shihkefa/esp32c3-card-dealer/README.md

# ESP32-C3 撲克牌發牌機

以 ESP32-C3 SuperMini、28BYJ-48 步進馬達、直流馬達及 3D 列印零件製作的充電式旋轉發牌機。目前版本為 **V1.0.0**。

本頁下載與線上手冊跟隨 `main` 分支的最新修正；`V1.0.0` 標籤保留初次上傳快照。

## 下載與組裝

- **[線上 3D 組裝說明書](https://shihkefa.github.io/esp32c3-card-dealer/)**：直接用電腦或手機開啟，可旋轉、縮放及分解模型，不必先下載。
- [完整專案 ZIP](發牌機_完整專案_V1.0.0.zip)：包含模型、BOM、接線圖、韌體及離線組裝手冊。
- [版本說明與使用入口](V1.0.0/README_先讀這個.txt)
- [Excel BOM](V1.0.0/發牌機_BOM_V1.0.0.xlsx)
- [40 種獨立列印零件](V1.0.0/3d/STL/)
- [整機組裝 STL](V1.0.0/發牌機_整機組裝_V1.0.0.stl)：供檢視組裝位置，請使用獨立零件列印。
- [可修改的 CAD 來源](V1.0.0/3d/source/)
- [韌體來源與燒錄說明](V1.0.0/firmware/)
- [完整接線圖與板型參考](V1.0.0/wiring/)

線上版與離線版使用同一份完整手冊，含 22 個步驟、可旋轉及縮放的 3D 模型、零件與螺絲選取，以及互動接線圖。需要離線使用時，下載並解壓 ZIP，再用瀏覽器開啟 `V1.0.0/manual/發牌機_組裝說明書_V1.0.0.html`。

## 目前設計

- 每局將出牌口朝向第一位玩家；三人逐張轉 120°，四人逐張轉 90°。
- 設定每人張數、玩家人數及餘牌張數；餘牌發往第一、第二位玩家中間。
- 牌倉內寬 61 mm、前後開放，底板與兩側擋板連續封實，底牌取牌輪由預留開口露出；牌路向出牌口下傾 6°，靠重力落牌。參考牌型為 57×87 mm 與 60×96 mm。
- OLED 與四個按鍵位於上殼頂部；韌體預設關閉 Wi-Fi 與 BLE。
- 使用單顆 18650、Type-C 充電；依本版接線說明關機充電。
- 列印件以拓竹 A1 mini 的尺寸範圍設計；螺絲採 M3×8 與 M3×25 內六角沉頭兩種規格。

## 最新機構修訂

P08 改為 **2.4 mm 連續底板與實心兩側擋板**，保留原本約 **23 × 12 mm** 的取牌輪開口及固定孔。兩側頂緣在 6° 傾斜組裝後保持水平，與上殼屋頂外表面切齊；牌倉前後仍然開放，內寬仍為 **61 mm**。底板背面的馬達避空為盲凹槽，不貫穿牌面。

這次重印 **P08**；使用 57 mm 窄牌時，另重印兩片配套掛架版 **P12**。P12 導牌本體仍落在牌倉底面，中央掛架適配高側板，左右使用同一個 STL。除了 P08 與選配 P12，其他 **38 種 STL**、安裝位置及五金用量均沿用。

先前 P04B 齒圈被承載盤／馬達固定孔誤切的缺口已修復，**60 齒、全齒寬 7.5 mm** 的連續齒形保留。

P04A 與 P02A 頂圈的 **2 mm** 名義間隙、上半部抬高 **1.5 mm**、原軸承與滑環高度及所有五金位置均維持。如果尚未更新到先前的 2 mm 間隙設計，仍需搭配薄片向下延長 1.5 mm 的 P26。

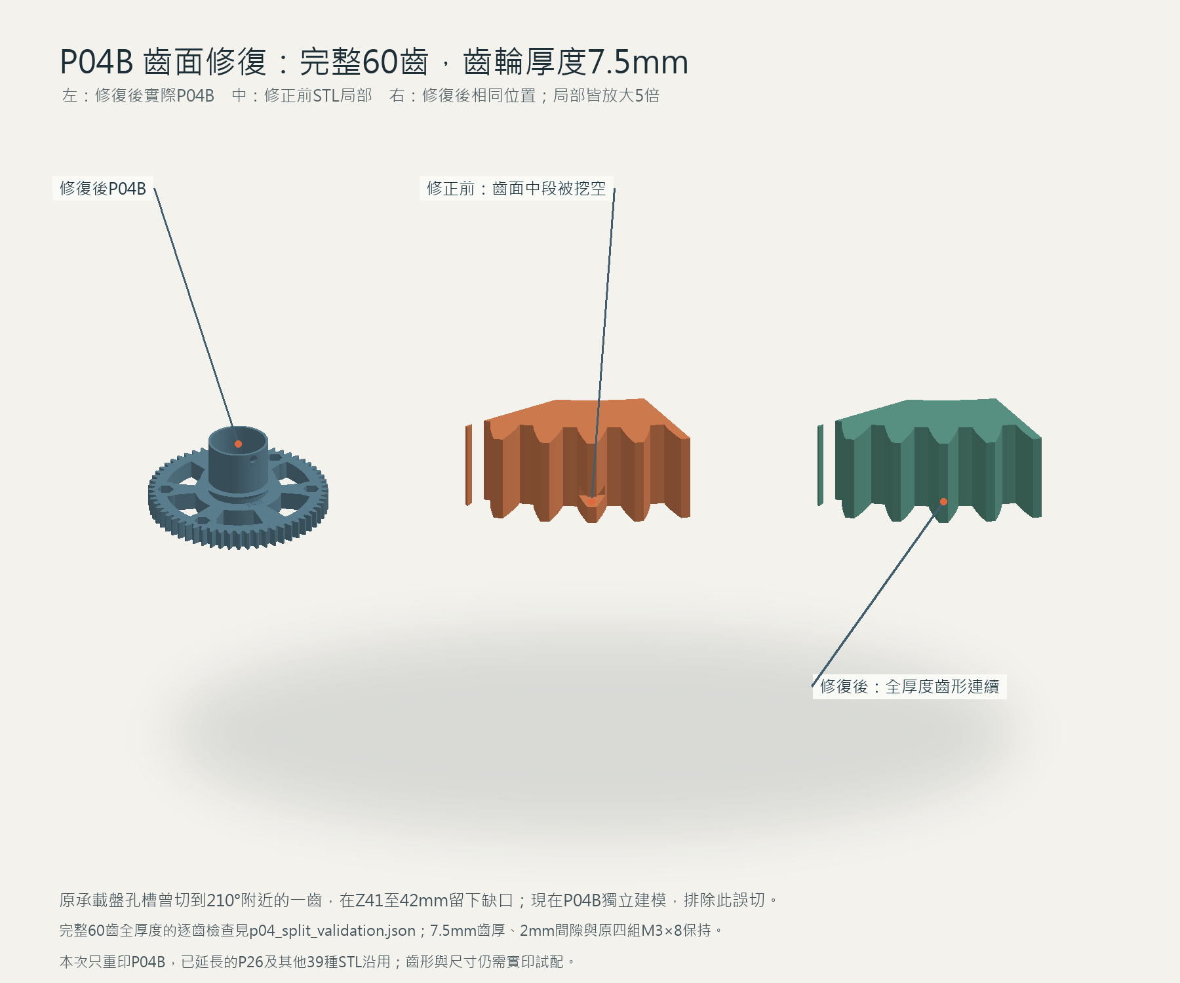
[picture p1: V1.0.0/3d/P04B_完整60齒檢查.png]
P04B 完整 60 齒檢查


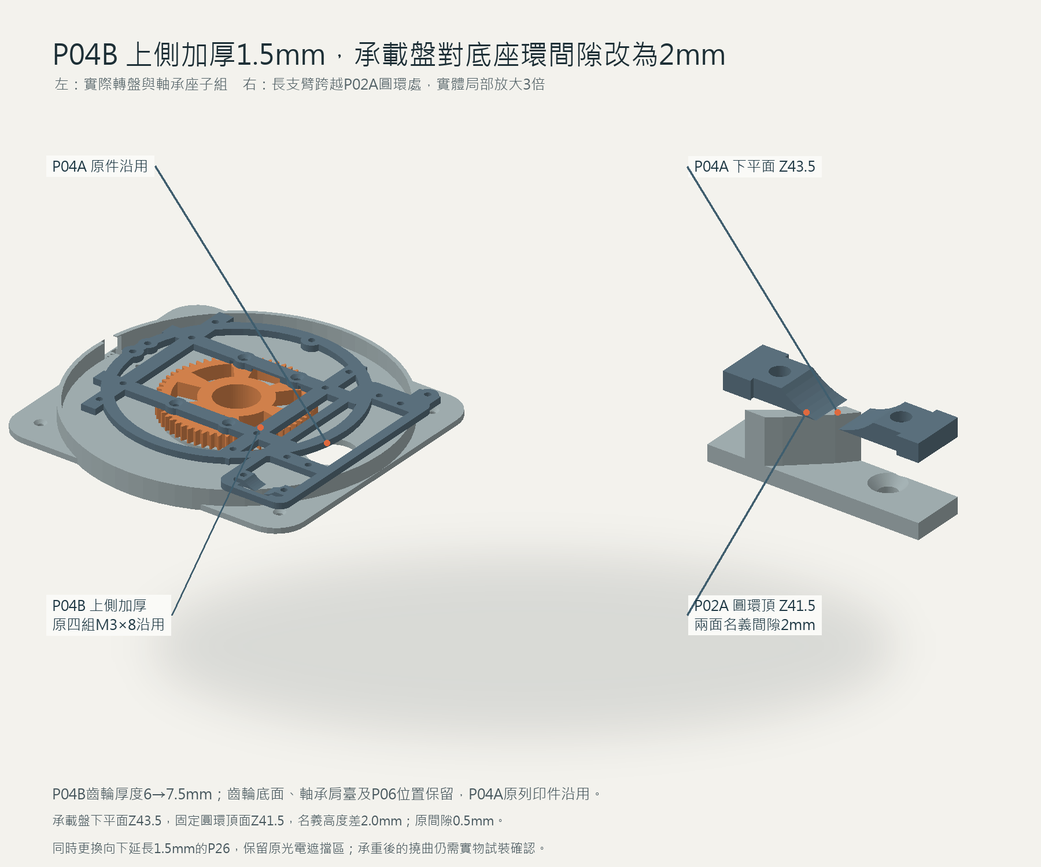
[picture p2: V1.0.0/3d/P04B_抬高與2mm間隙.png]
P04B 加厚與 2 mm 間隙


版本維持 V1.0.0。`main` 與線上手冊提供目前修正內容；Git 標籤 `V1.0.0` 保留首次上傳的快照。

## 驗證與限制

本版已完成模型干涉、離散旋轉及裝入路徑、螺絲螺母配合、STL 完整性和離線手冊的檢查，紀錄位於 [verification](V1.0.0/verification/) 及 [3d](V1.0.0/3d/)。這些是名義模型驗證；載重撓曲、實印公差、實際模組尺寸、耗電及發牌速度仍需試裝與實測。現有 28BYJ-48 與外部 2:1 減速配置不能保證逐張轉向時每秒 2～4 張。

[SHA-256 檔案校驗表](V1.0.0/SHA256SUMS.txt) 對應版本資料夾內的交付檔；本儲存庫保留原始位元組，避免換行轉換影響校驗。

第三方元件、文件與程式庫保留其原有來源及授權說明。

## 更新線上手冊

重新建立版本資料夾中的手冊後，執行 `python scripts/update_pages.py --version V1.0.0`，再將更新後的 `docs/` 提交並推送到 `main`。GitHub Pages 從 `main` 的 `/docs` 發布，入口為 `docs/index.html`；`.nojekyll` 保留原始 HTML，Three.js 授權另置於同目錄。
