shihkefa/esp32c3-card-dealer/V1.0.0/3d/P02B_螺母槽近照.png

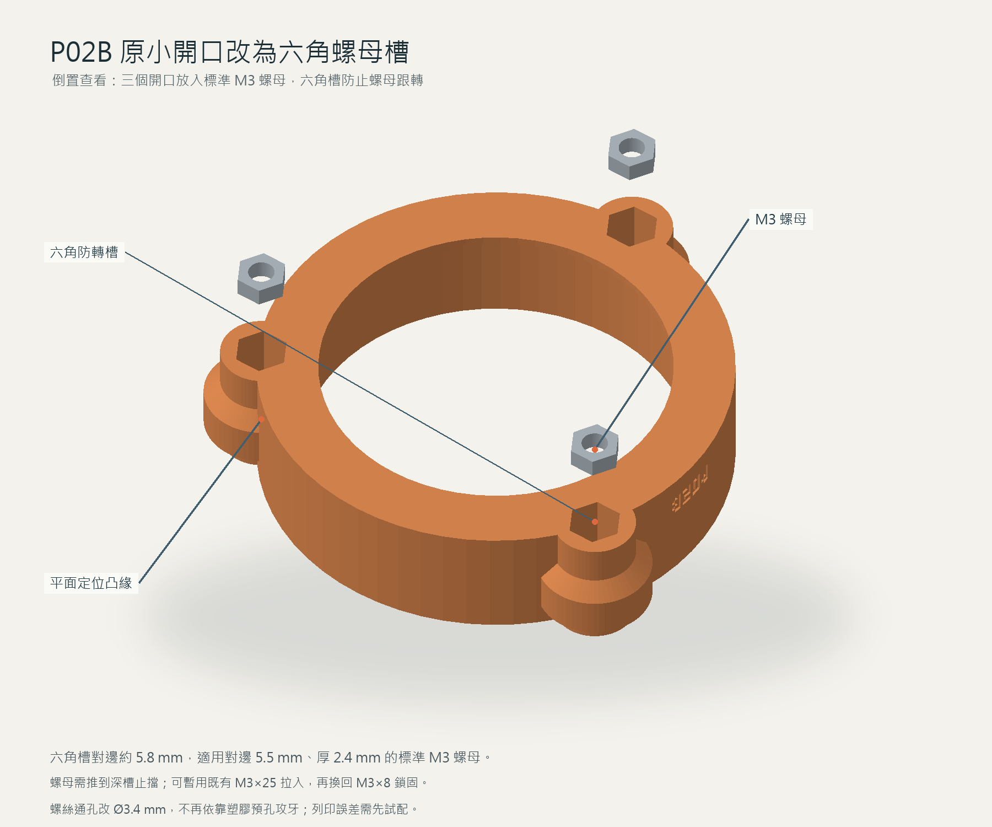
V1.0.0/3d/P02B_螺母槽近照.png
