shihkefa/esp32c3-card-dealer/V1.0.0/3d/P04_分件組裝說明.png

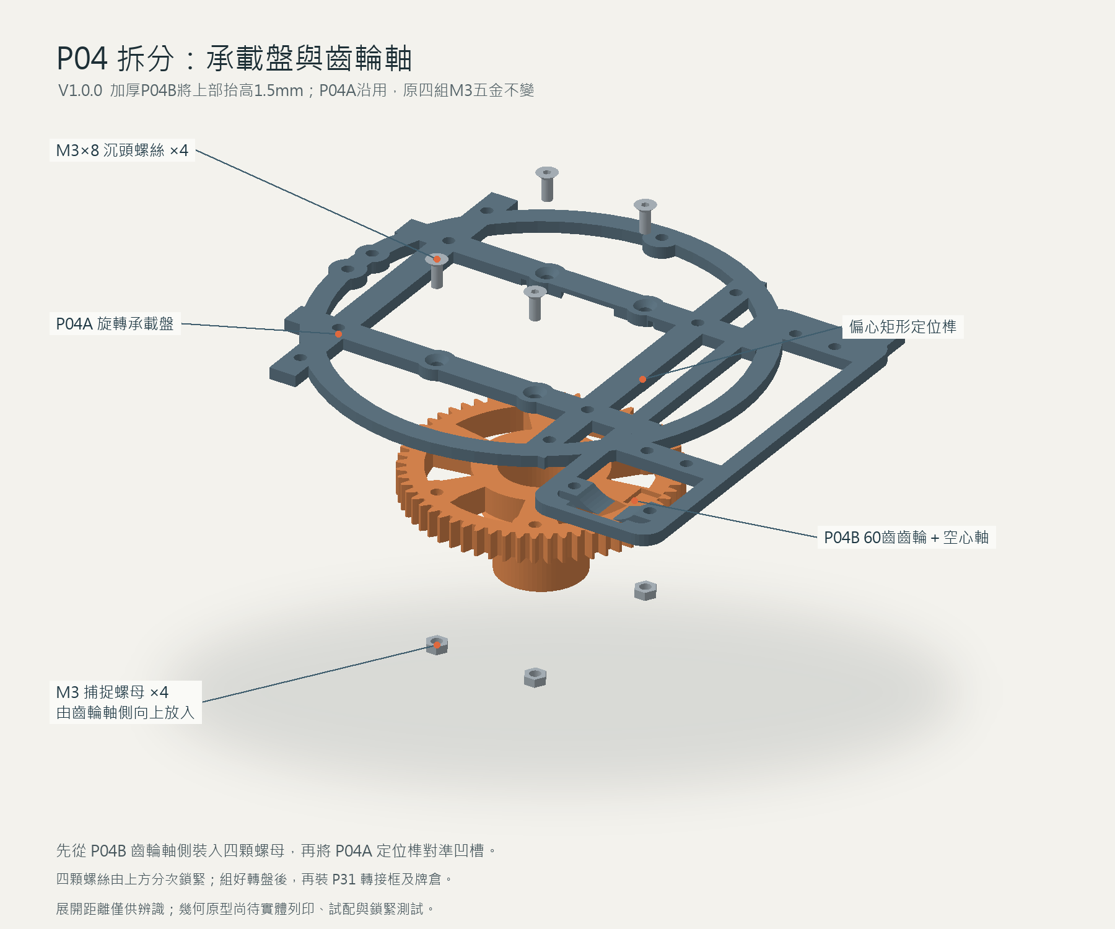
V1.0.0/3d/P04_分件組裝說明.png
