shihkefa/esp32c3-card-dealer/V1.0.0/3d/P05_L工具鎖付順序.png

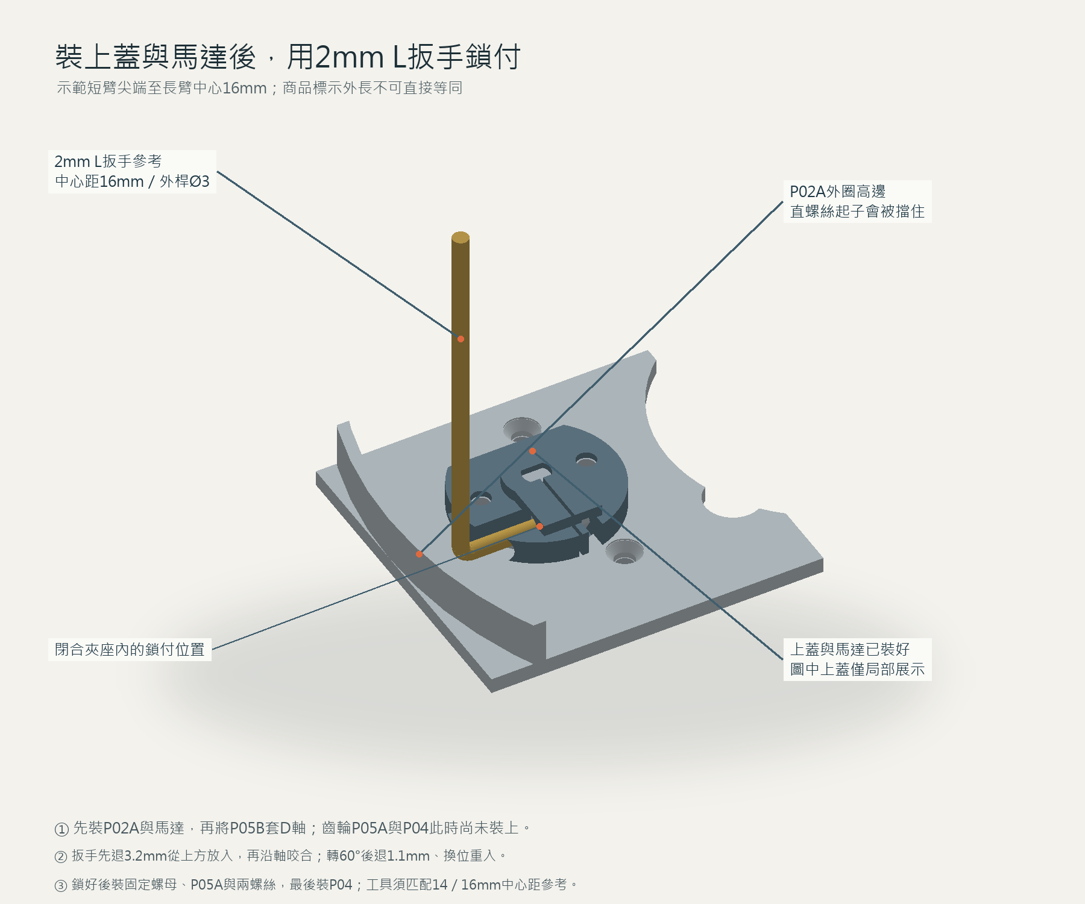
V1.0.0/3d/P05_L工具鎖付順序.png
