shihkefa/esp32c3-card-dealer/V1.0.0/3d/P05_分件組裝與閉合夾座.png

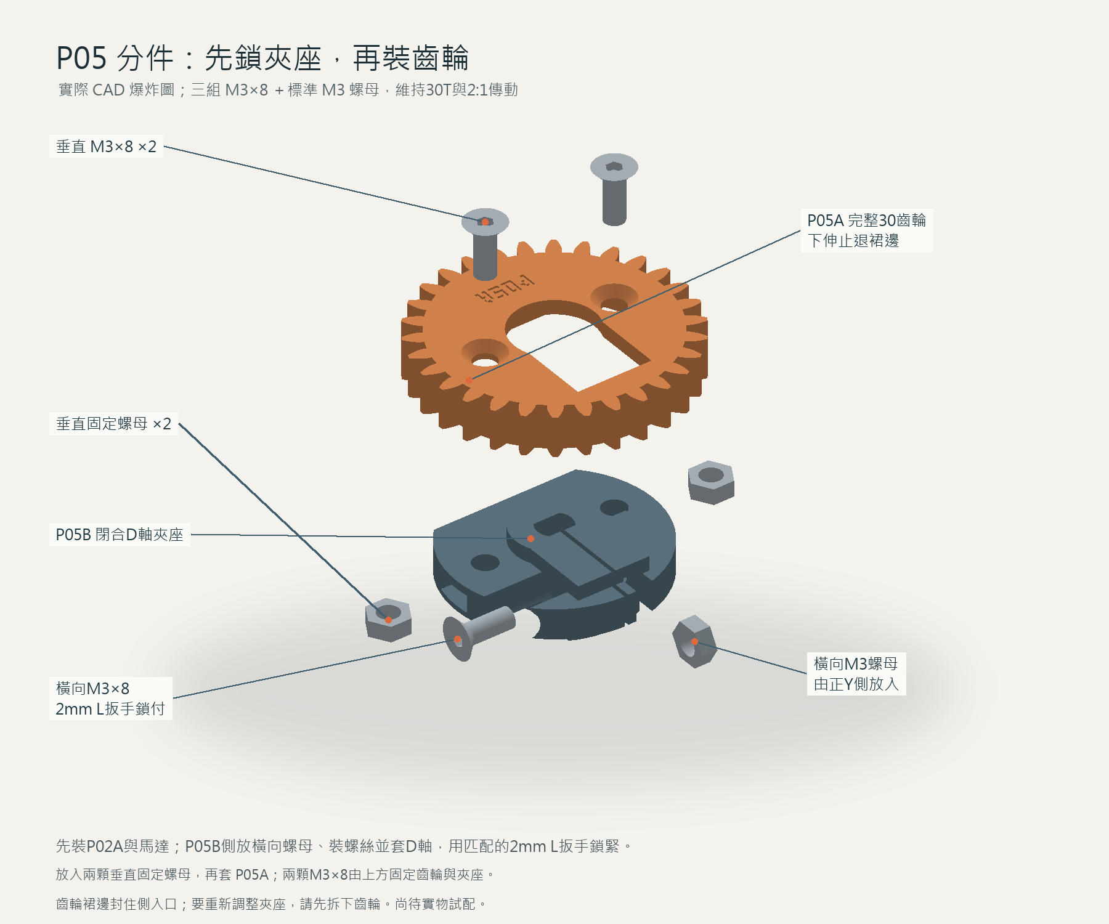
V1.0.0/3d/P05_分件組裝與閉合夾座.png
