shihkefa/esp32c3-card-dealer/V1.0.0/3d/P05_列印方向.png

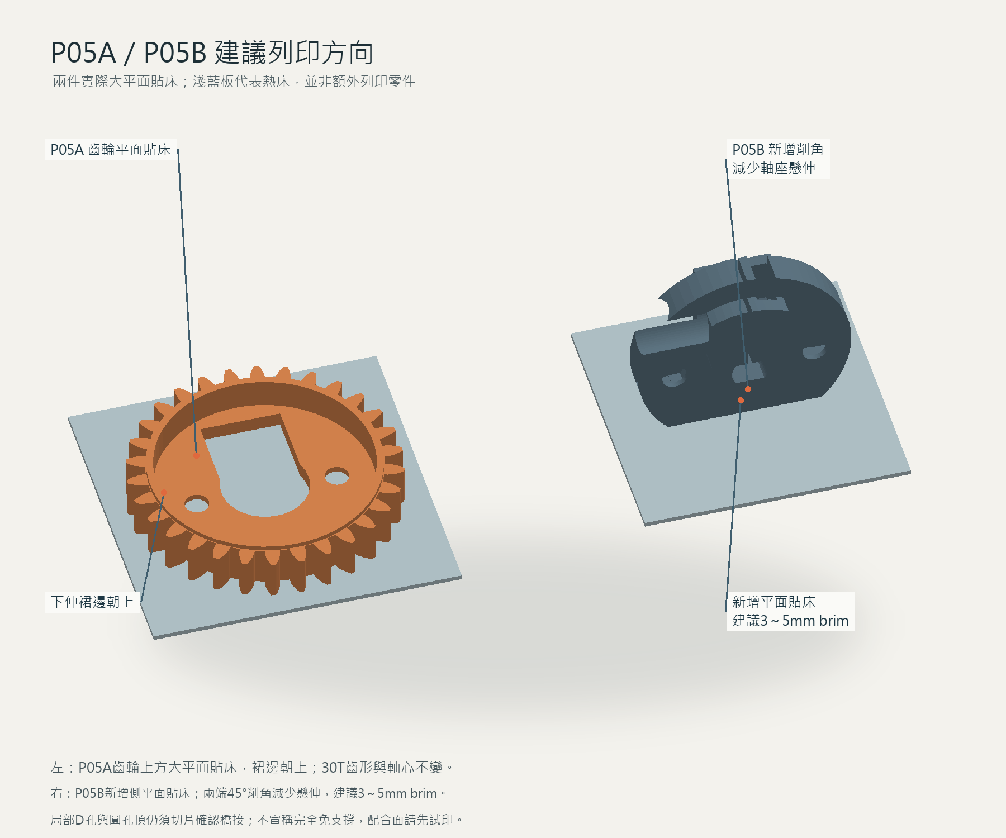
V1.0.0/3d/P05_列印方向.png
