shihkefa/esp32c3-card-dealer/V1.0.0/3d/P05_完整承壓與防脫剖示.png

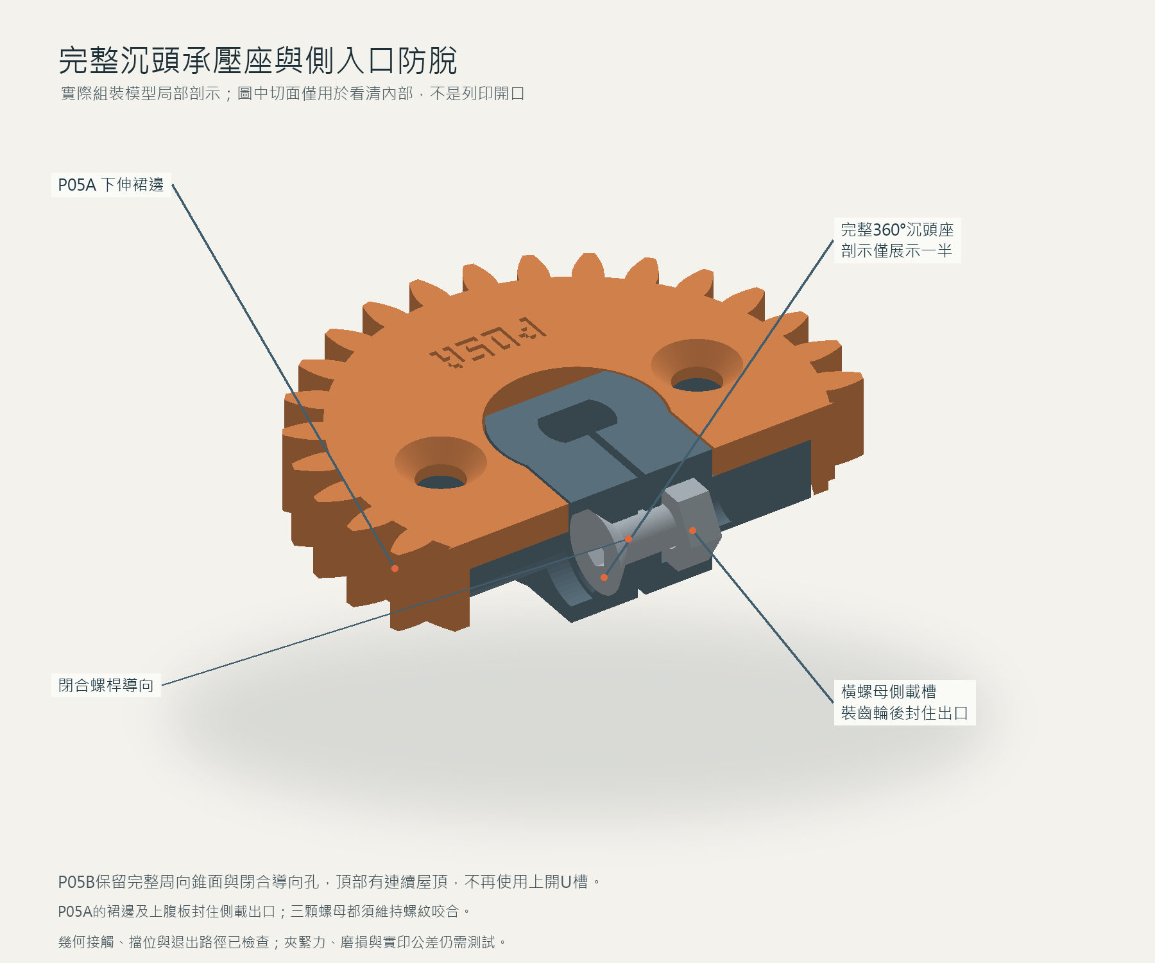
V1.0.0/3d/P05_完整承壓與防脫剖示.png
