shihkefa/esp32c3-card-dealer/V1.0.0/3d/P05A_P05B_平口配合.png

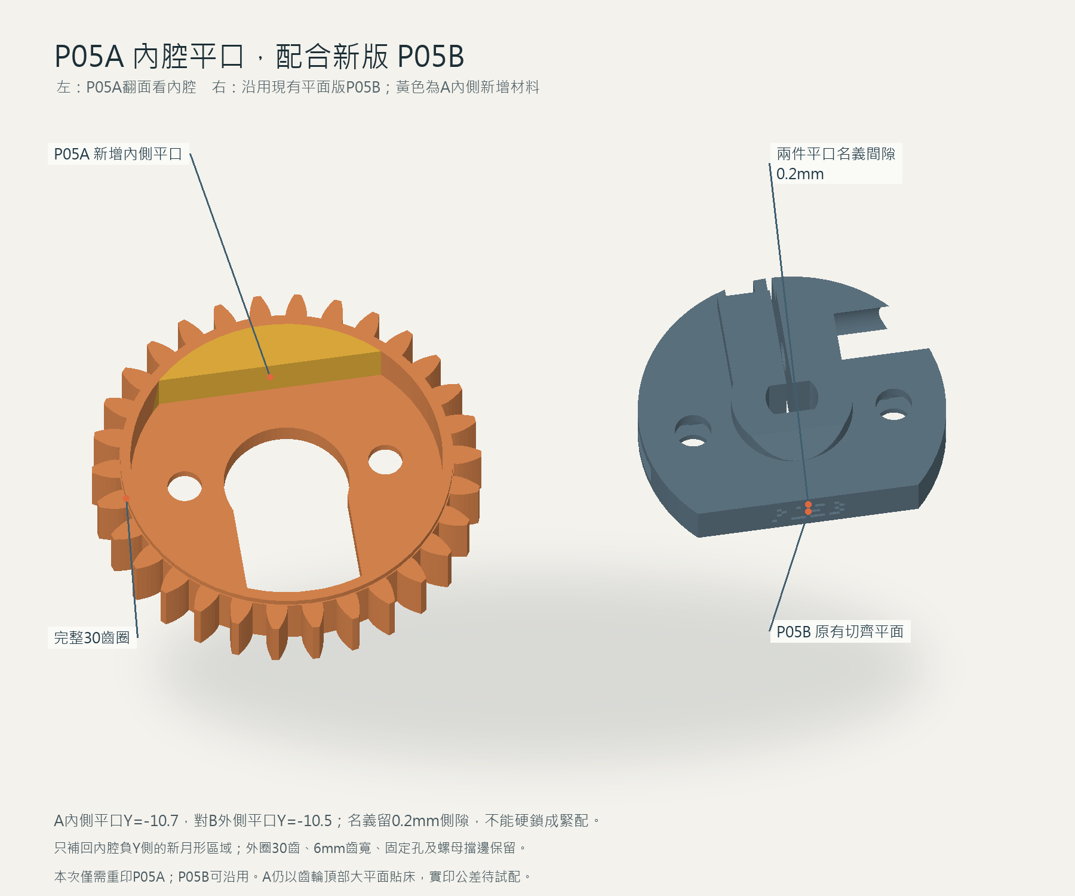
V1.0.0/3d/P05A_P05B_平口配合.png
