shihkefa/esp32c3-card-dealer/V1.0.0/3d/P05B_平面貼床與削角.png

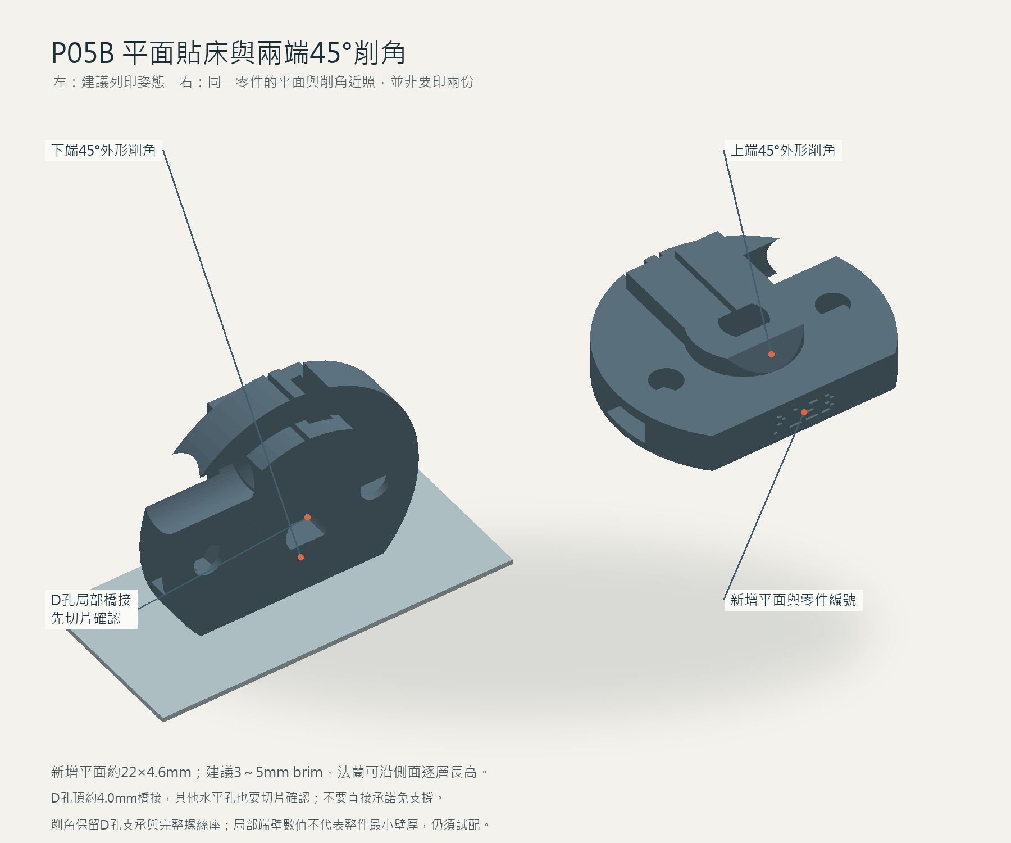
V1.0.0/3d/P05B_平面貼床與削角.png
