shihkefa/esp32c3-card-dealer/V1.0.0/3d/P06_捕捉螺母與調整螺絲.png

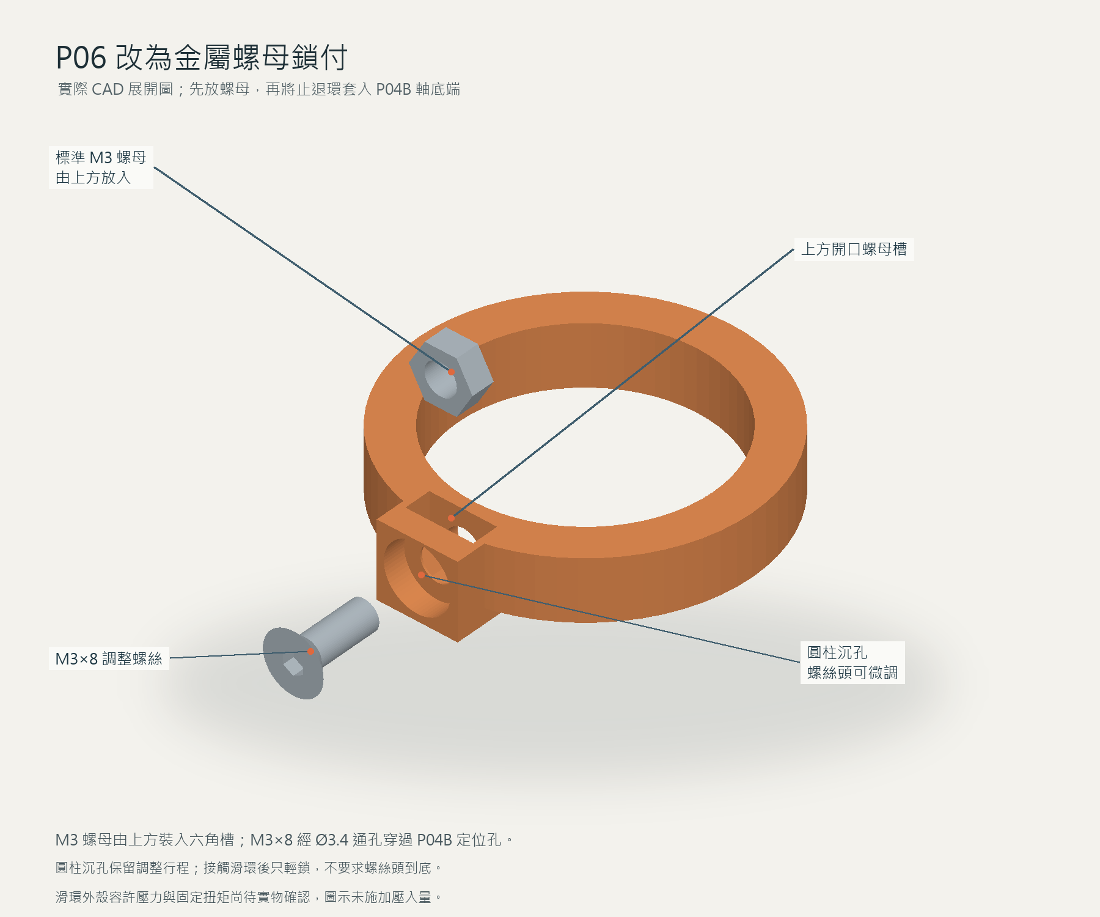
V1.0.0/3d/P06_捕捉螺母與調整螺絲.png
