shihkefa/esp32c3-card-dealer/V1.0.0/3d/P08_P12中央掛架配合.png

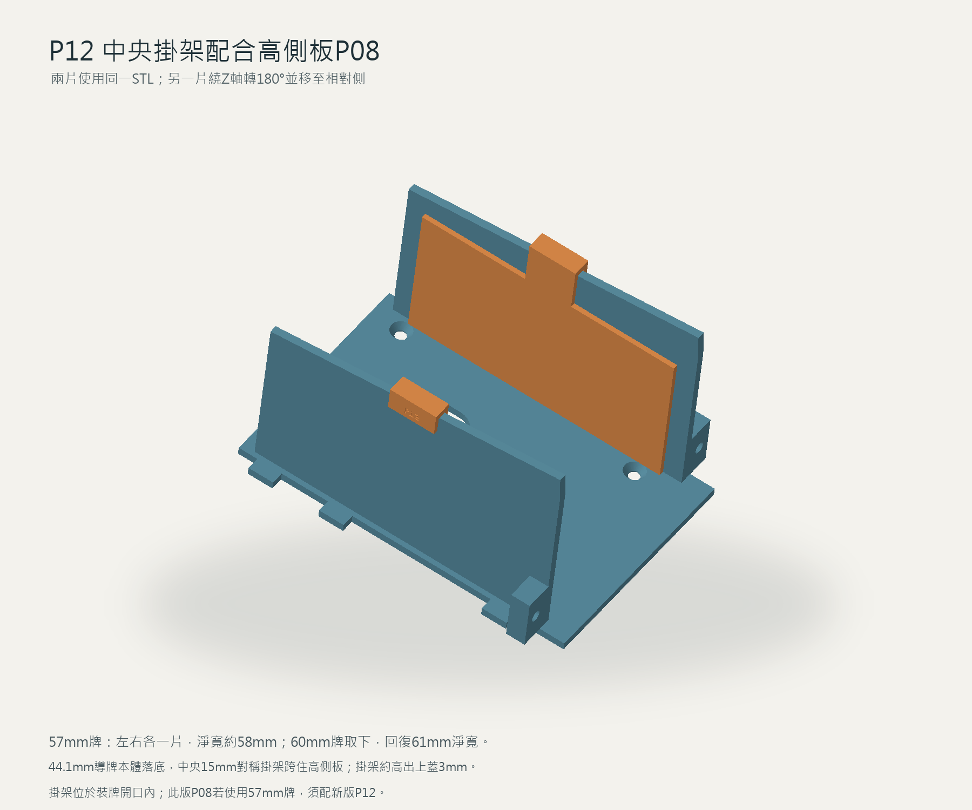
V1.0.0/3d/P08_P12中央掛架配合.png
