shihkefa/esp32c3-card-dealer/V1.0.0/3d/P08_封底高側板與上蓋齊平.png

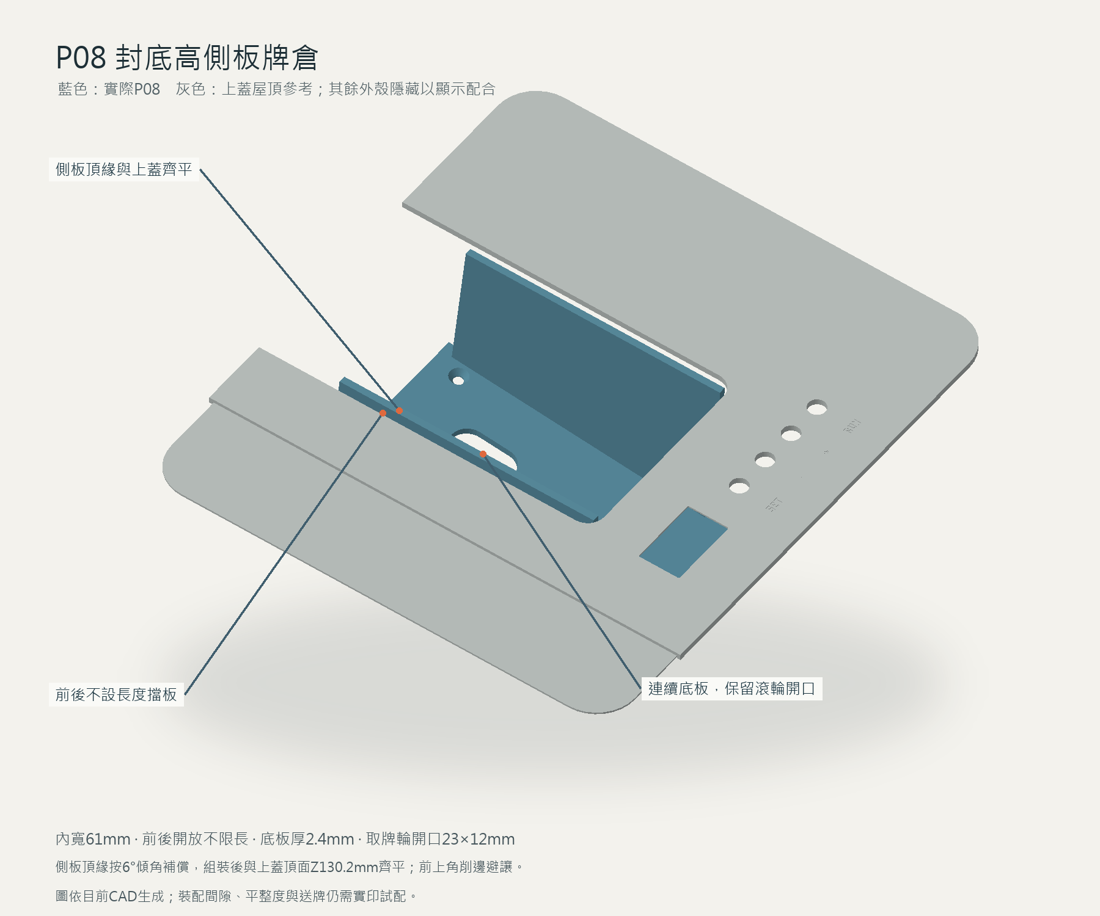
V1.0.0/3d/P08_封底高側板與上蓋齊平.png
