shihkefa/esp32c3-card-dealer/V1.0.0/3d/P08_底面盲槽與滾輪開口.png

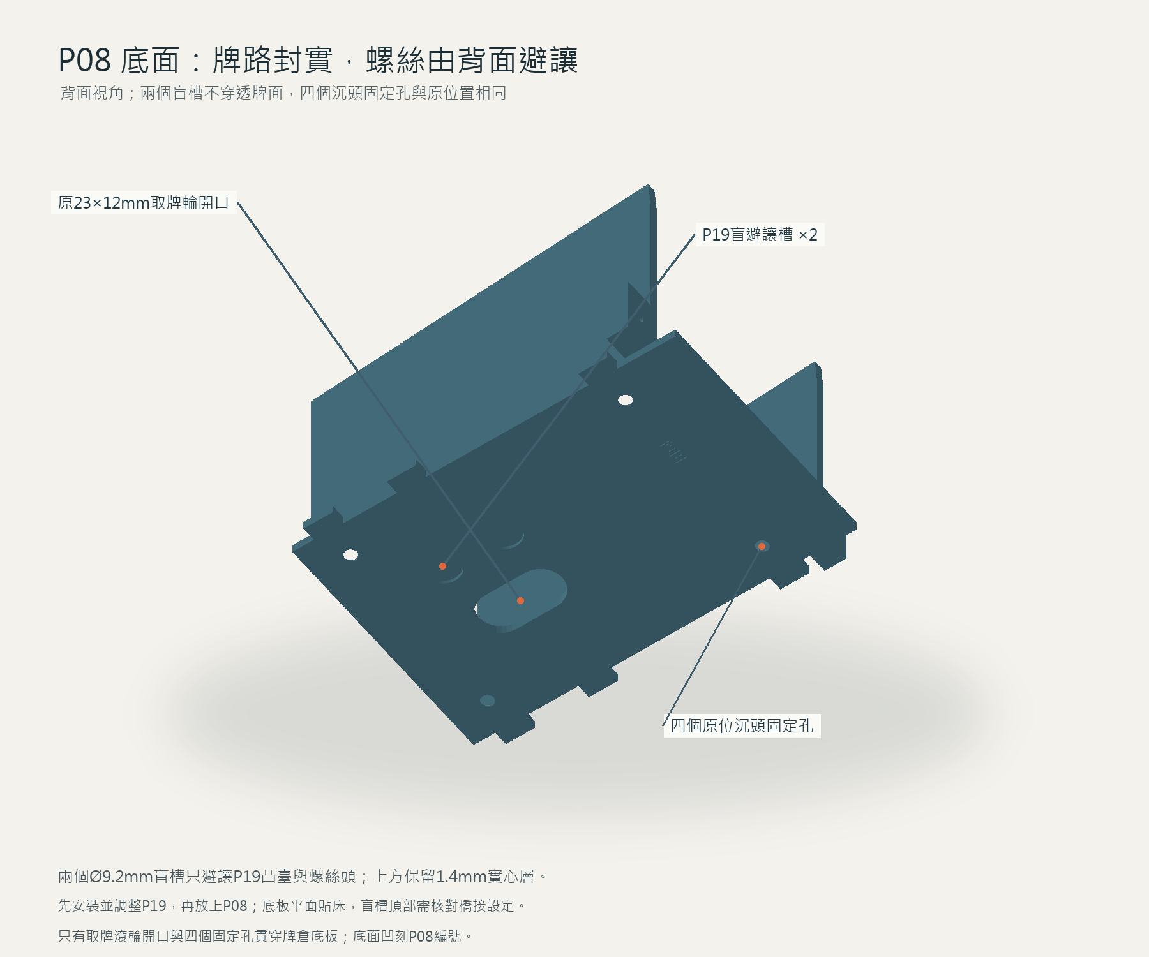
V1.0.0/3d/P08_底面盲槽與滾輪開口.png
