shihkefa/esp32c3-card-dealer/V1.0.0/3d/P32_台階包覆與接縫.png

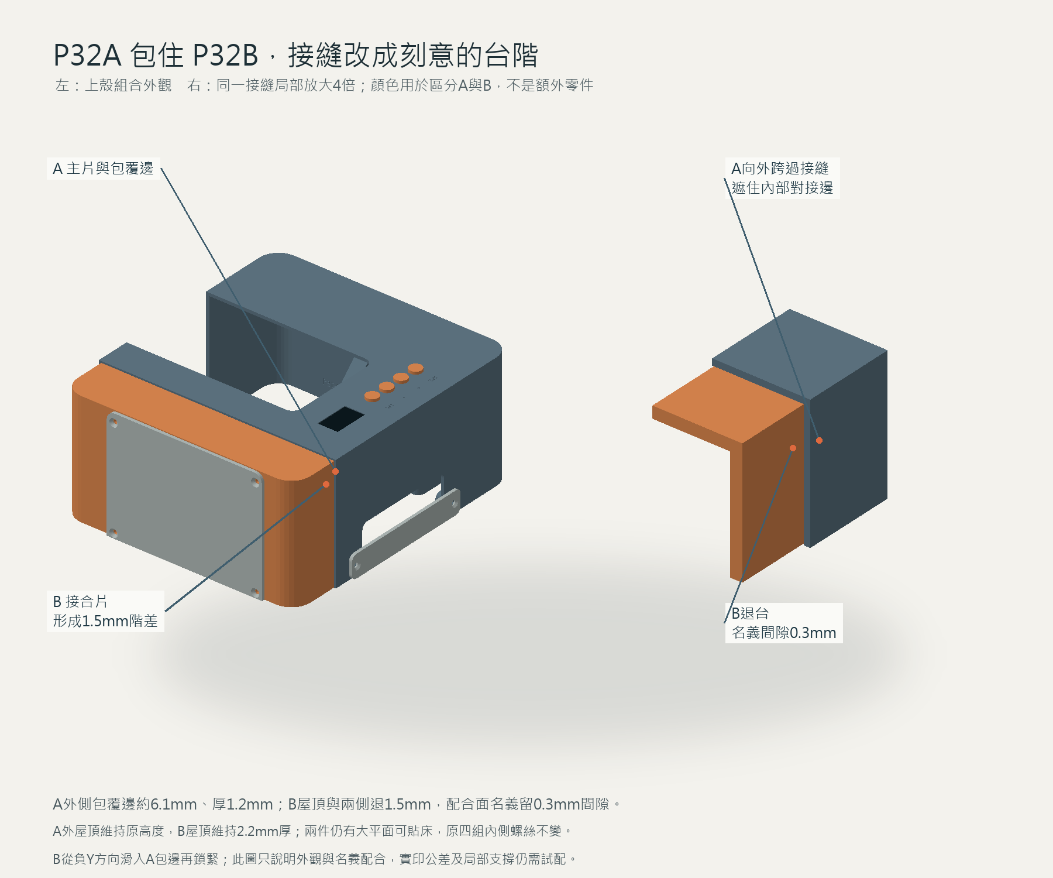
V1.0.0/3d/P32_台階包覆與接縫.png
