shihkefa/esp32c3-card-dealer/V1.0.0/3d/P32_居中與分件組裝.png

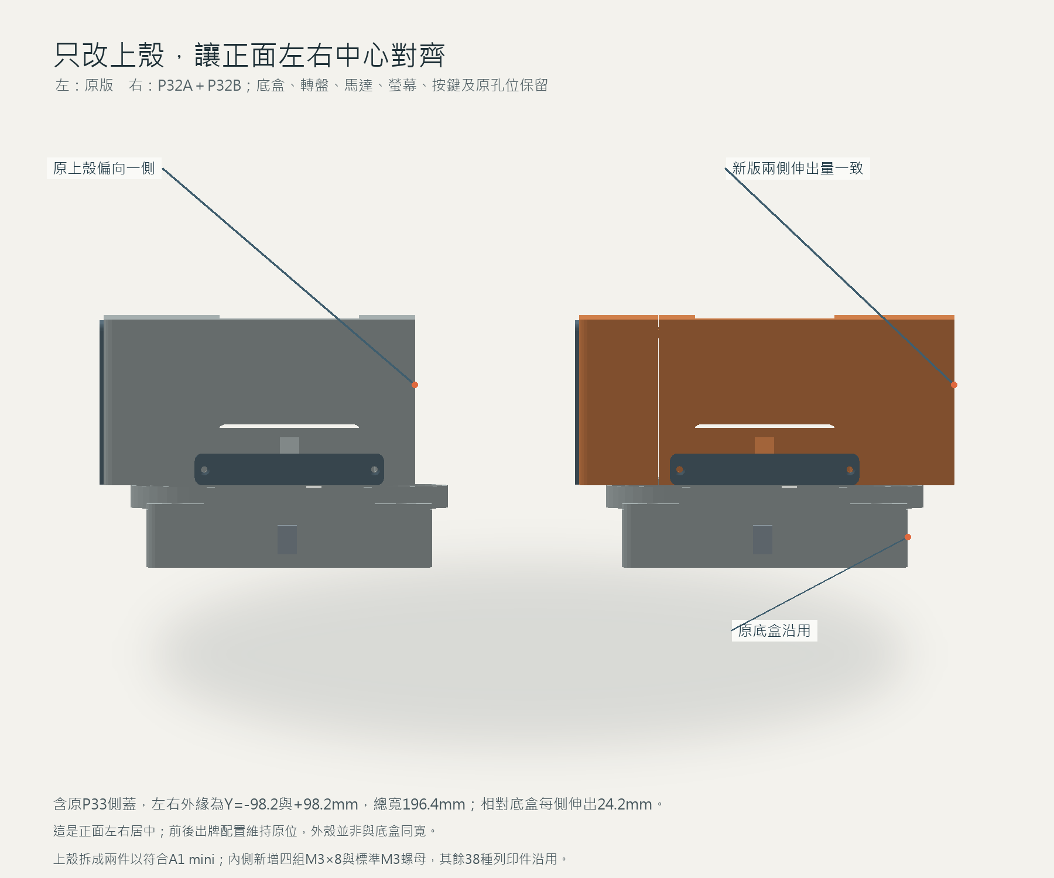
V1.0.0/3d/P32_居中與分件組裝.png
