shihkefa/esp32c3-card-dealer/V1.0.0/3d/part_numbering_check.png

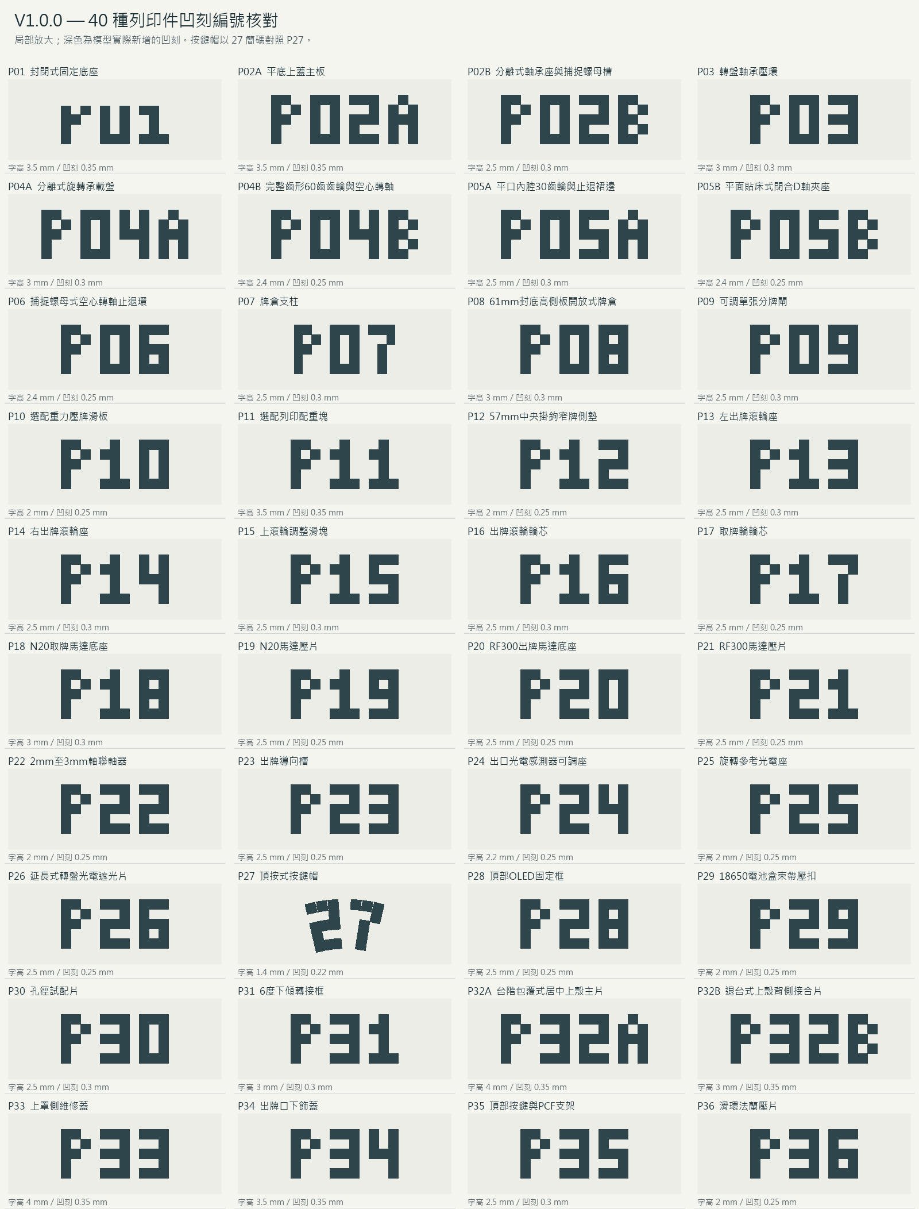
V1.0.0/3d/part_numbering_check.png
