shihkefa/esp32c3-card-dealer/V1.0.0/3d/top_controls_view.png

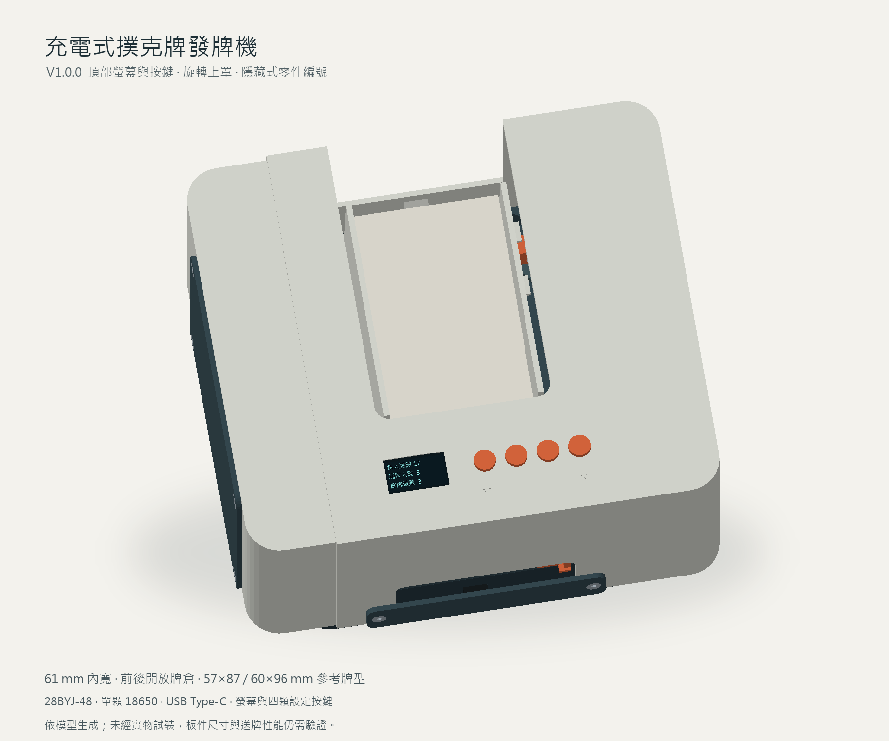
V1.0.0/3d/top_controls_view.png
