shihkefa/esp32c3-card-dealer/V1.0.0/firmware/docs/OLED操作預覽.png

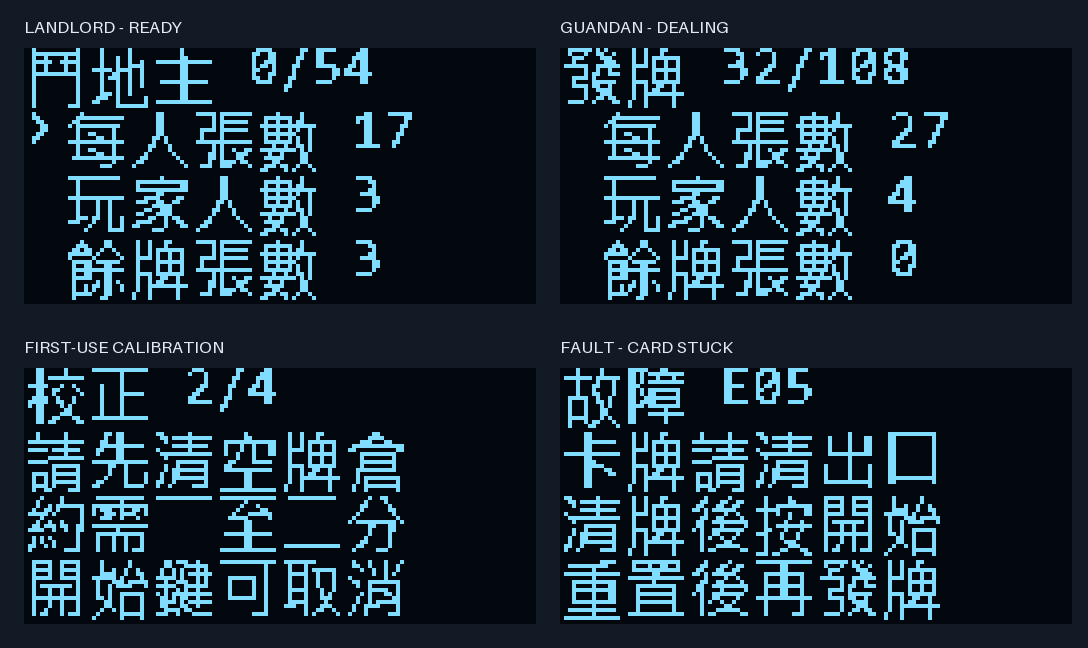
V1.0.0/firmware/docs/OLED操作預覽.png
