shihkefa/esp32c3-card-dealer/V1.0.0/manual/assets/overview.jpg

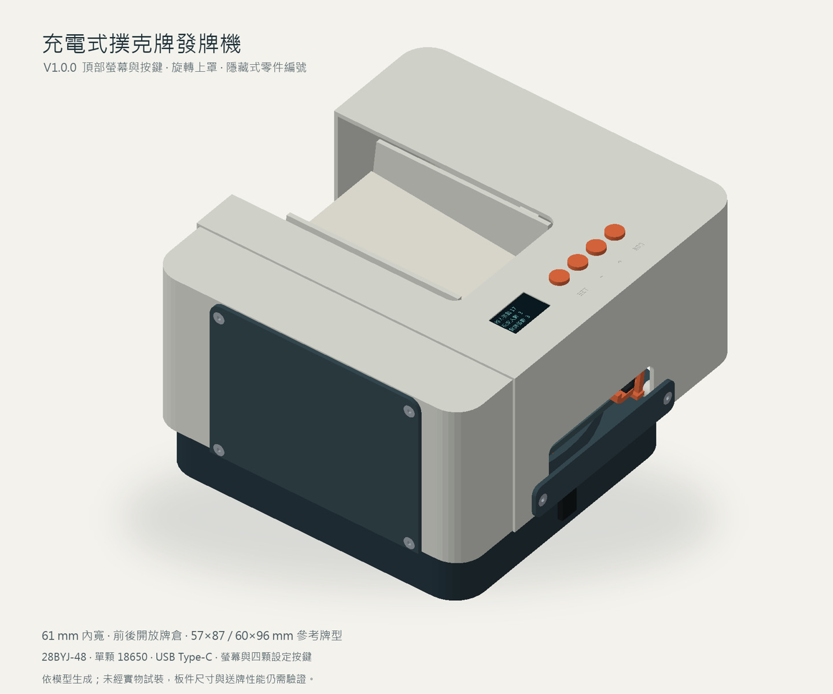
V1.0.0/manual/assets/overview.jpg
