shihkefa/esp32c3-card-dealer/V1.0.0/source/references/pictorial/charge.png

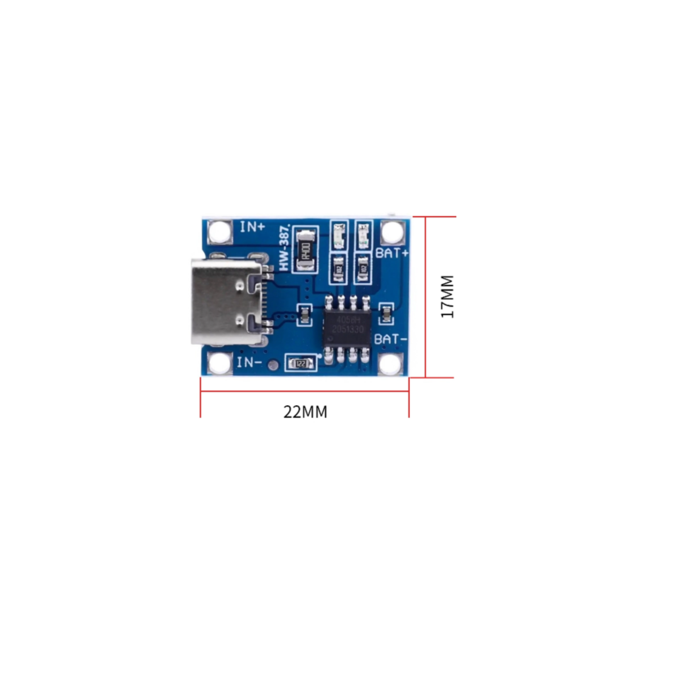
V1.0.0/source/references/pictorial/charge.png
