shihkefa/esp32c3-card-dealer/V1.0.0/source/references/pictorial/pcf1.jpg

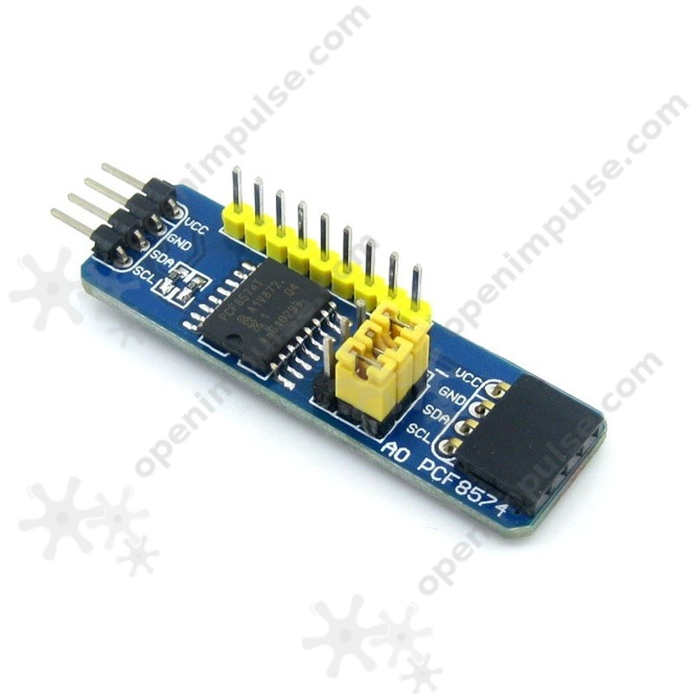
V1.0.0/source/references/pictorial/pcf1.jpg
