shihkefa/esp32c3-card-dealer/V1.0.0/source/references/pictorial/pcf4.jpg

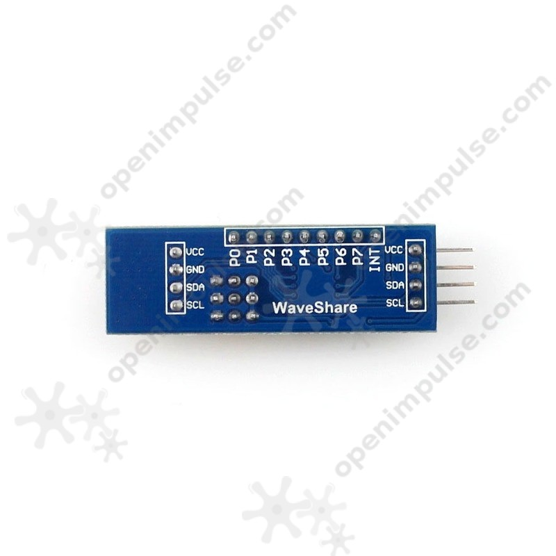
V1.0.0/source/references/pictorial/pcf4.jpg
