shihkefa/esp32c3-card-dealer/V1.0.0/source/references/pictorial/protect6.jpg

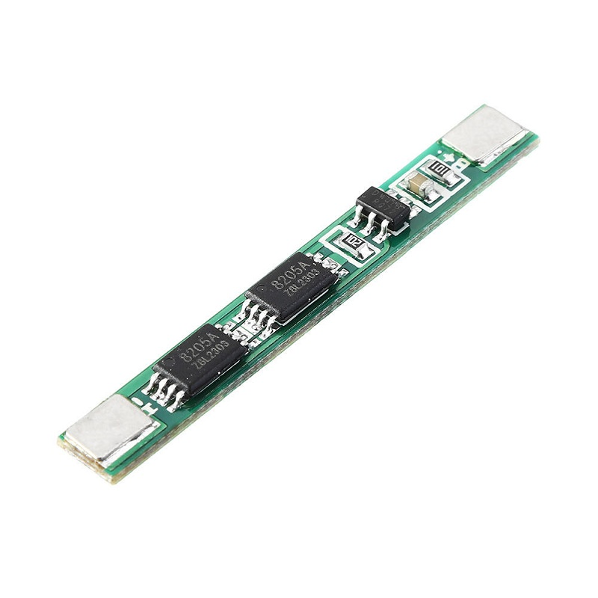
V1.0.0/source/references/pictorial/protect6.jpg
