shihkefa/esp32c3-card-dealer/V1.0.0/發牌機_BOM_V1.0.0.xlsx

Sheet: BOM
撲克牌發牌機 BOM
V1.0.0 封底加高牌倉 P32台階上殼 兩規格螺絲 Type-C
2026-11-11更新。P08底板與側板封實，側板上緣與上蓋齊平；P12配合新高度。其他38種STL及五金數量沿用。
預算上限 | ¥80.00 |  | 外購材料 | ¥80.50 |  | 耗材 | ¥34.00 |  | 運費預留 | ¥9.50 |  | 超出預算
總計 | ¥124.00 |  | 預算餘額 | -¥44.00 |  | 外購含運 | ¥90.00 |  | 實價合計 | 未填實價 |  | 人民幣 CNY
淡黃色欄可編輯。已有量按初始庫存填入；實價空白表示尚未報價，並非零元。
含耗材總額超出80元時顯示紅色；外購加運費與含耗材總額分別列示。
編號 | 材料／零件 | 指定規格 | 需用量 | 已有量 | 待備量 | 單位 | 目標單價 | 目標金額 | 實際單價 | 實價金額 | 取得方式 | 採購狀態 | 淘寶搜尋詞 | 用途與待確認事項 | 商品參考 | 規格來源 | 選定商品連結（可填）
A01 | ESP32-C3 開發板 | ESP32-C3 SuperMini，原生USB，4MB Flash。 | 1 | 1 | 0 | 片 |  | ¥0.00 |  | ¥0.00 | 採購 | 已有 |  | 使用者確認已有此板型；USB接電腦前拔除JP-ESP5V，GND共地。Wi-Fi與BLE保持關閉。 |  | 規格資料 (https://documentation.espressif.com/esp32-c3_datasheet_en.html)
A02 | 18650 鋰離子電池 | 2900mAh。設計前提：單節 3.6/3.7V，充滿 4.2V。 | 1 | 1 | 0 | 顆 |  | ¥0.00 |  | ¥0.00 | 採購 | 已有 |  | 使用者確認已有；型號、保護情況及允許充放電電流待核對。
A03 | USB 充電器 | 5V / 2A，沿用已有充電器。 | 1 | 1 | 0 | 個 |  | ¥0.00 |  | ¥0.00 | 採購 | 已有 |  | 只作充電輸入，充電電流由充電板設定。
A04 | 拓竹 A1 mini 3D 印表機 | 列印空間 180 × 180 × 180mm。 | 1 | 1 | 0 | 台 |  | ¥0.00 |  | ¥0.00 | 既有設備 | 已有 |  | 製作設備，非裝入發牌機的零件。 |  | 規格資料 (https://bambulab.cn/zh-cn/a1-mini/tech-specs)
B01 | 旋轉馬達與驅動板 | 28BYJ-48 5V + ULN2003 X113647/ZC-A0591。 | 1 | 0 | 1 | 組 | ¥6.00 | ¥6.00 |  |  | 採購 | 待購 | 28BYJ-48 5V ULN2003 套装 | 選含馬達與七輸入驅動板的整組；42×30mm板與固定座須試配。外加60:30齒輪，2:1減速。 | 商品線索（待核價） (https://tao.hooos.com/goods_pW3w974Uxt6Zk53qJkseeaTptm-Gn755MIjNKqprqHo.html) | 規格資料 (https://www.electrokit.com/upload/product/41014/41014801/28byj48-5v.pdf)
B02 | 取牌減速馬達 | N20含金屬減速箱，5V約500rpm；可選6V/500rpm款以5V供電。 | 1 | 0 | 1 | 顆 | ¥5.00 | ¥5.00 |  |  | 採購 | 待購 | N20 6V 500转 3mm D轴 金属减速箱 低功率 | 3mm D軸、出軸約10mm、無編碼器，本體含減速箱按12×10×26mm。6V/500rpm款在5V全速空載粗估420rpm，非實測；負載及PWM會更低。核對尺寸及堵轉電流，選低功率型；升壓仍設5V。
B03 | 出牌直流馬達 | RF-300FA-12350，約24.4mm外徑，約18mm長軸。 | 1 | 0 | 1 | 顆 | ¥2.00 | ¥2.00 |  |  | 採購 | 待購 | RF-300FA-12350 5.9V 长轴18mm | 使用5V；模型馬達夾座與聯軸器按長軸版規劃，採購前核對軸長。 | 商品線索（待核價） (https://tao.hooos.com/goods_NxoJyO0F5tzwBn3fxZGhRtB-RWRNNzu2zdvGaYwi6.html) | 規格資料 (https://product.mabuchi-motor.co.jp/detail.html?id=74)
B04 | 雙路直流馬達驅動板 | DRV8833 HW-627十二腳黑板，5V供電、3.3V控制。 | 1 | 0 | 1 | 片 | ¥3.00 | ¥3.00 |  |  | 採購 | 待購 | DRV8833 双路 直流电机 驱动模块 | 依指定板型焊接面腳序接線；EEP接本板VCC 5V，IN4接GND。持續電流須配合馬達及散熱。 | 商品線索（待核價） (https://tao.k7dj.com/goods-9zNMqODRIBtODY84Pg6h22GsQt6-qKZqqrSnnmd8yywuo.html) | 規格資料 (https://www.ti.com/product/DRV8833)
B05 | OLED 螢幕 | 0.96吋、128×64、SSD1306、4針 IIC。 | 1 | 0 | 1 | 片 | ¥7.00 | ¥7.00 |  |  | 採購 | 待購 | 0.96 OLED 12864 SSD1306 4针 IIC | 上罩水平固定。參考PCB27.3×27.8、玻璃19.3×26.7，背面元件與接腳須量測；顯示每人張數/玩家/餘牌。 | 商品線索（待核價） (https://item.taobao.com/item.htm?id=40809409804) | 規格資料 (https://wiki.lckfb.com/zh-hans/coloreasyduino/module/screen/0-96-iic-single-screen.html)
B06 | 按鍵 IO 擴展板 | PCF8574T長條9孔IO板，3.3V，I2C地址0x20。 | 1 | 0 | 1 | 片 | ¥2.00 | ¥2.00 |  |  | 採購 | 待購 | PCF8574T 8路 IO扩展模块 I2C | 指定Waveshare式長條板；P0–P3四按鍵、P4旋轉參考，A0–A2接GND。P35固定座需按實物重新試配。 |  | 規格資料 (https://www.ti.com/product/PCF8574)
B07 | 輕觸按鍵 | 6×6mm，高度9.5mm，兩腳／四腳常開型。 | 4 | 0 | 4 | 顆 | ¥0.25 | ¥1.00 |  |  | 採購 | 待購 | 轻触开关 6x6x9.5 | 設定、減、加、開始/暫停各一顆；按鍵帽與板位置可微調。
B08 | 導電滑環 | 12路，每路至少2A，外徑≤22mm；參考總長26.5mm。 | 1 | 0 | 1 | 個 | ¥20.00 | ¥20.00 |  |  | 採購 | 待購 | 12路 2A 帽式 导电滑环 22mm | 頂部UI使6路不足。使用5V/GND/3.3V/SDA/SCL/取牌2路/出牌1路/出口計數/旋轉參考共10路，餘2路。法蘭參考Ø44.5、孔圓Ø38，實物需核對；20元為配置目標，非12路SKU報價。 | 商品線索（待核價） (https://tao.k7dj.com/goods-D08verAhDt5Xge3OB2sQQYsjtn-QAnppRSjj98rz9SK4.html) | 規格資料 (https://www.panlinkslipring.com/sale-40975477-compact-customized-capsule-slip-rings-for-robotics-mechanical.html)
B09 | 槽型光電感測器 | ITR9608-F 裸件，13×6.8×6mm、槽寬5mm。 | 2 | 0 | 2 | 顆 | ¥1.00 | ¥2.00 |  |  | 採購 | 待購 | ITR9608-F 槽型 光电开关 | 出口計數及旋轉參考。57mm牌時P24與出口感測器向內移1.5mm；本版已建接腳包絡。 |  | 規格資料 (https://media.digikey.com/pdf/data%20sheets/everlight%20pdfs/itr9608-f.pdf)
C01 | 轉盤軸承 | 6005ZZ，25×47×12mm。 | 1 | 0 | 1 | 個 | ¥2.00 | ¥2.00 |  |  | 採購 | 待購 | 6005ZZ 25 47 12 轴承 | 承載轉盤。模型軸承座47.3mm、空心轉軸24.8mm，先試配。 |  | 規格資料 (https://www.skf.com/group/products/rolling-bearings/ball-bearings/deep-groove-ball-bearings/productid-6005-2Z)
C02 | 出牌滾輪軸承 | 623ZZ，3×10×4mm。 | 4 | 0 | 4 | 個 | ¥0.50 | ¥2.00 |  |  | 採購 | 待購 | 623ZZ 3 10 4 微型轴承 | 上、下滾輪各兩顆。模型軸承孔10.3mm。
C03 | 滾輪鋼軸 | 直徑3mm，上軸82mm、下軸92mm，各一支。 | 2 | 0 | 2 | 支 | ¥1.00 | ¥2.00 |  |  | 採購 | 待購 | 3mm 光轴 100mm | 可買100mm各裁至82/92mm；下軸較長以連接外側聯軸器。依實購軸及馬達長度核對。
C04 | 矽膠 O型圈 | 內徑16mm、線徑2mm。 | 6 | 0 | 6 | 個 | ¥0.25 | ¥1.50 |  |  | 採購 | 待購 | 硅胶 O型圈 16x2 | 取牌輪2個，上、下出牌輪各2個；輪槽底徑16.8mm，拉伸後接觸外徑估約20.7mm，依實物調夾持量。
C05 | 橡膠分牌墊 | 裁約55×4×1mm，嵌入P09前面凹袋。 | 1 | 0 | 1 | 片 | ¥0.50 | ¥0.50 |  |  | 採購 | 待購 | 橡胶片 1mm 分页 摩擦垫 | 工作面與閘面對齊，底緣間隙起始0.45mm；固定後依實際牌厚調整。
C07 | 兩規格螺絲及M3螺母 | M3×8內六角沉頭×61、M3×25×10；M3螺母×52。 | 1 | 0 | 1 | 組 | ¥6.00 | ¥6.00 |  |  | 採購 | 待購 | DIN7991 M3x8 M3x25 沉头 内六角 全牙 M3螺母 | 整機只有兩種螺絲；同用2mm內六角。頭徑≤6、頭高≤1.7，長度含頭。取消M2、止付與盤頭。詳見螺絲規格頁及五金數量表。6元為配置目標，包裝最低購量與備品另核。 |  | 規格資料 (https://www.aanddfasteners.co.uk/uploads/media/gbMcC5-media-Din7991Socketcountersunkspecification.pdf)
D01 | Type-C 充電板 | TP4056 HW-387 Type-C無保護版，單節4.2V。 | 1 | 0 | 1 | 片 | ¥1.20 | ¥1.20 |  |  | 採購 | 待購 | TP4056 Type-C 充电板 无保护 C to C | 與獨立保護板搭配。先設0.5A；確認電芯型號後再考慮1A。選支援C-to-C充電的板款。 | 商品線索（待核價） (https://item.taobao.com/item.htm?id=624056967771) | 規格資料 (https://www.toppwr.com/eproduct/view.php?id=478)
D02 | 單節鋰電池保護板 | 1S 5A長條35×7.4mm，DW01及三顆8205A。 | 1 | 0 | 1 | 片 | ¥1.30 | ¥1.30 |  |  | 採購 | 待購 | 1S 3.7V 5A 锂电池 保护板 | 充電板與升壓板都接保護板P端，不旁路保護。額定電流及截止電壓待確認。
D03 | 5V 升壓模組 | TPS61088型，設定輸出5V，常開，目標持續2A。 | 1 | 0 | 1 | 片 | ¥7.50 | ¥7.50 |  |  | 採購 | 待購 | TPS61088 3.7V 转5V 升压模块 | 選完整模組。確認低電池電壓及馬達啟動下仍能供電；初次上電先量輸出5V。 | 商品線索（待核價） (https://tao.hooos.com/goods_WZ042NGCot25YXXngGHaa6SQta-oMZ778FAdjp9wK4T4.html) | 規格資料 (https://www.ti.com/lit/ds/symlink/tps61088.pdf)
D04 | 18650 電池盒 | 單節帶線，約78×22×20mm，接點足夠供應馬達。 | 1 | 0 | 1 | 個 | ¥1.50 | ¥1.50 |  |  | 採購 | 待購 | 18650 单节 带线 电池盒 | 電池盒長度與保護電芯相容性待量測；模型固定扣間距可調。 | 商品線索（待核價） (https://tao.hvcis.com/goods-nzX7QomCMt3YQeVxyVhkkzs0tP-YA3ppxSdQMg6J36IB.html)
D05 | 總電源開關 | 小船型開關，直流額定至少5A。 | 1 | 0 | 1 | 個 | ¥1.00 | ¥1.00 |  |  | 採購 | 待購 | 小船型 电源开关 DC 5A | 放在保護板至升壓板的供電路徑。第一版關機充電。
D06 | USB Type-C 充電線 | 設備端Type-C，依現有充電器選另一端。 | 1 | 0 | 1 | 條 | ¥2.00 | ¥2.00 |  |  | 採購 | 待確認 | USB Type-C 充电线 2A | 充電器已有；線材是否已有未確認。先列入採購，若已有可填已有量1。
E01 | 洞洞板 | 裁成約14×51mm，四按鍵中心距13mm。 | 1 | 0 | 1 | 片 | ¥0.80 | ¥0.80 |  |  | 採購 | 待購 | 洞洞板 2.54mm 小块 | 固定於上罩P35支架；腳距依實物調整，PCF板及螢幕採低矮焊線，未包容高直立杜邦接頭。
E02 | 連接導線 | 訊號線與較粗的馬達／電池供電線。 | 1 | 0 | 1 | 組 | ¥0.80 | ¥0.80 |  |  | 採購 | 待購 | 硅胶线 22AWG 28AWG | 電池及馬達主電源不用細訊號線代替。線長待實際組裝裁切。
E03 | 排針／杜邦接頭 | 2.54mm，足夠連接控制器、螢幕及驅動板。 | 1 | 0 | 1 | 組 | ¥0.50 | ¥0.50 |  |  | 採購 | 待購 | 2.54 排针 杜邦 接头 | 若模組已焊排針，可降低此項新增用量。
E04 | 電阻組 | 150Ω/¼W×2、10kΩ×4、47kΩ×1；充電設定另核。 | 1 | 0 | 1 | 組 | ¥0.30 | ¥0.30 |  |  | 採購 | 待購 | 电阻 10K 150R 220R 2.4K 5.1K | PCF板已有I2C上拉，不另重複加裝。TP4056先設0.5A；PROG與Type-C CC電阻依實板核對。
E05 | 去耦／濾波電容 | 100nF陶瓷×2、470–1000µF/10V電解約2顆。 | 1 | 0 | 1 | 組 | ¥0.60 | ¥0.60 |  |  | 採購 | 待購 | 100nF 104 1000uF 10V 电容 | 馬達端去耦及5V電源緩衝，與PCB內建電容配合。
E06 | 可拆電源接頭 | JST-XH等兩芯接頭，約2組。 | 1 | 0 | 1 | 組 | ¥0.50 | ¥0.50 |  |  | 採購 | 待購 | XH2.54 2P 公母 接线 | 確認極性，方便拆裝電池與旋轉頭。
E07 | 熱縮管／小束帶 | 絕緣與線材固定。 | 1 | 0 | 1 | 組 | ¥0.50 | ¥0.50 |  |  | 採購 | 待購 | 热缩管 小扎带 | 包括光電座及板件的束帶固定。
P01 | 封閉式固定底座 | 164 × 148 × 29.9 mm；PLA / PETG | 1 | 0 | 1 | 件 |  | ¥0.00 |  | ¥0.00 | 自行列印 | 待列印 |  | 底板封閉；後側三條18×1.6mm通風縫。內部橋座穿束帶；接口依實物核對。 編號P01：盒內底板空白區，凹刻0.35mm。 列印方向已放入STL；成本併入耗材。
P02A | 平底上蓋主板 | 164 × 164 × 11.5 mm；PLA / PETG | 1 | 0 | 1 | 件 |  | ¥0.00 |  | ¥0.00 | 自行列印 | 待列印 |  | 大平面朝下列印，軸承座改由底面裝入。中央58.4孔及三個10.4定位孔與P02B配合，名義單邊0.2間隙。共用三顆M3×8及P02B螺母，外圈和底盒孔位保留。 編號P02A：上蓋內面；避開軸承座與定位孔，凹刻0.35mm。 列印方向已放入STL；成本併入耗材。
P02B | 分離式軸承座與捕捉螺母槽 | 63.36 × 64.5 × 14.8 mm；PLA / PETG | 1 | 0 | 1 | 件 |  | ¥0.00 |  | ¥0.00 | 自行列印 | 待列印 |  | 底部環形平面朝下。三處原小孔改5.8對邊六角深槽，先放M3螺母並推至上止擋；螺絲孔3.4。可暫用既有M3×25拉入螺母，再換M3×8。三個下凸緣夾在P02A底面；不在轉軸或軸承工作面刻號。 編號P02B：軸承座外側空白弧面；避開軸承孔與螺母槽，凹刻0.3mm。 列印方向已放入STL；成本併入耗材。
P03 | 轉盤軸承壓環 | 69 × 70 × 4 mm；PLA / PETG | 1 | 0 | 1 | 件 |  | ¥0.00 |  | ¥0.00 | 自行列印 | 待列印 |  | 配合P02A/P02B，最大外徑70，馬達側削平避讓；內孔與三孔位置不變，大平面朝下列印。三顆M3×8同時固定壓環、主板與軸承座，分次均勻鎖緊。 編號P03：壓環上方空白環帶；避開孔與軸承接觸面，凹刻0.3mm。 列印方向已放入STL；成本併入耗材。
P04A | 分離式旋轉承載盤 | 144 × 134 × 4.6 mm；PLA / PETG | 1 | 0 | 1 | 件 |  | ¥0.00 |  | ¥0.00 | 自行列印 | 待列印 |  | 與P04B配套。上方大平面貼床，底面偏心矩形榫定位防轉；四顆M3×8從上方鎖入P04B捕捉螺母。先組成轉盤，再裝P31與牌倉。 編號P04A：轉盤背面支臂；避開定位榫與固定孔，凹刻0.3mm。 列印方向已放入STL；成本併入耗材。
P04B | 完整齒形60齒齒輪與空心轉軸 | 74.4 × 74.4 × 30.5 mm；PLA / PETG；PLA實心換算約24.5g | 1 | 0 | 1 | 件 |  | ¥0.00 |  | ¥0.00 | 自行列印 | 待列印 |  | 修復承載盤螺母槽誤切齒面，B獨立建模，完整60齒貫穿7.5mm厚度。接合面Z43.5、對P02A名義間隙2mm及原M3×8沿用。本次只需重印P04B，P04A、已延長P26及其他零件沿用。齒輪大平面朝下、空心軸朝上。 成本併入耗材。
P05A | 平口內腔30齒輪與止退裙邊 | 38.26 × 38.4 × 6.7 mm；PLA / PETG | 1 | 0 | 1 | 件 |  | ¥0.00 |  | ¥0.00 | 自行列印 | 待列印 |  | 內腔平口Y−10.7配P05B平口Y−10.5，名義側隙0.2mm。保留完整30齒、6mm齒寬與防脫裙邊。先鎖B再裝A，以兩組M3×8與M3螺母固定。既有平面版B可沿用，配合公差待試印。 頂部大平面貼床；成本併入耗材。
P05B | 平面貼床式閉合D軸夾座 | 30.4 × 9.5 × 25.69 mm；PLA / PETG | 1 | 0 | 1 | 件 |  | ¥0.00 |  | ¥0.00 | 自行列印 | 待列印 |  | 背側削成約22×4.6mm平面，配兩處45度外形削角，依STL側放列印，減少法蘭懸空；仍須檢查孔頂橋接。先從正Y側放橫向M3螺母，再沿X側裝M3×8；保留完整360度沉頭座、閉合3.4mm導向孔與D軸配合面。馬達與P02A先就位，再套D軸，用符合工具圖尺寸的2mm L型扳手鎖緊，最後裝P05A。兩顆垂直固定螺母從左右側裝入，由齒輪裙邊封住入口；螺絲與螺母仍需保持咬合，夾持力與實印公差待試配。 編號P05B：背側新增貼床平面；避開D軸孔、側載槽與承壓面，凹刻0.25mm。 列印方向已放入STL；成本併入耗材。
P06 | 捕捉螺母式空心轉軸止退環 | 36 × 33 × 7.5 mm；PLA / PETG | 1 | 0 | 1 | 件 |  | ¥0.00 |  | ¥0.00 | 自行列印 | 待列印 |  | 先由上方裝M3螺母，再從軸底端套入P04B並對齊徑向孔。M3×8穿通孔後僅輕壓滑環轉子；圓柱沉孔留微調行程，不要求螺絲頭到底。實物滑環殼體可承受壓力與抗轉能力待試裝。 編號P06：止退環隱藏小平臺；避開徑向固定孔及軸承接觸面，凹刻0.25mm。 列印方向已放入STL；成本併入耗材。
P07 | 牌倉支柱 | 9 × 9 × 16.2 mm；PLA / PETG | 4 | 0 | 4 | 件 |  | ¥0.00 |  | ¥0.00 | 自行列印 | 待列印 |  | 四支位於(-45/31, ±26)，使用M3沉頭長螺絲。 編號P07：支柱外側中央；避開端面與螺絲孔，凹刻0.3mm。 列印方向已放入STL；成本併入耗材。
P08 | 61mm封底高側板開放式牌倉 | 106 × 83 × 61.85 mm；PLA / PETG；PLA實心換算約53.5g | 1 | 0 | 1 | 件 |  | ¥0.00 |  | ¥0.00 | 自行列印 | 待列印 |  | 2.4mm連續底板，兩側板加高至上蓋齊平。內寬61mm、前後開放。保留23×12mm滾輪孔及固定孔；底面盲槽避讓P19。57mm牌配新版P12。 成本併入耗材。
P09 | 可調單張分牌閘 | 14 × 85 × 7.5 mm；PLA / PETG | 1 | 0 | 1 | 件 |  | ¥0.00 |  | ¥0.00 | 自行列印 | 待列印 |  | 起始間隙0.45mm；以實際牌厚調整。下緣貼小片橡膠分牌墊。 編號P09：分牌閘固定耳外側；不接觸牌面，凹刻0.3mm。 列印方向已放入STL；成本併入耗材。
P10 | 選配重力壓牌滑板 | 51 × 55 × 3 mm；PLA / PETG | 1 | 0 | 1 | 件 |  | ¥0.00 |  | ¥0.00 | 自行列印 | 待列印 |  | 選配；直接放在牌疊上，自由下落。底面磨平，35.5×39.5mm淺槽供P11定位。無導桿、無彈簧。 編號P10：壓牌滑板後側薄邊；避開牌面與配重槽，凹刻0.25mm。 列印方向已放入STL；成本併入耗材。
P11 | 選配列印配重塊 | 35 × 39 × 20 mm；PLA / PETG | 1 | 0 | 1 | 件 |  | ¥0.00 |  | ¥0.00 | 自行列印 | 待列印 |  | 選配；壓力不足才放在P10上。可改列印高度或填充率調重量；100%實心約33g。需實秤。 編號P11：配重塊底面中央隱藏區，凹刻0.35mm。 列印方向已放入STL；成本併入耗材。
P12 | 57mm中央掛鉤窄牌側墊 | 82 × 57.67 × 5.9 mm；PLA / PETG；PLA實心換算約7.4g | 2 | 0 | 2 | 件 |  | ¥0.00 |  | ¥0.00 | 自行列印 | 待列印 |  | 配新版高側板P08，57mm牌左右各一片、內寬約58mm；60mm牌取下。底邊坐底板，中央掛鉤約高出上蓋3mm。另一片轉180°後X移-8mm。 成本併入耗材。
P13 | 左出牌滾輪座 | 25 × 12 × 41.6 mm；PLA / PETG | 1 | 0 | 1 | 件 |  | ¥0.00 |  | ¥0.00 | 自行列印 | 待列印 |  | 編號P13：滾輪座後側實心區；避開軸承孔和導槽，凹刻0.3mm。 列印方向已放入STL；成本併入耗材。
P14 | 右出牌滾輪座 | 25 × 12 × 41.6 mm；PLA / PETG | 1 | 0 | 1 | 件 |  | ¥0.00 |  | ¥0.00 | 自行列印 | 待列印 |  | 編號P14：滾輪座後側實心區；避開軸承孔和導槽，凹刻0.3mm。 列印方向已放入STL；成本併入耗材。
P15 | 上滾輪調整滑塊 | 13.3 × 12 × 6.5 mm；PLA / PETG | 2 | 0 | 2 | 件 |  | ¥0.00 |  | ¥0.00 | 自行列印 | 待列印 |  | 左右對稱裝入導槽，以頂部M3螺絲調整夾持間隙。 編號P15：滑塊背面；避開軸孔、軸承座和上方調整接觸點，凹刻0.3mm。 列印方向已放入STL；成本併入耗材。
P16 | 出牌滾輪輪芯 | 18.99 × 19 × 54 mm；PLA / PETG | 2 | 0 | 2 | 件 |  | ¥0.00 |  | ¥0.00 | 自行列印 | 待列印 |  | 兩件相同；開縫輪轂用M3×8沉頭及M3螺母夾緊，取消止付。硬輪轂外徑19mm，O圈維持原規格。 編號P16：輪芯端面空白區；避開輪槽、軸孔及摩擦圓周，凹刻0.3mm。 列印方向已放入STL；成本併入耗材。
P17 | 取牌輪輪芯 | 18.99 × 19 × 10 mm；PLA / PETG | 1 | 0 | 1 | 件 |  | ¥0.00 |  | ¥0.00 | 自行列印 | 待列印 |  | N20的3mm D軸；M3×8沉頭＋M3螺母夾緊，O型圈×2，取消止付。 編號P17：取牌輪端面；避開O圈槽、軸孔與接觸圓周，凹刻0.25mm。 列印方向已放入STL；成本併入耗材。
P18 | N20取牌馬達底座 | 28 × 30.5 × 13.6 mm；PLA / PETG | 1 | 0 | 1 | 件 |  | ¥0.00 |  | ¥0.00 | 自行列印 | 待列印 |  | 編號P18：馬達座底面空白區，凹刻0.3mm。 列印方向已放入STL；成本併入耗材。
P19 | N20馬達壓片 | 25.2 × 8.4 × 3.2 mm；PLA / PETG | 1 | 0 | 1 | 件 |  | ¥0.00 |  | ¥0.00 | 自行列印 | 待列印 |  | 編號P19：壓片上面中央；位於牌倉下方，凹刻0.25mm。 列印方向已放入STL；成本併入耗材。
P20 | RF300出牌馬達底座 | 36 × 27 × 19.8 mm；PLA / PETG | 1 | 0 | 1 | 件 |  | ¥0.00 |  | ¥0.00 | 自行列印 | 待列印 |  | RF300約24.4mm、長軸約18mm。兩顆M3×25同時固定壓片、馬達座及P31，取消另外兩顆底座螺絲。 編號P20：底座下方側翼；避開馬達弧座及螺絲孔，凹刻0.25mm。 列印方向已放入STL；成本併入耗材。
P21 | RF300馬達壓片 | 35 × 8 × 3 mm；PLA / PETG | 1 | 0 | 1 | 件 |  | ¥0.00 |  | ¥0.00 | 自行列印 | 待列印 |  | 編號P21：壓片上方中央；避開馬達弧面，凹刻0.25mm。 列印方向已放入STL；成本併入耗材。
P22 | 2mm至3mm軸聯軸器 | 19 × 19 × 18 mm；PLA / PETG | 1 | 0 | 1 | 件 |  | ¥0.00 |  | ¥0.00 | 自行列印 | 待列印 |  | 兩端獨立開縫，各M3×8沉頭＋M3螺母夾緊；取消止付。外徑19，需用新版P31避讓。 編號P22：聯軸器端面環帶；避開軸孔及止付孔，凹刻0.25mm。 列印方向已放入STL；成本併入耗材。
P23 | 出牌導向槽 | 33.5 × 80 × 12.9 mm；PLA / PETG | 1 | 0 | 1 | 件 |  | ¥0.00 |  | ¥0.00 | 自行列印 | 待列印 |  | 兩側M3水平鎖入滾輪座，出口留光電避讓缺口。滾輪接觸面以O型圈為準。 編號P23：出牌導槽下方前緣；不在牌路表面，凹刻0.25mm。 列印方向已放入STL；成本併入耗材。
P24 | 出口光電感測器可調座 | 21.5 × 16.5 × 18.4 mm；PLA / PETG | 1 | 0 | 1 | 件 |  | ¥0.00 |  | ¥0.00 | 自行列印 | 待列印 |  | 按13×6.8×6mm、5mm槽寬ITR9608-F包絡；57mm牌時連同感測器向內移1.5mm，8mm長孔調整。 編號P24：出口座背板外側；避開接腳與束帶孔，凹刻0.25mm。 列印方向已放入STL；成本併入耗材。
P25 | 旋轉參考光電座 | 22.5 × 13 × 13 mm；PLA / PETG | 1 | 0 | 1 | 件 |  | ¥0.00 |  | ¥0.00 | 自行列印 | 待列印 |  | 用於每圈參考標記。螺絲長孔可校正位置。 編號P25：參考感測座底面；避開固定孔與接腳孔，凹刻0.25mm。 列印方向已放入STL；成本併入耗材。
P26 | 延長式轉盤光電遮光片 | 25 × 10 × 7.9 mm；PLA / PETG；PLA實心換算約0.4g | 1 | 0 | 1 | 件 |  | ¥0.00 |  | ¥0.00 | 自行列印 | 待列印 |  | 配P04B抬升1.5mm，遮光薄片向下延長1.5mm；組裝後下緣仍為Z35.6，原感測器光路與槽底0.3mm名義間隙保留。安裝孔及支臂沿用，依STL平面貼床。 成本併入耗材。
P27 | 頂按式按鍵帽 | 9 × 9 × 6.35 mm；PLA / PETG | 4 | 0 | 4 | 件 |  | ¥0.00 |  | ¥0.00 | 自行列印 | 待列印 |  | 自上方按壓；6×6×9.5mm輕觸鍵。帽底至屋頂0.6mm，檢查0至0.35mm行程。 編號27：頂按鍵帽凸緣背面環帶；按壓面無編號，凹刻0.22mm。 列印方向已放入STL；成本併入耗材。
P28 | 頂部OLED固定框 | 44 × 32 × 3.5 mm；PLA / PETG | 1 | 0 | 1 | 件 |  | ¥0.00 |  | ¥0.00 | 自行列印 | 待列印 |  | 27.3×27.8mm板件基準；兩顆M3×8沉頭由下方固定，加厚耳座避免螺絲頂穿外罩。 編號P28：頂部螢幕框底面前側橫條，凹刻0.25mm。 列印方向已放入STL；成本併入耗材。
P29 | 18650電池盒束帶壓扣 | 6 × 31 × 8.6 mm；PLA / PETG | 2 | 0 | 2 | 件 |  | ¥0.00 |  | ¥0.00 | 自行列印 | 待列印 |  | 弧形避讓電芯，側翼壓在電池盒邊緣；束帶穿內部橋座固定，不壓電芯凸起處。 編號P29：束帶壓扣支腳外側；避開電芯避讓弧面，凹刻0.25mm。 列印方向已放入STL；成本併入耗材。
P30 | 孔徑試配片 | 58 × 23 × 6.9 mm；PLA / PETG | 1 | 0 | 1 | 件 |  | ¥0.00 |  | ¥0.00 | 自行列印 | 待列印 |  | 3.0／3.2／3.4／5.0／5.2mm，先調整擠出量及孔補償。此件不裝入成品。 編號P30：試配片孔列旁的工具標示區，凹刻0.3mm。 列印方向已放入STL；成本併入耗材。
P31 | 6度下傾轉接框 | 132.9 × 140.4 × 15.43 mm；PLA / PETG | 1 | 0 | 1 | 件 |  | ¥0.00 |  | ¥0.00 | 自行列印 | 待列印 |  | 平底鎖在旋轉盤，上斜面承接整組牌路；下傾6度、抬高10mm以避讓馬達。支撐建議待切片核對。 編號P31：轉接框內側直立肋面；避開安裝斜面，凹刻0.3mm。 列印方向已放入STL；成本併入耗材。
P32A | 台階包覆式居中上殼主片 | 174 × 159.2 × 85.7 mm；PLA / PETG；PLA實心換算約173.0g | 1 | 0 | 1 | 件 |  | ¥0.00 |  | ¥0.00 | 自行列印 | 待列印 |  | A外側1.2mm包覆邊向B延伸6.1mm，形成明顯台階；與B名義間隙0.3mm。屋頂大平面貼床。先與B在機外用原四組M3×8及螺母從內側連接，其他零件與孔位不變。 成本併入耗材。
P32B | 退台式上殼背側接合片 | 171 × 50.5 × 84.2 mm；PLA / PETG；PLA實心換算約59.2g | 1 | 0 | 1 | 件 |  | ¥0.00 |  | ¥0.00 | 自行列印 | 待列印 |  | B屋頂與側牆內退1.5mm，屋頂厚2.2mm，配A包覆邊留0.3mm名義間隙；屋頂大平面貼床。與A仍用原四組M3×8及螺母，局部橋接與配合公差待切片試印。 成本併入耗材。
P33 | 上罩側維修蓋 | 114 × 83.5 × 2.2 mm；PLA / PETG | 1 | 0 | 1 | 件 |  | ¥0.00 |  | ¥0.00 | 自行列印 | 待列印 |  | 四顆M3×8沉頭螺絲固定；下緣43mm。可拆後調整馬達、分牌閘及清除卡牌。 編號P33：側維修蓋內面；外觀面無字，凹刻0.35mm。 列印方向已放入STL；成本併入耗材。
P34 | 出牌口下飾蓋 | 16.5 × 98 × 2.2 mm；PLA / PETG | 1 | 0 | 1 | 件 |  | ¥0.00 |  | ¥0.00 | 自行列印 | 待列印 |  | 兩顆M3×8沉頭螺絲固定；安裝後保留約74×15mm出牌口。內面刻號，正面保持平整。 編號P34：出牌口下飾蓋內面；外觀面無字，凹刻0.35mm。 列印方向已放入STL；成本併入耗材。
P35 | 頂部按鍵與PCF支架 | 33 × 55 × 24.4 mm；PLA / PETG | 1 | 0 | 1 | 件 |  | ¥0.00 |  | ¥0.00 | 自行列印 | 待列印 |  | 14×51mm按鍵板；四顆M3×8沉頭由內側鎖上罩，PCF板焊線低矮裝配。 編號P35：按鍵支架後側直立框；避開電路板及束帶孔，凹刻0.3mm。 列印方向已放入STL；成本併入耗材。
P36 | 滑環法蘭壓片 | 14.6 × 8 × 6.4 mm；PLA / PETG | 3 | 0 | 3 | 件 |  | ¥0.00 |  | ¥0.00 | 自行列印 | 待列印 |  | M3×8由底座底部凹孔往上鎖入壓片M3螺母。三片相同轉120°。定位小柱適用參考孔圓Ø38；法蘭不同可移位或剪除小柱後暫時定位。 編號P36：滑環壓片內端上面；避開螺母槽、定位柱與法蘭接觸面，凹刻0.25mm。 列印方向已放入STL；成本併入耗材。
F01 | PLA 列印耗材 | 暫留0.85kg；全部模型實心換算約816g（含上罩與選配）。 | 0.85 | 0.00 | 0.85 | kg | ¥40.00 | ¥34.00 |  |  | 耗材分攤 | 待確認 | PLA 1.75mm 1kg | 保守預留：模型實心質量＋試配片＋25g餘料後向上取50g整數。尚未切片，實際以切片秤重為準；若購整卷按整卷實付核算。
F02 | 運費及價差預留 | 依合單、收貨地及實際SKU調整。 | 1 | 0 | 1 | 筆 | ¥9.50 | ¥9.50 |  |  | 運費預留 | 待確認 |  | 目標預留，不是已確認運費。

Sheet: 設計與列印
設計與列印
內寬61mm，不設後擋板與定長槽；前緣對齊分牌閘。參考57×87與60×96mm，108張容量待實測。
P08連續底板與兩側板加高至上蓋開口，保留61mm內寬與前後開放；P12卡扣配套修改。上蓋、原孔位及五金沿用。
40種STL，基本36種47件，全選含選配及試配片52件。列印方向與局部橋接依各件備註，實物公差待試配。
28BYJ-48搭配2:1外部減速，整機速度受逐張轉向限制；本版不以每秒2至4張作性能承諾。
單顆18650，Type-C關機充電；先以0.5A選料，核對電池型號後再設定允許電流。
模式 | 玩家 | 每人張數 | 餘牌 | 間隔角度 | 餘牌位置 | 需放牌數
鬥地主 | 3 | 17 | 3 | 120° | 60° | 54
摜蛋 | 4 | 27 | 0 | 90° |  | 108
四人13張 | 4 | 13 | 0 | 90° |  | 52
三人13張 | 3 | 13 | 13 | 120° | 60° | 52
第一位為開始時的朝向0°。餘牌集中發在第一與第二位之間。三人13張此表按放入52張計。
編號 | 列印零件 | 數量 | X(mm) | Y(mm) | Z(mm) | 支撐 | 檔名 | 配合與組裝備註 | 備料類別 | 材質
P01 | 封閉式固定底座 | 1 | 164.00 | 148.00 | 29.90 | 建議無支撐；待切片 | STL/P01.stl | 底板封閉；後側三條18×1.6mm通風縫。內部橋座穿束帶；接口依實物核對。 編號P01：盒內底板空白區，凹刻0.35mm。 | 組裝件 | PLA / PETG
P02A | 平底上蓋主板 | 1 | 164.00 | 164.00 | 11.50 | 大平面朝下；局部小孔與避讓槽待切片 | STL/P02A.stl | 大平面朝下列印，軸承座改由底面裝入。中央58.4孔及三個10.4定位孔與P02B配合，名義單邊0.2間隙。共用三顆M3×8及P02B螺母，外圈和底盒孔位保留。 編號P02A：上蓋內面；避開軸承座與定位孔，凹刻0.35mm。 | 組裝件 | PLA / PETG
P02B | 分離式軸承座與捕捉螺母槽 | 1 | 63.36 | 64.50 | 14.80 | 環形底面朝下；六角槽頂部局部橋接待切片 | STL/P02B.stl | 底部環形平面朝下。三處原小孔改5.8對邊六角深槽，先放M3螺母並推至上止擋；螺絲孔3.4。可暫用既有M3×25拉入螺母，再換M3×8。三個下凸緣夾在P02A底面；不在轉軸或軸承工作面刻號。 編號P02B：軸承座外側空白弧面；避開軸承孔與螺母槽，凹刻0.3mm。 | 組裝件 | PLA / PETG
P03 | 轉盤軸承壓環 | 1 | 69.00 | 70.00 | 4.00 | 大平面朝下；沉頭孔局部橋接待切片 | STL/P03.stl | 配合P02A/P02B，最大外徑70，馬達側削平避讓；內孔與三孔位置不變，大平面朝下列印。三顆M3×8同時固定壓環、主板與軸承座，分次均勻鎖緊。 編號P03：壓環上方空白環帶；避開孔與軸承接觸面，凹刻0.3mm。 | 組裝件 | PLA / PETG
P04A | 分離式旋轉承載盤 | 1 | 144.00 | 134.00 | 4.60 | 上方大平面朝下；局部孔槽待切片 | STL/P04A.stl | 與P04B配套。上方大平面貼床，底面偏心矩形榫定位防轉；四顆M3×8從上方鎖入P04B捕捉螺母。先組成轉盤，再裝P31與牌倉。 編號P04A：轉盤背面支臂；避開定位榫與固定孔，凹刻0.3mm。 | 組裝件 | PLA / PETG
P04B | 完整齒形60齒齒輪與空心轉軸 | 1 | 74.40 | 74.40 | 30.50 | Z43.5齒輪大平面朝下、空心軸朝上；6.4mm定位槽局部橋接待切片 | STL/P04B.stl | 修復承載盤螺母槽誤切齒面，B獨立建模，完整60齒貫穿7.5mm厚度。接合面Z43.5、對P02A名義間隙2mm及原M3×8沿用。本次只需重印P04B，P04A、已延長P26及其他零件沿用。齒輪大平面朝下、空心軸朝上。 PLA實心換算約24.5g（模型體積19.753cm³）；實際依切片。 | 組裝件 | PLA / PETG
P05A | 平口內腔30齒輪與止退裙邊 | 1 | 38.26 | 38.40 | 6.70 | 上方大平面朝下；沉孔與裙邊局部橋接待切片 | STL/P05A.stl | 內腔平口Y−10.7配P05B平口Y−10.5，名義側隙0.2mm。保留完整30齒、6mm齒寬與防脫裙邊。先鎖B再裝A，以兩組M3×8與M3螺母固定。既有平面版B可沿用，配合公差待試印。 | 組裝件 | PLA / PETG
P05B | 平面貼床式閉合D軸夾座 | 1 | 30.40 | 9.50 | 25.69 | 負Y側平面貼床；建議3至5mm brim，孔頂與螺母槽局部橋接待切片 | STL/P05B.stl | 背側削成約22×4.6mm平面，配兩處45度外形削角，依STL側放列印，減少法蘭懸空；仍須檢查孔頂橋接。先從正Y側放橫向M3螺母，再沿X側裝M3×8；保留完整360度沉頭座、閉合3.4mm導向孔與D軸配合面。馬達與P02A先就位，再套D軸，用符合工具圖尺寸的2mm L型扳手鎖緊，最後裝P05A。兩顆垂直固定螺母從左右側裝入，由齒輪裙邊封住入口；螺絲與螺母仍需保持咬合，夾持力與實印公差待試配。 編號P05B：背側新增貼床平面；避開D軸孔、側載槽與承壓面，凹刻0.25mm。 | 組裝件 | PLA / PETG
P06 | 捕捉螺母式空心轉軸止退環 | 1 | 36.00 | 33.00 | 7.50 | 軸承側環形平面朝下；小孔槽局部橋接待切片 | STL/P06.stl | 先由上方裝M3螺母，再從軸底端套入P04B並對齊徑向孔。M3×8穿通孔後僅輕壓滑環轉子；圓柱沉孔留微調行程，不要求螺絲頭到底。實物滑環殼體可承受壓力與抗轉能力待試裝。 編號P06：止退環隱藏小平臺；避開徑向固定孔及軸承接觸面，凹刻0.25mm。 | 組裝件 | PLA / PETG
P07 | 牌倉支柱 | 4 | 9.00 | 9.00 | 16.20 | 建議無支撐；待切片 | STL/P07.stl | 四支位於(-45/31, ±26)，使用M3沉頭長螺絲。 編號P07：支柱外側中央；避開端面與螺絲孔，凹刻0.3mm。 | 組裝件 | PLA / PETG
P08 | 61mm封底高側板開放式牌倉 | 1 | 106.00 | 83.00 | 61.85 | 底板大平面貼床；兩個底部盲避讓槽及滾輪孔局部橋接待切片 | STL/P08.stl | 連續2.4mm底板，兩側2.4mm實心擋板加高，組裝後頂緣與上蓋Z130.2齊平；前上角削邊避讓上蓋開口。內寬61mm、前後開放不限長，原23×12mm取牌輪開口及四個沉頭固定孔沿用。底面兩個Ø9.2盲槽避讓P19螺絲頭，上方仍留1.4mm實心層；先裝P19再裝牌倉。57mm牌配新版中央掛鉤P12。 編號P08：牌倉底板背面；避開牌路、盲槽與支柱，凹刻0.3mm。 PLA實心換算約53.5g；實際依切片。 | 組裝件 | PLA / PETG
P09 | 可調單張分牌閘 | 1 | 14.00 | 85.00 | 7.50 | 固定耳局部支撐 | STL/P09.stl | 起始間隙0.45mm；以實際牌厚調整。下緣貼小片橡膠分牌墊。 編號P09：分牌閘固定耳外側；不接觸牌面，凹刻0.3mm。 | 組裝件 | PLA / PETG
P10 | 選配重力壓牌滑板 | 1 | 51.00 | 55.00 | 3.00 | 建議無支撐；待切片 | STL/P10.stl | 選配；直接放在牌疊上，自由下落。底面磨平，35.5×39.5mm淺槽供P11定位。無導桿、無彈簧。 編號P10：壓牌滑板後側薄邊；避開牌面與配重槽，凹刻0.25mm。 | 壓力不足才選配 | PLA / PETG
P11 | 選配列印配重塊 | 1 | 35.00 | 39.00 | 20.00 | 建議無支撐；待切片 | STL/P11.stl | 選配；壓力不足才放在P10上。可改列印高度或填充率調重量；100%實心約33g。需實秤。 編號P11：配重塊底面中央隱藏區，凹刻0.35mm。 | 壓力不足才選配 | PLA / PETG
P12 | 57mm中央掛鉤窄牌側墊 | 2 | 82.00 | 57.67 | 5.90 | 平側面貼床；中央掛鉤需要局部支撐 | STL/P12.stl | 配新版高側板P08；57mm牌左右各一片，內寬約58mm，60mm牌取下。底邊坐在牌倉底板，中央15mm掛鉤跨過高側板，兩側相同STL，另一片以Z軸轉180度後X移-8mm。掛鉤位於上方開口內，約高出上蓋3mm；不限制前後牌長。 編號P12：中央掛鉤外側下段；位於上蓋開口下方，避開牌面與側板卡合區，凹刻0.25mm。 PLA實心換算約7.4g；實際依切片。 | 57mm牌選配 | PLA / PETG
P13 | 左出牌滾輪座 | 1 | 25.00 | 12.00 | 41.60 | 軸承孔局部支撐 | STL/P13.stl | 編號P13：滾輪座後側實心區；避開軸承孔和導槽，凹刻0.3mm。 | 組裝件 | PLA / PETG
P14 | 右出牌滾輪座 | 1 | 25.00 | 12.00 | 41.60 | 軸承孔局部支撐 | STL/P14.stl | 編號P14：滾輪座後側實心區；避開軸承孔和導槽，凹刻0.3mm。 | 組裝件 | PLA / PETG
P15 | 上滾輪調整滑塊 | 2 | 13.30 | 12.00 | 6.50 | 建議無支撐；待切片 | STL/P15.stl | 左右對稱裝入導槽，以頂部M3螺絲調整夾持間隙。 編號P15：滑塊背面；避開軸孔、軸承座和上方調整接觸點，凹刻0.3mm。 | 組裝件 | PLA / PETG
P16 | 出牌滾輪輪芯 | 2 | 18.99 | 19.00 | 54.00 | 建議無支撐；待切片 | STL/P16.stl | 兩件相同；開縫輪轂用M3×8沉頭及M3螺母夾緊，取消止付。硬輪轂外徑19mm，O圈維持原規格。 編號P16：輪芯端面空白區；避開輪槽、軸孔及摩擦圓周，凹刻0.3mm。 | 組裝件 | PLA / PETG
P17 | 取牌輪輪芯 | 1 | 18.99 | 19.00 | 10.00 | 建議無支撐；待切片 | STL/P17.stl | N20的3mm D軸；M3×8沉頭＋M3螺母夾緊，O型圈×2，取消止付。 編號P17：取牌輪端面；避開O圈槽、軸孔與接觸圓周，凹刻0.25mm。 | 組裝件 | PLA / PETG
P18 | N20取牌馬達底座 | 1 | 28.00 | 30.50 | 13.60 | 建議無支撐；待切片 | STL/P18.stl | 編號P18：馬達座底面空白區，凹刻0.3mm。 | 組裝件 | PLA / PETG
P19 | N20馬達壓片 | 1 | 25.20 | 8.40 | 3.20 | 建議無支撐；待切片 | STL/P19.stl | 編號P19：壓片上面中央；位於牌倉下方，凹刻0.25mm。 | 組裝件 | PLA / PETG
P20 | RF300出牌馬達底座 | 1 | 36.00 | 27.00 | 19.80 | 建議無支撐；待切片 | STL/P20.stl | RF300約24.4mm、長軸約18mm。兩顆M3×25同時固定壓片、馬達座及P31，取消另外兩顆底座螺絲。 編號P20：底座下方側翼；避開馬達弧座及螺絲孔，凹刻0.25mm。 | 組裝件 | PLA / PETG
P21 | RF300馬達壓片 | 1 | 35.00 | 8.00 | 3.00 | 建議無支撐；待切片 | STL/P21.stl | 編號P21：壓片上方中央；避開馬達弧面，凹刻0.25mm。 | 組裝件 | PLA / PETG
P22 | 2mm至3mm軸聯軸器 | 1 | 19.00 | 19.00 | 18.00 | 建議無支撐；待切片 | STL/P22.stl | 兩端獨立開縫，各M3×8沉頭＋M3螺母夾緊；取消止付。外徑19，需用新版P31避讓。 編號P22：聯軸器端面環帶；避開軸孔及止付孔，凹刻0.25mm。 | 組裝件 | PLA / PETG
P23 | 出牌導向槽 | 1 | 33.50 | 80.00 | 12.90 | 需要局部支撐 | STL/P23.stl | 兩側M3水平鎖入滾輪座，出口留光電避讓缺口。滾輪接觸面以O型圈為準。 編號P23：出牌導槽下方前緣；不在牌路表面，凹刻0.25mm。 | 組裝件 | PLA / PETG
P24 | 出口光電感測器可調座 | 1 | 21.50 | 16.50 | 18.40 | 建議無支撐；待切片 | STL/P24.stl | 按13×6.8×6mm、5mm槽寬ITR9608-F包絡；57mm牌時連同感測器向內移1.5mm，8mm長孔調整。 編號P24：出口座背板外側；避開接腳與束帶孔，凹刻0.25mm。 | 組裝件 | PLA / PETG
P25 | 旋轉參考光電座 | 1 | 22.50 | 13.00 | 13.00 | 建議無支撐；待切片 | STL/P25.stl | 用於每圈參考標記。螺絲長孔可校正位置。 編號P25：參考感測座底面；避開固定孔與接腳孔，凹刻0.25mm。 | 組裝件 | PLA / PETG
P26 | 延長式轉盤光電遮光片 | 1 | 25.00 | 10.00 | 7.90 | 建議無支撐；待切片 | STL/P26.stl | 配P04B抬升1.5mm，遮光薄片向下延長1.5mm；組裝後下緣仍為Z35.6，原感測器光路與槽底0.3mm名義間隙保留。安裝孔及支臂沿用，依STL平面貼床。 PLA實心換算約0.4g；實際依切片。 | 組裝件 | PLA / PETG
P27 | 頂按式按鍵帽 | 4 | 9.00 | 9.00 | 6.35 | 建議無支撐；待切片 | STL/P27.stl | 自上方按壓；6×6×9.5mm輕觸鍵。帽底至屋頂0.6mm，檢查0至0.35mm行程。 編號27：頂按鍵帽凸緣背面環帶；按壓面無編號，凹刻0.22mm。 | 組裝件 | PLA / PETG
P28 | 頂部OLED固定框 | 1 | 44.00 | 32.00 | 3.50 | 建議無支撐；待切片 | STL/P28.stl | 27.3×27.8mm板件基準；兩顆M3×8沉頭由下方固定，加厚耳座避免螺絲頂穿外罩。 編號P28：頂部螢幕框底面前側橫條，凹刻0.25mm。 | 組裝件 | PLA / PETG
P29 | 18650電池盒束帶壓扣 | 2 | 6.00 | 31.00 | 8.60 | 建議無支撐；待切片 | STL/P29.stl | 弧形避讓電芯，側翼壓在電池盒邊緣；束帶穿內部橋座固定，不壓電芯凸起處。 編號P29：束帶壓扣支腳外側；避開電芯避讓弧面，凹刻0.25mm。 | 組裝件 | PLA / PETG
P30 | 孔徑試配片 | 1 | 58.00 | 23.00 | 6.90 | 建議無支撐；待切片 | STL/P30.stl | 3.0／3.2／3.4／5.0／5.2mm，先調整擠出量及孔補償。此件不裝入成品。 編號P30：試配片孔列旁的工具標示區，凹刻0.3mm。 | 先印試配 | PLA / PETG
P31 | 6度下傾轉接框 | 1 | 132.90 | 140.40 | 15.43 | 建議無支撐；待切片 | STL/P31.stl | 平底鎖在旋轉盤，上斜面承接整組牌路；下傾6度、抬高10mm以避讓馬達。支撐建議待切片核對。 編號P31：轉接框內側直立肋面；避開安裝斜面，凹刻0.3mm。 | 組裝件 | PLA / PETG
P32A | 台階包覆式居中上殼主片 | 1 | 174.00 | 159.20 | 85.70 | 原屋頂大平面貼床；1.2mm外蓋邊隨屋頂起印，孔槽局部橋接待切片 | STL/P32A.stl | A外側1.2mm包覆邊向B延伸6.1mm，形成明顯台階；與B名義間隙0.3mm。屋頂大平面貼床。先與B在機外用原四組M3×8及螺母從內側連接，其他零件與孔位不變。 PLA實心換算約173.0g；實際依切片。 | 組裝件 | PLA / PETG
P32B | 退台式上殼背側接合片 | 1 | 171.00 | 50.50 | 84.20 | 退台後127.2mm屋頂大平面貼床；封閉沉頭孔與接合凸臺局部橋接待切片 | STL/P32B.stl | B屋頂與側牆內退1.5mm，屋頂厚2.2mm，配A包覆邊留0.3mm名義間隙；屋頂大平面貼床。與A仍用原四組M3×8及螺母，局部橋接與配合公差待切片試印。 PLA實心換算約59.2g；實際依切片。 | 組裝件 | PLA / PETG
P33 | 上罩側維修蓋 | 1 | 114.00 | 83.50 | 2.20 | 建議無支撐；待切片 | STL/P33.stl | 四顆M3×8沉頭螺絲固定；下緣43mm。可拆後調整馬達、分牌閘及清除卡牌。 編號P33：側維修蓋內面；外觀面無字，凹刻0.35mm。 | 組裝件 | PLA / PETG
P34 | 出牌口下飾蓋 | 1 | 16.50 | 98.00 | 2.20 | 建議無支撐；待切片 | STL/P34.stl | 兩顆M3×8沉頭螺絲固定；安裝後保留約74×15mm出牌口。內面刻號，正面保持平整。 編號P34：出牌口下飾蓋內面；外觀面無字，凹刻0.35mm。 | 組裝件 | PLA / PETG
P35 | 頂部按鍵與PCF支架 | 1 | 33.00 | 55.00 | 24.40 | 建議無支撐；待切片 | STL/P35.stl | 14×51mm按鍵板；四顆M3×8沉頭由內側鎖上罩，PCF板焊線低矮裝配。 編號P35：按鍵支架後側直立框；避開電路板及束帶孔，凹刻0.3mm。 | 組裝件 | PLA / PETG
P36 | 滑環法蘭壓片 | 3 | 14.60 | 8.00 | 6.40 | 建議無支撐；待切片 | STL/P36.stl | M3×8由底座底部凹孔往上鎖入壓片M3螺母。三片相同轉120°。定位小柱適用參考孔圓Ø38；法蘭不同可移位或剪除小柱後暫時定位。 編號P36：滑環壓片內端上面；避開螺母槽、定位柱與法蘭接觸面，凹刻0.25mm。 | 組裝件 | PLA / PETG

Sheet: 螺絲規格
整機螺絲：僅兩種規格
DIN7991 M3×0.5；90°沉頭，頭徑≤6.0、頭高≤1.7；同用2mm內六角。長度包含頭部。
規格 | 模型需用量 | 建議備料 | 頭型／材質 | 主要用途 | 淘寶搜尋詞 | 備註
M3×8 | 61 | 70 | 內六角沉頭；鋼或不鏽鋼 | 外殼、支架、輪轂夾緊等 | DIN7991 M3x8 沉头 内六角 | 同一頭型，勿換盤頭或頭徑較大版本
M3×25 | 10 | 12 | 內六角沉頭；鋼或不鏽鋼 | 底盒、牌倉、RF300共用固定 | DIN7991 M3x25 沉头 内六角 全牙 | 數量已包含RF300壓片與底座共用螺絲
M3螺母 | 52 | 60 | 標準M3；對邊5.5、厚2.4 | 所有螺母位置 | M3 六角螺母 厚2.4 | 螺母僅一規格；不使用加厚或防鬆帽型
建議備料含少量備品；Excel主表C07仍以整組6元作目標配置，實付依所選包裝填入。
固定順序為P02A/馬達、P05B、P05A；B橫向用一組M3×8與螺母，A/B連接另用兩組。
P06螺絲穿P04B孔，接觸滑環後輕調，不強鎖到底；RF300仍共用兩顆長螺絲。
P05A未裝時，以常見2mm L型工具鎖緊B，尺寸依新工具圖核對；完整座面與閉孔限制歪斜，夾力仍待實測。
P32A／P32B新增四組M3×8與M3螺母，從上殼內側連接；兩片先組合再裝頂部UI與罩入機構。
逐位置模型數量：設計包內3D/五金數量表.csv。模型用量與建議備料數量分列。
