shihkefa/esp32c3-card-dealer/V1.0.0/verification/shell-bom-preview.png

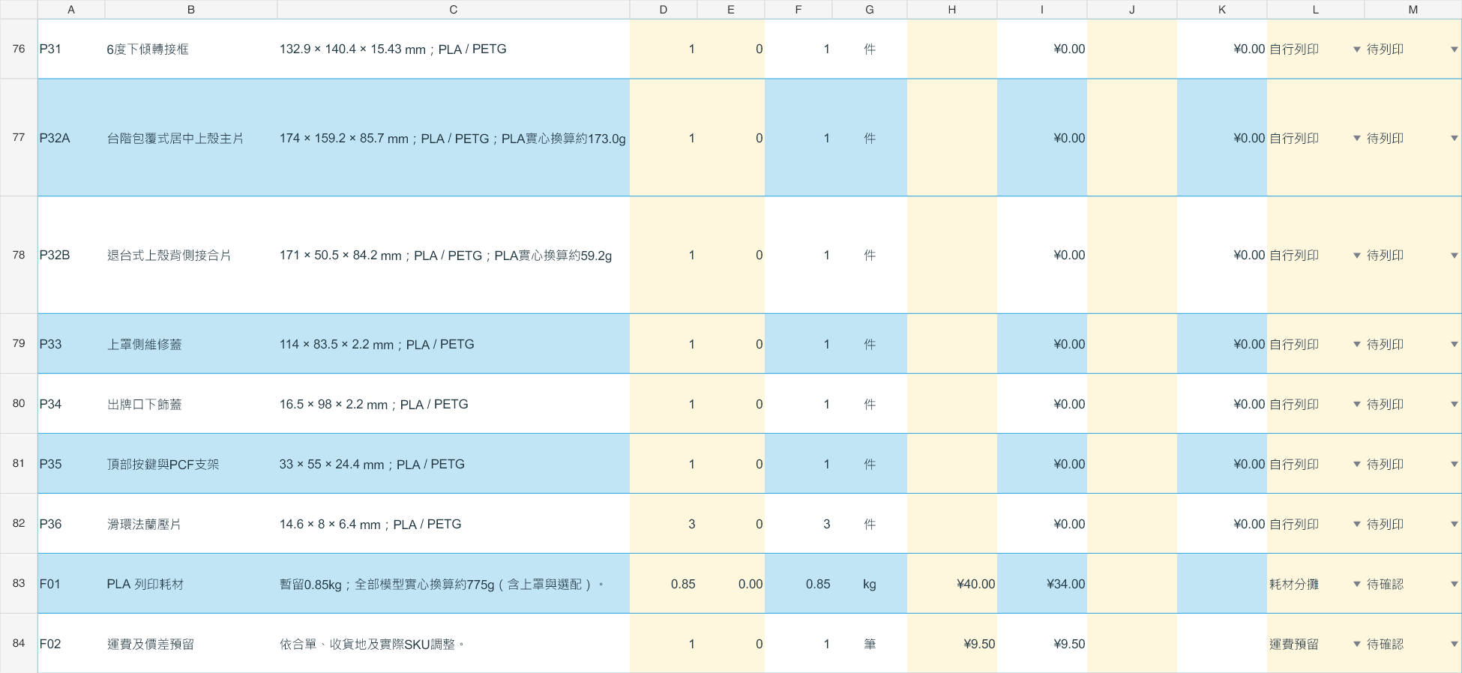
V1.0.0/verification/shell-bom-preview.png
