shihkefa/esp32c3-card-dealer/V1.0.0/verification/tooth-P04B-bom-preview.png

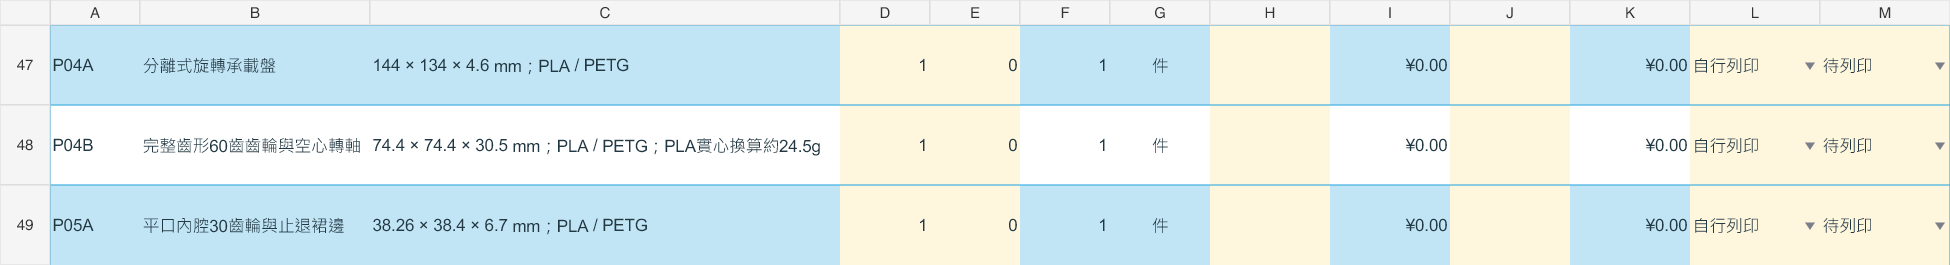
V1.0.0/verification/tooth-P04B-bom-preview.png
