shihkefa/esp32c3-card-dealer/V1.0.0/3d/STL/P12.stl

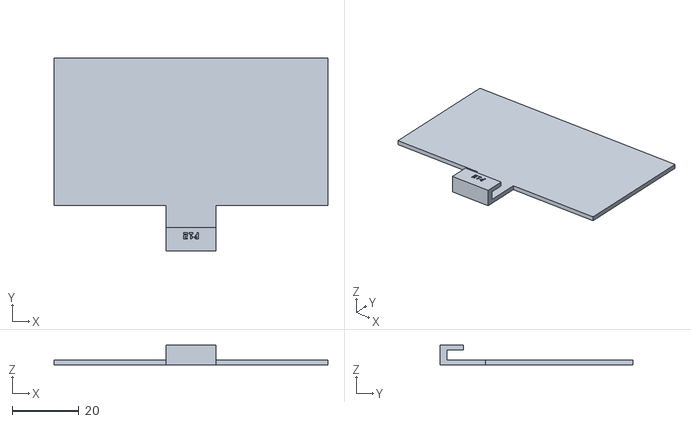
[picture p46: CAD file, 2026-11-11]
V1.0.0/3d/STL/P12.stl
82.0 x 57.7 x 5.90
