shihkefa/esp32c3-card-dealer/V1.0.0/發牌機_整機組裝_V1.0.0.stl

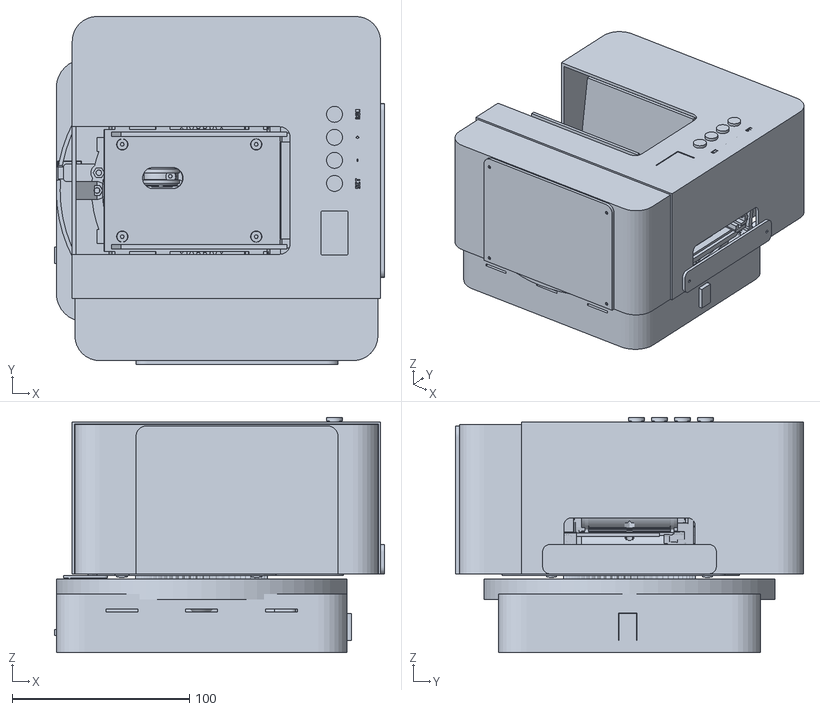
[picture p47: CAD file, 2026-11-11]
V1.0.0/發牌機_整機組裝_V1.0.0.stl
186.2 x 196.4 x 132.8
