shihkefa/esp32c3-card-dealer/V1.0.0/3d/STL/P08.stl

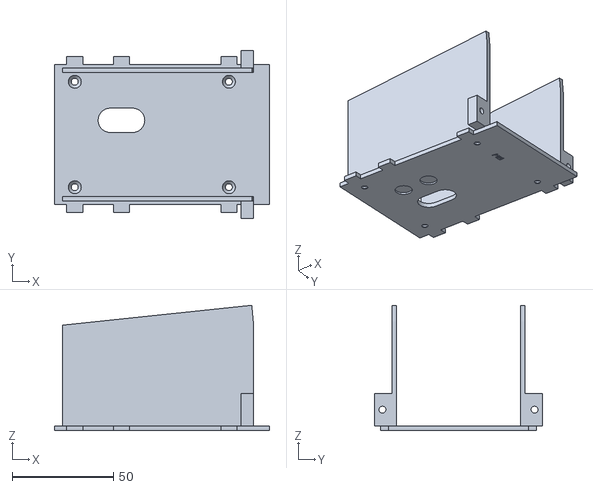
[picture p48: CAD file, 2026-11-11]
V1.0.0/3d/STL/P08.stl
106.0 x 83.0 x 61.8
