shihkefa/esp32c3-card-dealer/V1.0.0/3d/STL/P04B.stl

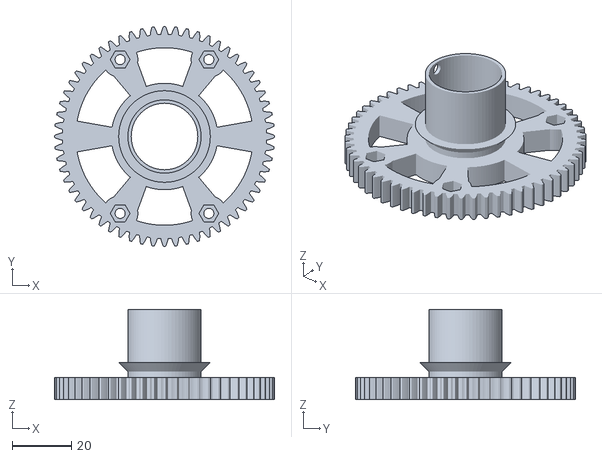
[picture p49: CAD file, 2026-11-11]
V1.0.0/3d/STL/P04B.stl
74.4 x 74.4 x 30.5
