shihkefa/esp32c3-card-dealer/V1.0.0/3d/STL/P06.stl

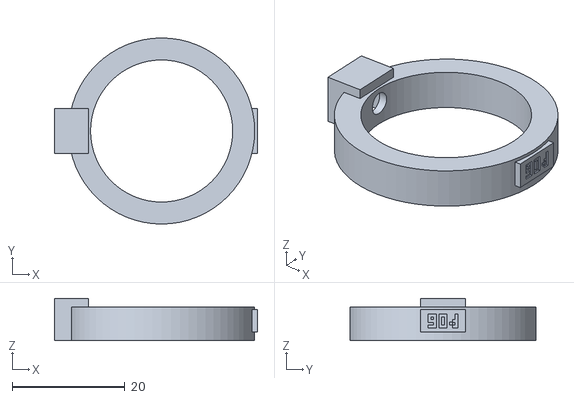
[picture p50: CAD file, 2026-11-11]
V1.0.0/3d/STL/P06.stl
36.0 x 33.0 x 7.50
