shihkefa/esp32c3-card-dealer/V1.0.0/3d/STL/P29.stl

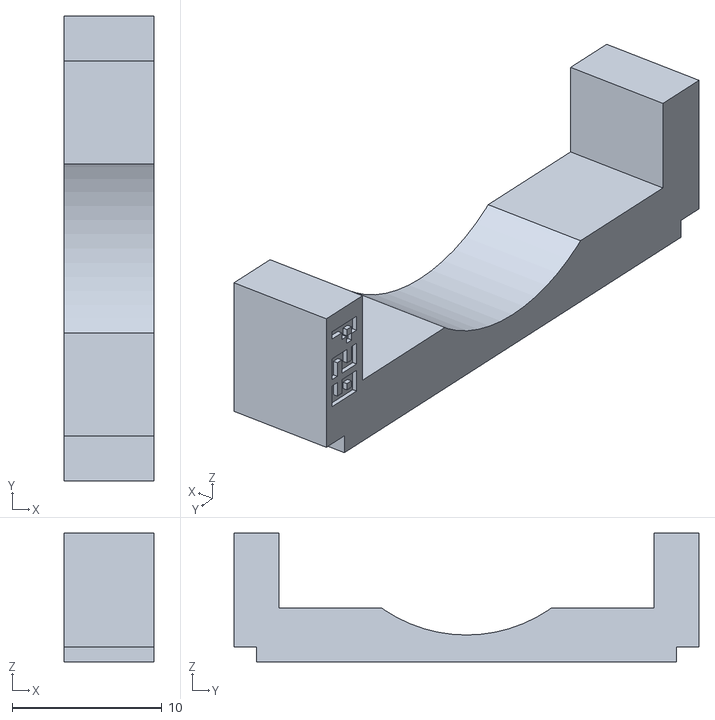
[picture p51: CAD file, 2026-11-11]
V1.0.0/3d/STL/P29.stl
6.00 x 31.0 x 8.60
