shihkefa/esp32c3-card-dealer/V1.0.0/3d/STL/P05B.stl

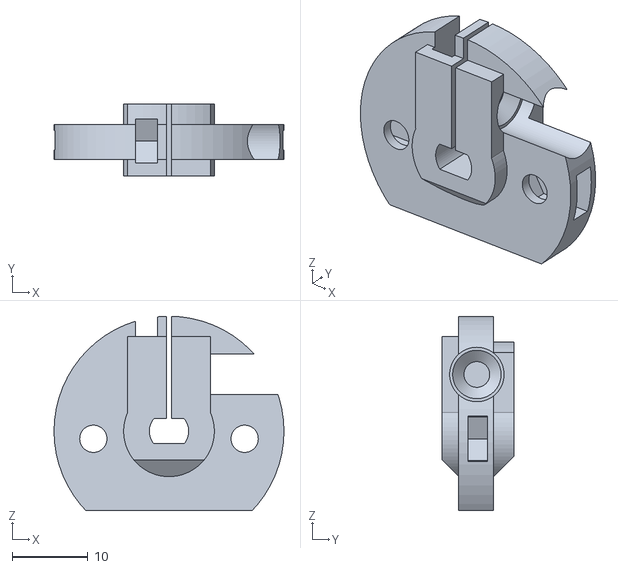
[picture p52: CAD file, 2026-11-11]
V1.0.0/3d/STL/P05B.stl
30.4 x 9.50 x 25.7
