shihkefa/esp32c3-card-dealer/V1.0.0/3d/STL/P07.stl

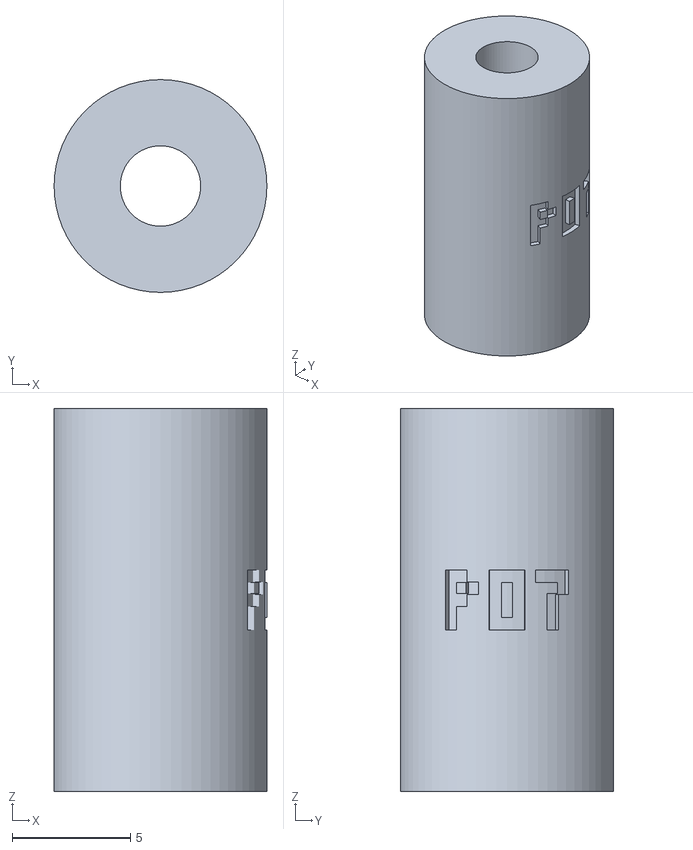
[picture p53: CAD file, 2026-11-11]
V1.0.0/3d/STL/P07.stl
9.00 x 9.00 x 16.2
