shihkefa/esp32c3-card-dealer/V1.0.0/3d/STL/P31.stl

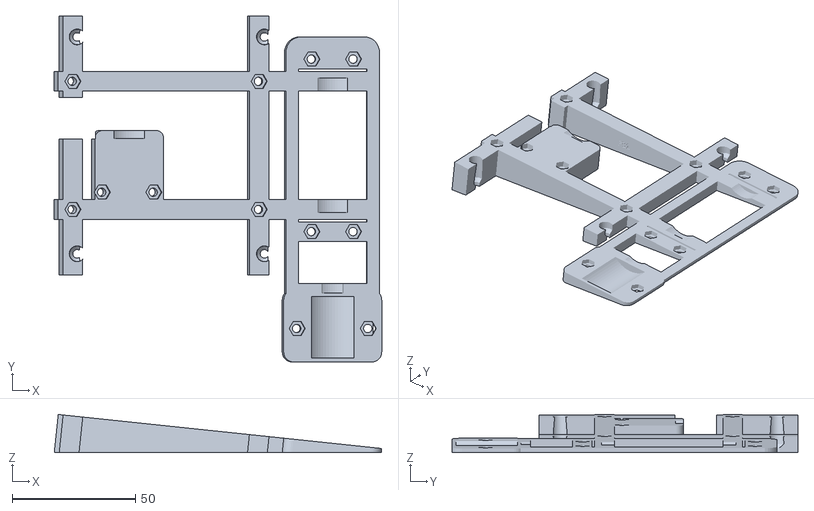
[picture p54: CAD file, 2026-11-11]
V1.0.0/3d/STL/P31.stl
132.9 x 140.4 x 15.4
