shihkefa/esp32c3-card-dealer/V1.0.0/3d/STL/P11.stl

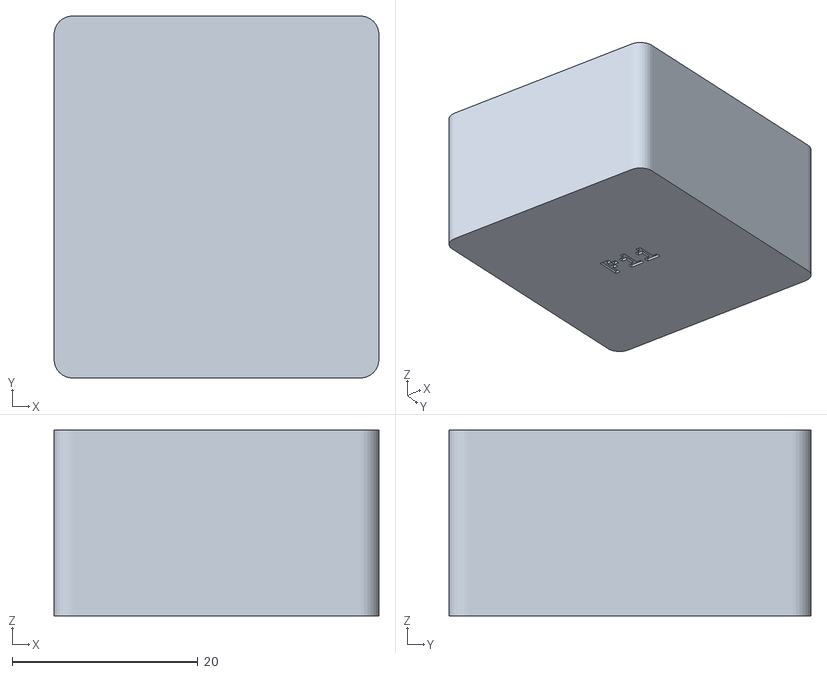
[picture p55: CAD file, 2026-11-11]
V1.0.0/3d/STL/P11.stl
35.0 x 39.0 x 20.0
