shihkefa/esp32c3-card-dealer/V1.0.0/3d/STL/P24.stl

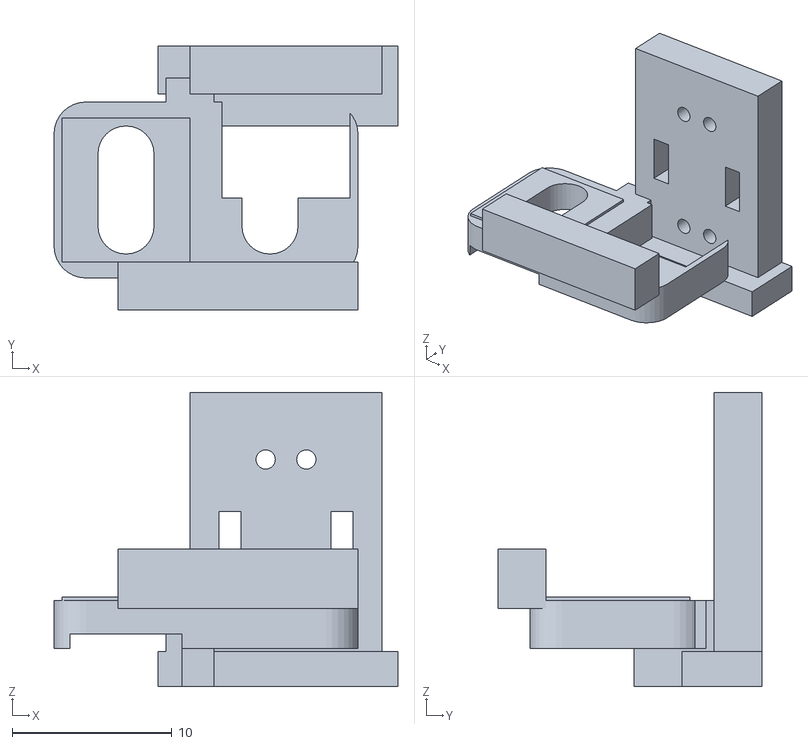
[picture p56: CAD file, 2026-11-11]
V1.0.0/3d/STL/P24.stl
21.5 x 16.5 x 18.4
