shihkefa/esp32c3-card-dealer/V1.0.0/3d/STL/P28.stl

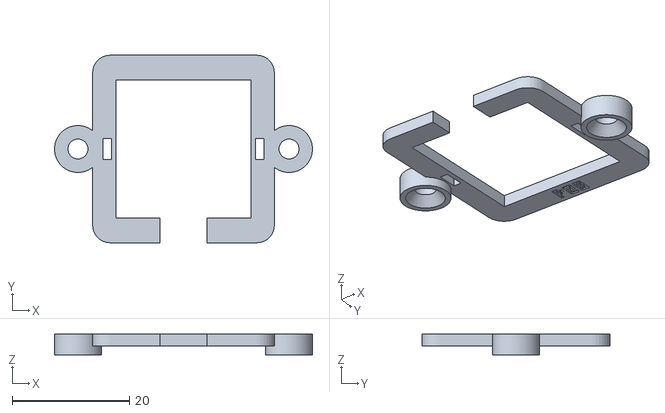
[picture p57: CAD file, 2026-11-11]
V1.0.0/3d/STL/P28.stl
44.0 x 32.0 x 3.50
