shihkefa/esp32c3-card-dealer/V1.0.0/3d/STL/P36.stl

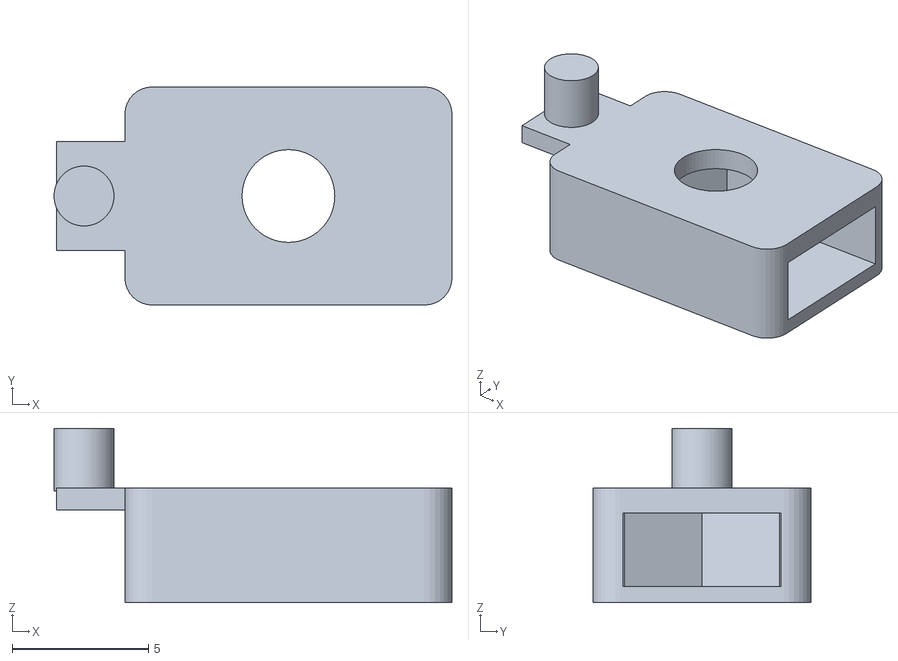
[picture p58: CAD file, 2026-11-11]
V1.0.0/3d/STL/P36.stl
14.6 x 8.00 x 6.40
