shihkefa/esp32c3-card-dealer/V1.0.0/3d/STL/P09.stl

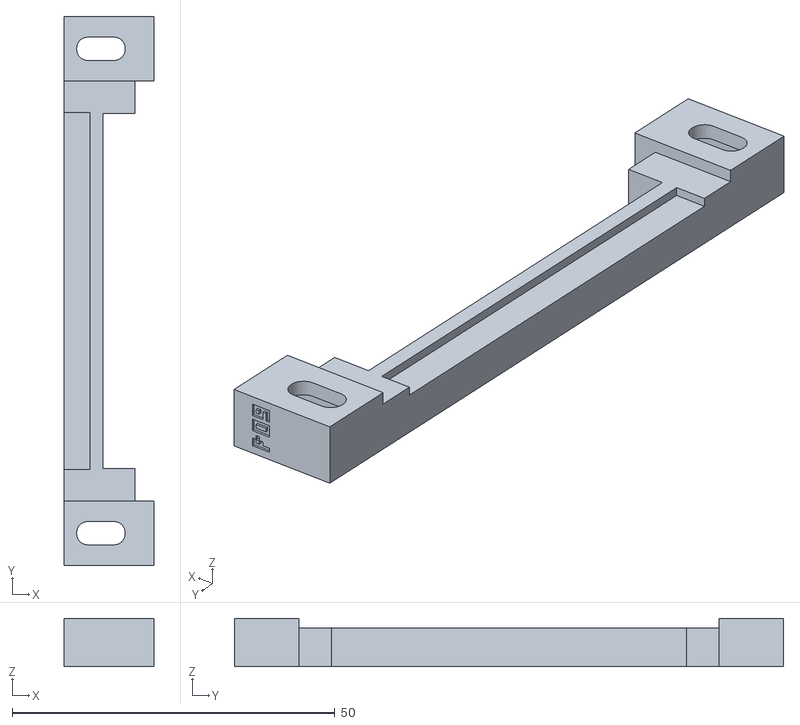
[picture p59: CAD file, 2026-11-11]
V1.0.0/3d/STL/P09.stl
14.0 x 85.0 x 7.50
