shihkefa/esp32c3-card-dealer/V1.0.0/3d/STL/P25.stl

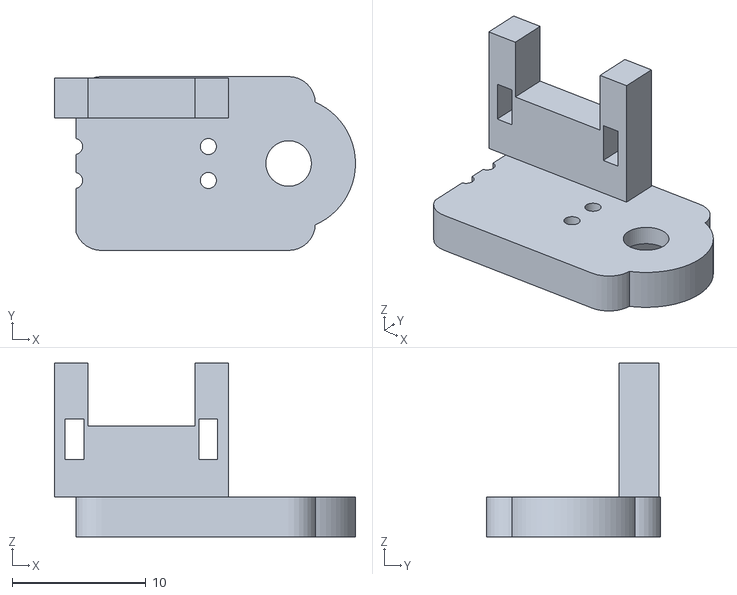
[picture p60: CAD file, 2026-11-11]
V1.0.0/3d/STL/P25.stl
22.5 x 13.0 x 13.0
