shihkefa/esp32c3-card-dealer/V1.0.0/3d/STL/P26.stl

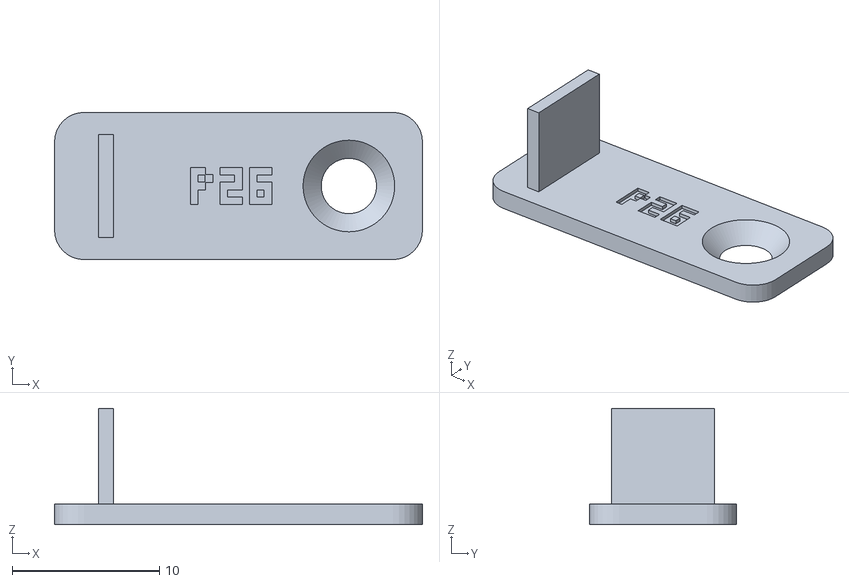
[picture p61: CAD file, 2026-11-11]
V1.0.0/3d/STL/P26.stl
25.0 x 10.0 x 7.90
