shihkefa/esp32c3-card-dealer/V1.0.0/3d/STL/P14.stl

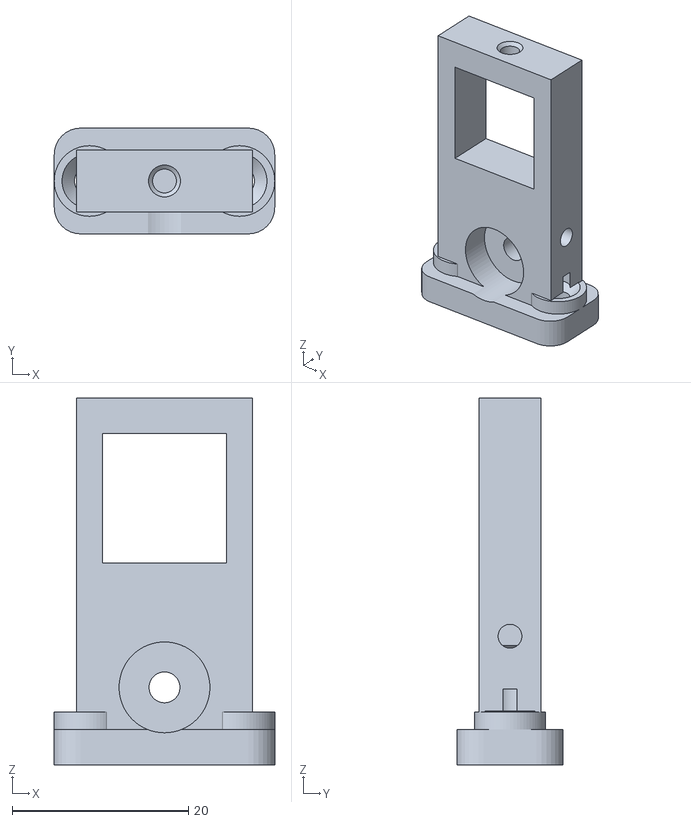
[picture p62: CAD file, 2026-11-11]
V1.0.0/3d/STL/P14.stl
25.0 x 12.0 x 41.6
