shihkefa/esp32c3-card-dealer/V1.0.0/3d/STL/P22.stl

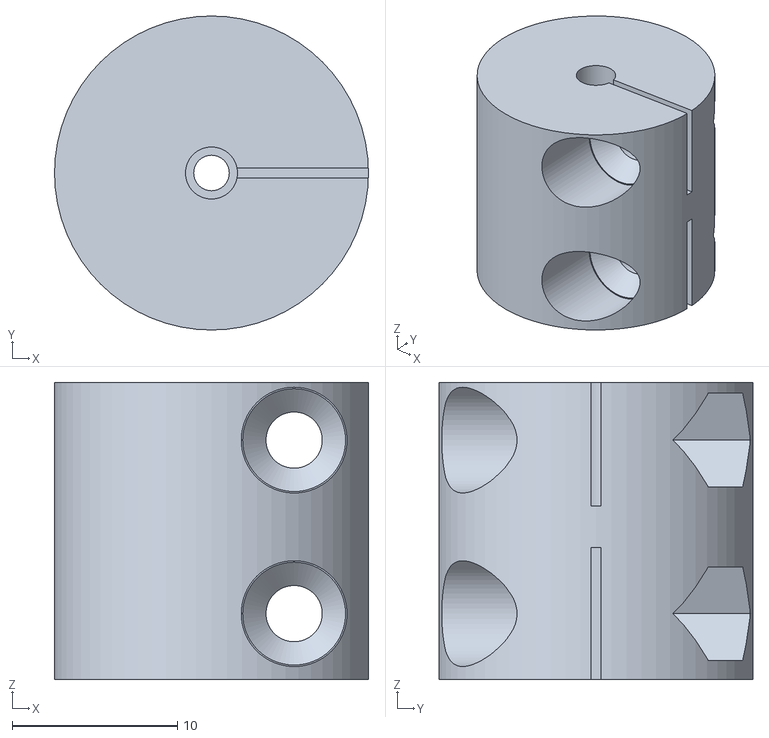
[picture p63: CAD file, 2026-11-11]
V1.0.0/3d/STL/P22.stl
19.0 x 19.0 x 18.0
