shihkefa/esp32c3-card-dealer/V1.0.0/3d/STL/P32B.stl

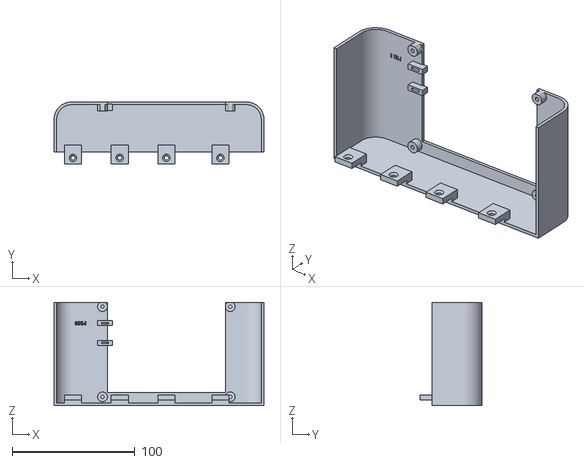
[picture p64: CAD file, 2026-11-11]
V1.0.0/3d/STL/P32B.stl
171.0 x 50.5 x 84.2
