shihkefa/esp32c3-card-dealer/V1.0.0/3d/STL/P20.stl

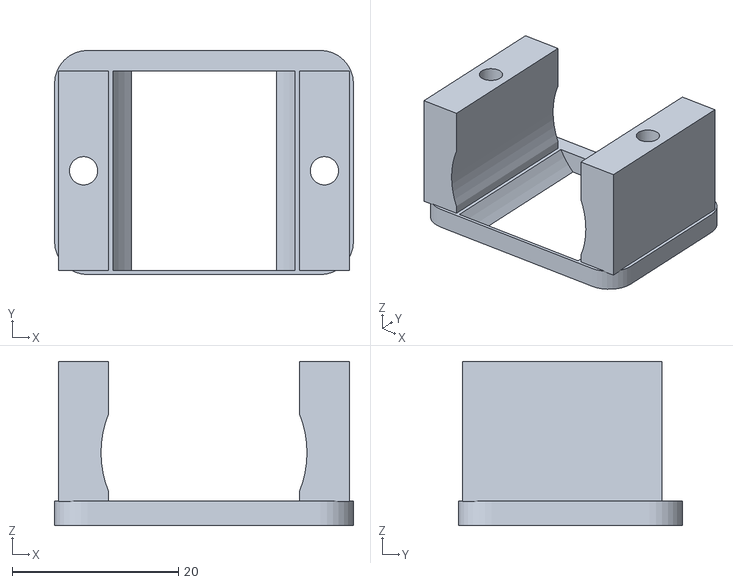
[picture p65: CAD file, 2026-11-11]
V1.0.0/3d/STL/P20.stl
36.0 x 27.0 x 19.8
