shihkefa/esp32c3-card-dealer/V1.0.0/3d/STL/P15.stl

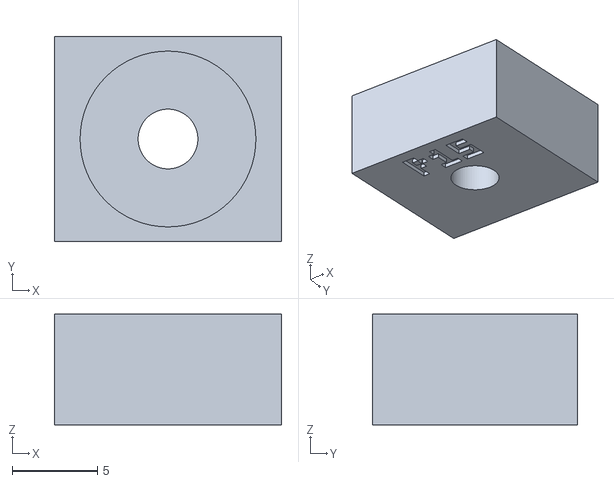
[picture p66: CAD file, 2026-11-11]
V1.0.0/3d/STL/P15.stl
13.3 x 12.0 x 6.50
