shihkefa/esp32c3-card-dealer/V1.0.0/3d/STL/P01.stl

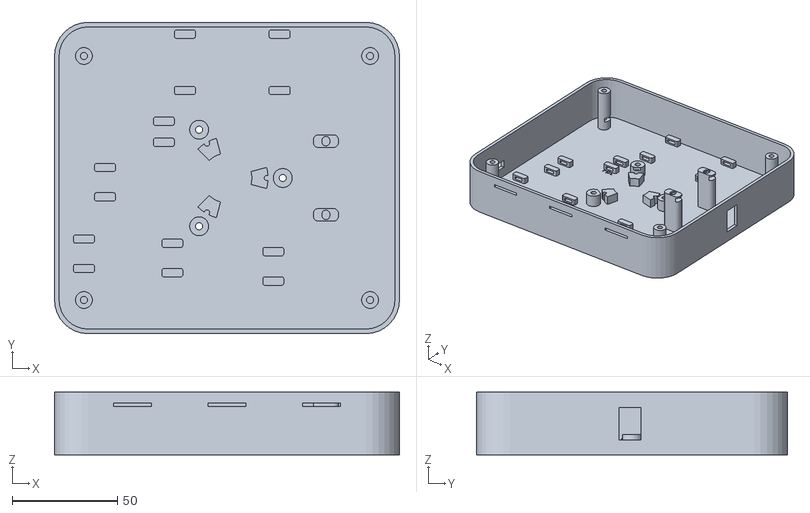
[picture p67: CAD file, 2026-11-11]
V1.0.0/3d/STL/P01.stl
164.0 x 148.0 x 29.9
