shihkefa/esp32c3-card-dealer/V1.0.0/3d/STL/P19.stl

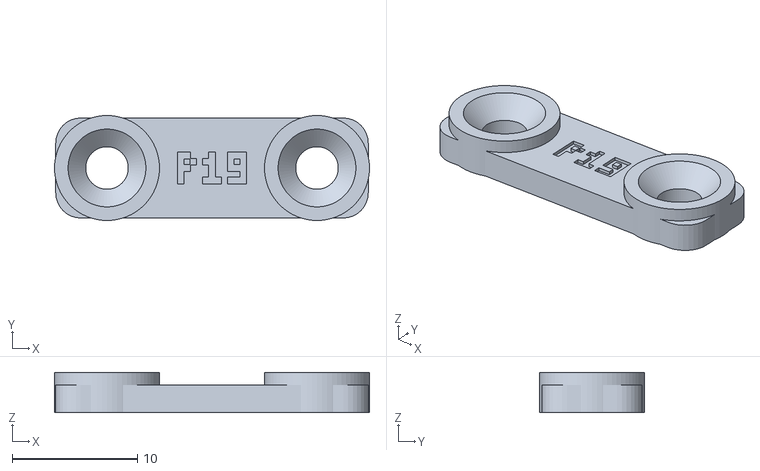
[picture p68: CAD file, 2026-11-11]
V1.0.0/3d/STL/P19.stl
25.2 x 8.40 x 3.20
