shihkefa/esp32c3-card-dealer/V1.0.0/3d/STL/P34.stl

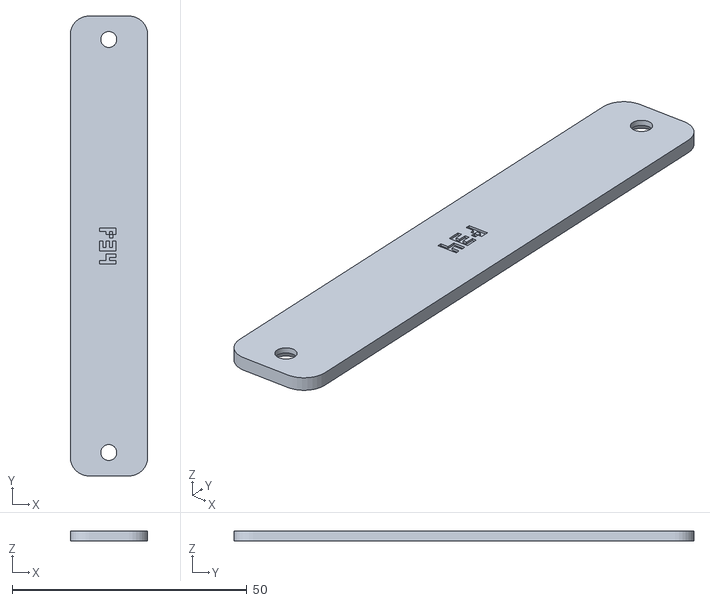
[picture p69: CAD file, 2026-11-11]
V1.0.0/3d/STL/P34.stl
16.5 x 98.0 x 2.20
