shihkefa/esp32c3-card-dealer/V1.0.0/3d/STL/P03.stl

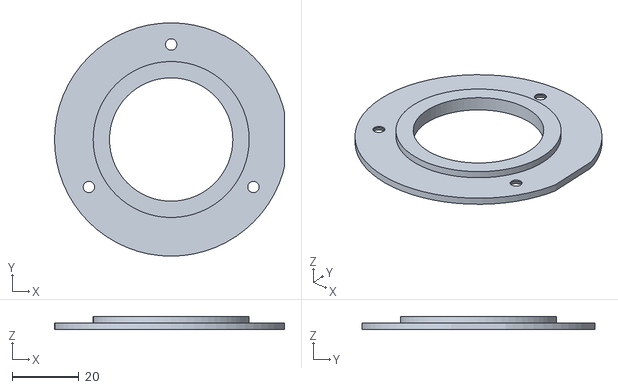
[picture p70: CAD file, 2026-11-11]
V1.0.0/3d/STL/P03.stl
69.0 x 70.0 x 4.00
