shihkefa/esp32c3-card-dealer/V1.0.0/3d/STL/P05A.stl

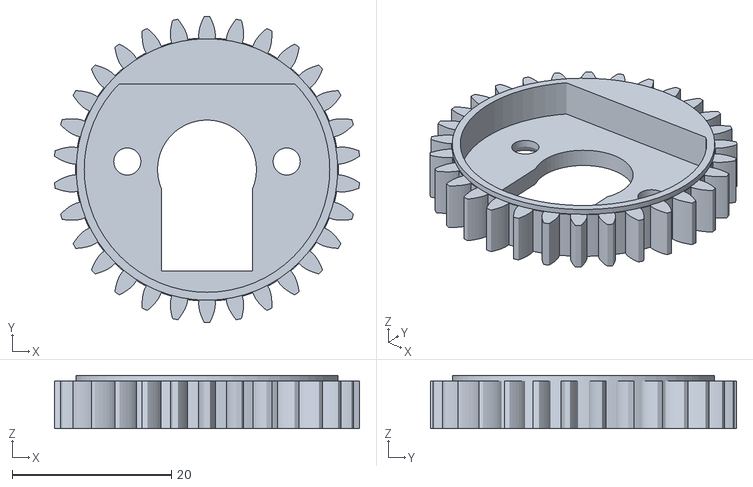
[picture p71: CAD file, 2026-11-11]
V1.0.0/3d/STL/P05A.stl
38.3 x 38.4 x 6.70
