shihkefa/esp32c3-card-dealer/V1.0.0/3d/STL/P21.stl

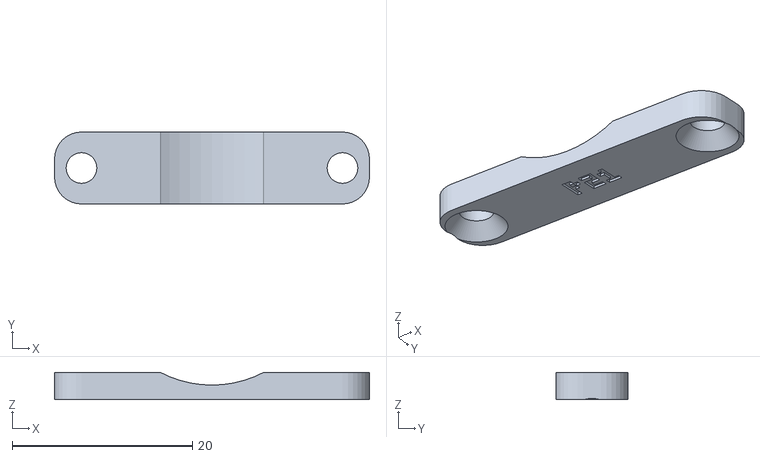
[picture p72: CAD file, 2026-11-11]
V1.0.0/3d/STL/P21.stl
35.0 x 8.00 x 3.00
