shihkefa/esp32c3-card-dealer/V1.0.0/3d/STL/P04A.stl

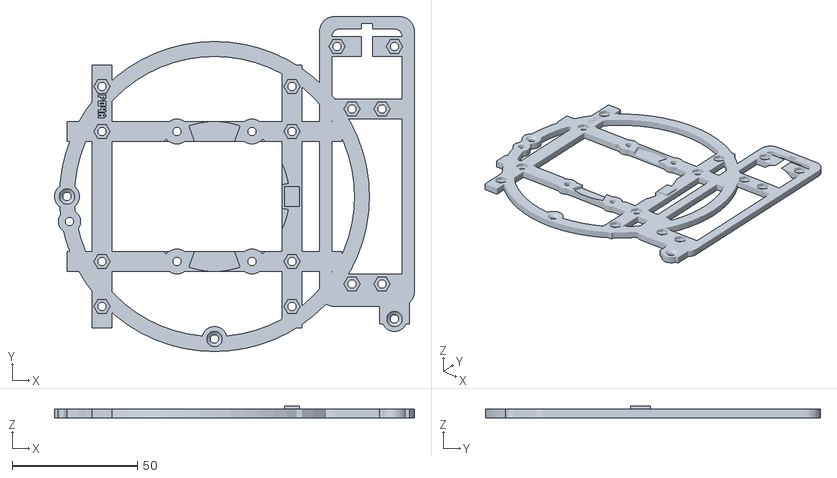
[picture p73: CAD file, 2026-11-11]
V1.0.0/3d/STL/P04A.stl
144.0 x 134.0 x 4.60
