shihkefa/esp32c3-card-dealer/V1.0.0/3d/STL/P23.stl

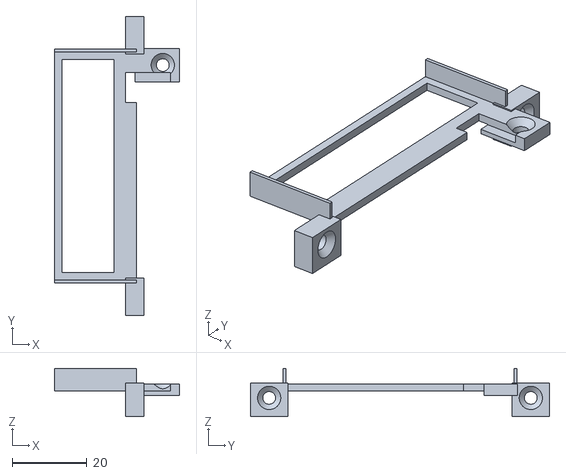
[picture p74: CAD file, 2026-11-11]
V1.0.0/3d/STL/P23.stl
33.5 x 80.0 x 12.9
