shihkefa/esp32c3-card-dealer/V1.0.0/3d/STL/P18.stl

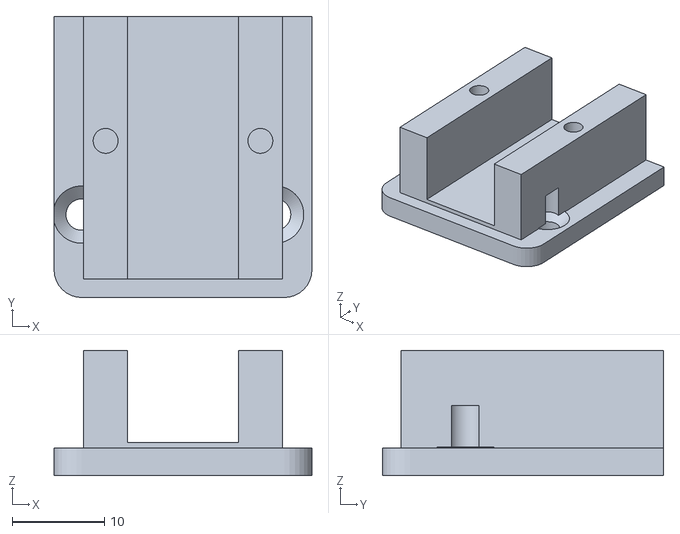
[picture p75: CAD file, 2026-11-11]
V1.0.0/3d/STL/P18.stl
28.0 x 30.5 x 13.6
