shihkefa/esp32c3-card-dealer/V1.0.0/3d/STL/P30.stl

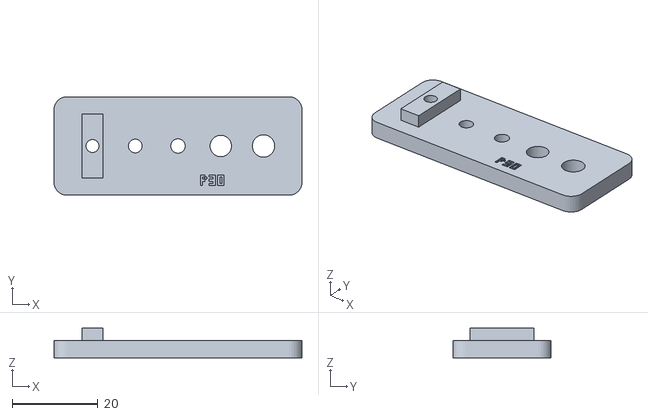
[picture p76: CAD file, 2026-11-11]
V1.0.0/3d/STL/P30.stl
58.0 x 23.0 x 6.90
