shihkefa/esp32c3-card-dealer/V1.0.0/3d/STL/P33.stl

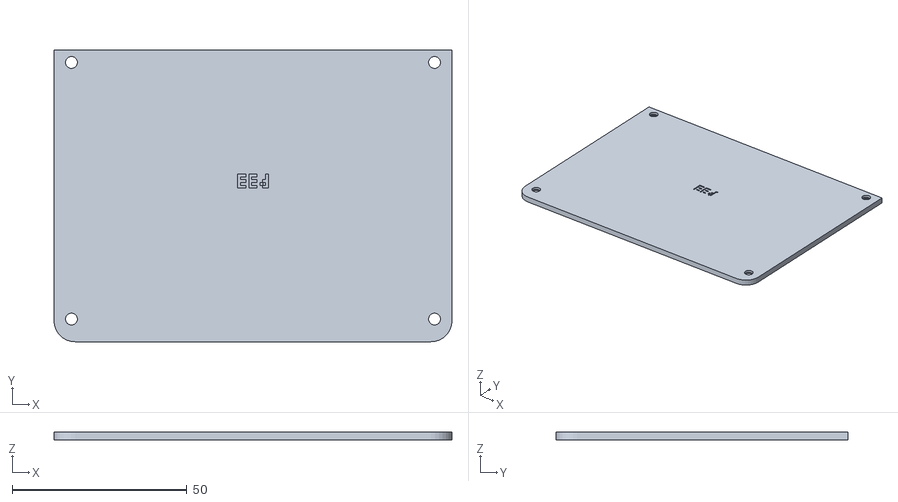
[picture p78: CAD file, 2026-11-11]
V1.0.0/3d/STL/P33.stl
114.0 x 83.5 x 2.20
