shihkefa/esp32c3-card-dealer/V1.0.0/3d/STL/P10.stl

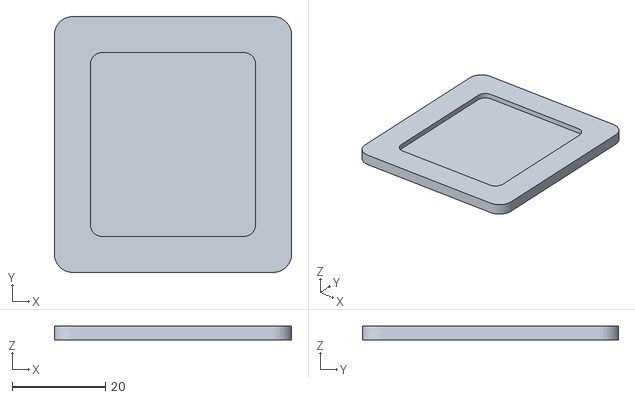
[picture p79: CAD file, 2026-11-11]
V1.0.0/3d/STL/P10.stl
51.0 x 55.0 x 3.00
