shihkefa/esp32c3-card-dealer/V1.0.0/3d/STL/P02B.stl

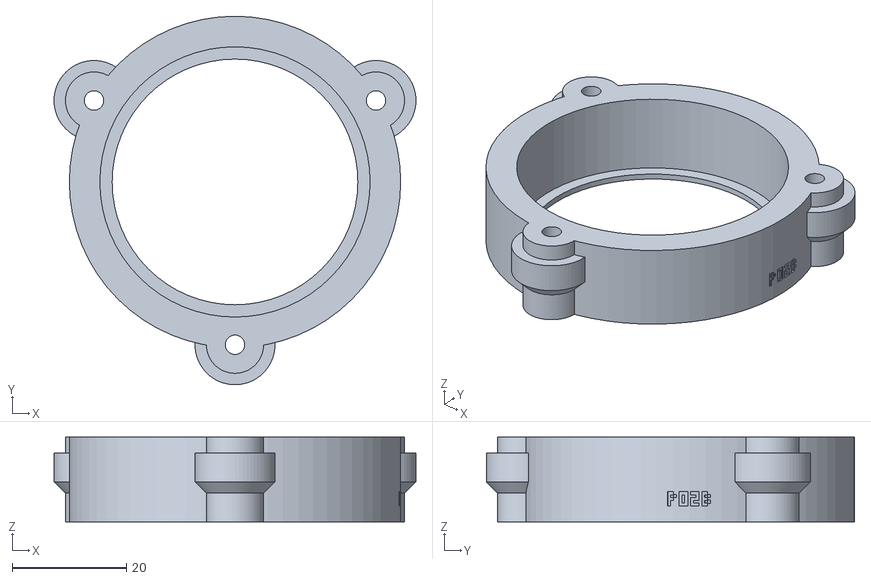
[picture p80: CAD file, 2026-11-11]
V1.0.0/3d/STL/P02B.stl
63.4 x 64.5 x 14.8
