shihkefa/esp32c3-card-dealer/V1.0.0/3d/STL/P17.stl

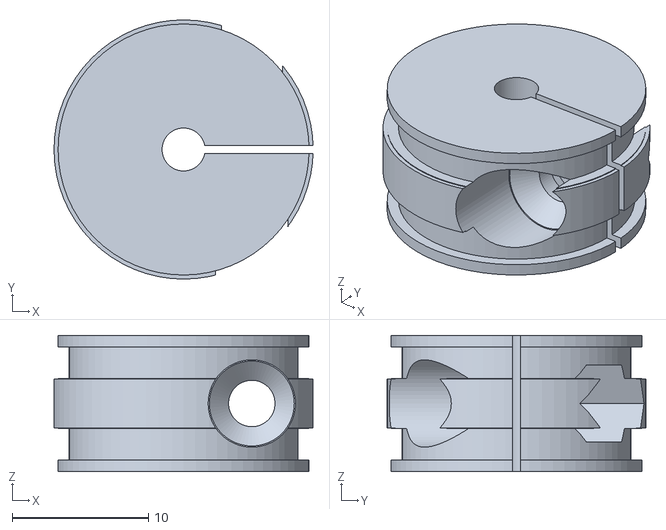
[picture p81: CAD file, 2026-11-11]
V1.0.0/3d/STL/P17.stl
19.0 x 19.0 x 10.0
