shihkefa/esp32c3-card-dealer/V1.0.0/3d/STL/P32A.stl

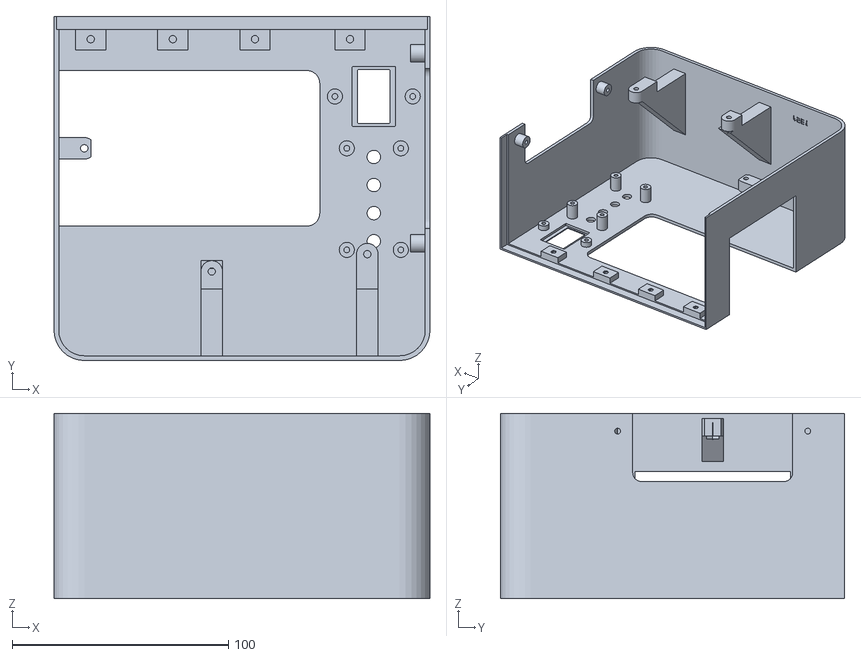
[picture p83: CAD file, 2026-11-11]
V1.0.0/3d/STL/P32A.stl
174.0 x 159.2 x 85.7
