shihkefa/esp32c3-card-dealer/V1.0.0/3d/STL/P35.stl

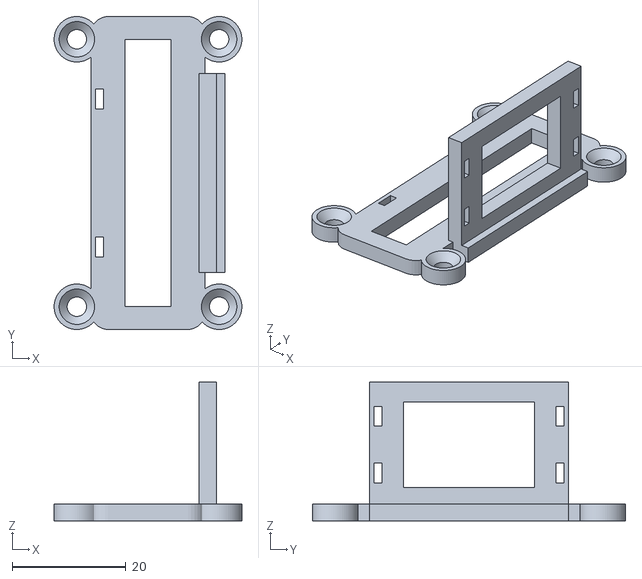
[picture p84: CAD file, 2026-11-11]
V1.0.0/3d/STL/P35.stl
33.0 x 55.0 x 24.4
