shihkefa/esp32c3-card-dealer/V1.0.0/3d/STL/P02A.stl

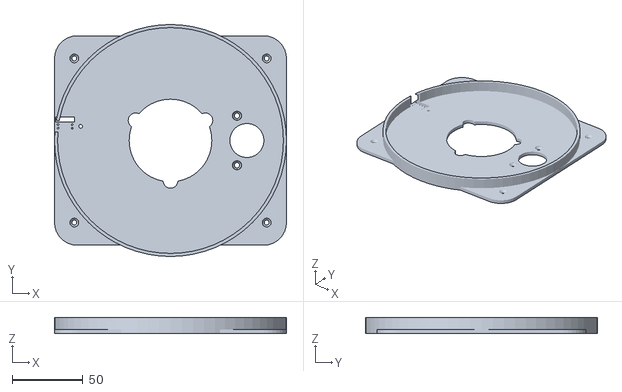
[picture p85: CAD file, 2026-11-11]
V1.0.0/3d/STL/P02A.stl
164.0 x 164.0 x 11.5
