shihkefa/esp32c3-card-dealer/V1.0.0/3d/OpenSCAD/P03.scad

// 轉盤軸承壓環
$fn=64;
translate([35,35,35]){rotate([180,0,0]){difference(){difference(){difference(){difference(){difference(){difference(){difference(){difference(){difference(){union(){translate([0,0,33]){cylinder(h=2,d1=70,d2=70,$fn=64);}translate([0,0,31]){cylinder(h=2.2,d1=46.8,d2=46.8,$fn=64);}}translate([0,0,30]){cylinder(h=7,d1=37,d2=37,$fn=64);}}translate([34,-50,29]){cube([10,100,10]);}}translate([24.68172,14.25,30]){cylinder(h=7,d1=3.4,d2=3.4,$fn=64);}}translate([24.68172,14.25,35.1]){rotate([180,0,0]){translate([0,0,0]){cylinder(h=1.7,d1=6.4,d2=3.4,$fn=64);}}}}translate([-24.68172,14.25,30]){cylinder(h=7,d1=3.4,d2=3.4,$fn=64);}}translate([-24.68172,14.25,35.1]){rotate([180,0,0]){translate([0,0,0]){cylinder(h=1.7,d1=6.4,d2=3.4,$fn=64);}}}}translate([-0,-28.5,30]){cylinder(h=7,d1=3.4,d2=3.4,$fn=64);}}translate([-0,-28.5,35.1]){rotate([180,0,0]){translate([0,0,0]){cylinder(h=1.7,d1=6.4,d2=3.4,$fn=64);}}}}multmatrix([[1,0,0,0],[0,1,0,24],[0,0,1,35],[0,0,0,1]]){union(){union(){union(){union(){union(){union(){union(){union(){union(){union(){union(){union(){union(){union(){union(){union(){union(){union(){union(){union(){union(){union(){union(){union(){union(){union(){union(){union(){union(){union(){translate([-3.315,0.885,-0.3]){cube([0.63,0.63,0.42]);}translate([-2.715,0.885,-0.3]){cube([0.63,0.63,0.42]);}}translate([-3.315,0.285,-0.3]){cube([0.63,0.63,0.42]);}}translate([-2.115,0.285,-0.3]){cube([0.63,0.63,0.42]);}}translate([-3.315,-0.315,-0.3]){cube([0.63,0.63,0.42]);}}translate([-2.715,-0.315,-0.3]){cube([0.63,0.63,0.42]);}}translate([-3.315,-0.915,-0.3]){cube([0.63,0.63,0.42]);}}translate([-3.315,-1.515,-0.3]){cube([0.63,0.63,0.42]);}}translate([-0.915,0.885,-0.3]){cube([0.63,0.63,0.42]);}}translate([-0.315,0.885,-0.3]){cube([0.63,0.63,0.42]);}}translate([0.285,0.885,-0.3]){cube([0.63,0.63,0.42]);}}translate([-0.915,0.285,-0.3]){cube([0.63,0.63,0.42]);}}translate([0.285,0.285,-0.3]){cube([0.63,0.63,0.42]);}}translate([-0.915,-0.315,-0.3]){cube([0.63,0.63,0.42]);}}translate([0.285,-0.315,-0.3]){cube([0.63,0.63,0.42]);}}translate([-0.915,-0.915,-0.3]){cube([0.63,0.63,0.42]);}}translate([0.285,-0.915,-0.3]){cube([0.63,0.63,0.42]);}}translate([-0.915,-1.515,-0.3]){cube([0.63,0.63,0.42]);}}translate([-0.315,-1.515,-0.3]){cube([0.63,0.63,0.42]);}}translate([0.285,-1.515,-0.3]){cube([0.63,0.63,0.42]);}}translate([1.485,0.885,-0.3]){cube([0.63,0.63,0.42]);}}translate([2.085,0.885,-0.3]){cube([0.63,0.63,0.42]);}}translate([2.685,0.885,-0.3]){cube([0.63,0.63,0.42]);}}translate([2.685,0.285,-0.3]){cube([0.63,0.63,0.42]);}}translate([1.485,-0.315,-0.3]){cube([0.63,0.63,0.42]);}}translate([2.085,-0.315,-0.3]){cube([0.63,0.63,0.42]);}}translate([2.685,-0.315,-0.3]){cube([0.63,0.63,0.42]);}}translate([2.685,-0.915,-0.3]){cube([0.63,0.63,0.42]);}}translate([1.485,-1.515,-0.3]){cube([0.63,0.63,0.42]);}}translate([2.085,-1.515,-0.3]){cube([0.63,0.63,0.42]);}}translate([2.685,-1.515,-0.3]){cube([0.63,0.63,0.42]);}}}}}}
