shihkefa/esp32c3-card-dealer/V1.0.0/3d/OpenSCAD/P04A.scad

// 分離式旋轉承載盤
$fn=64;
translate([64,62,45.4]){rotate([180,0,0]){difference(){union(){difference(){difference(){union(){difference(){difference(){union(){difference(){difference(){union(){difference(){difference(){union(){intersection(){difference(){difference(){union(){difference(){difference(){union(){difference(){difference(){union(){union(){difference(){difference(){union(){difference(){difference(){difference(){difference(){difference(){difference(){difference(){difference(){difference(){difference(){difference(){difference(){difference(){difference(){difference(){difference(){difference(){difference(){difference(){difference(){difference(){difference(){difference(){difference(){difference(){difference(){difference(){difference(){difference(){difference(){difference(){difference(){difference(){difference(){difference(){difference(){difference(){difference(){difference(){difference(){union(){union(){union(){translate([0,0,36]){linear_extrude(height=6)polygon([[34.47768,-1.24081],[34.47768,-1.24081],[35.02172,-1.13154],[35.56632,-0.98654],[36.1109,-0.81088],[36.65497,-0.60751],[37.19808,-0.37839],[37.19979,-0.12613],[37.19979,0.12613],[37.19808,0.37839],[36.65497,0.60751],[36.1109,0.81088],[35.56632,0.98654],[35.02172,1.13154],[34.47768,1.24081],[34.47768,1.24081],[34.46207,1.61738],[34.44234,1.99375],[34.41851,2.36988],[34.41851,2.36988],[34.41851,2.36988],[34.94815,2.53542],[35.47461,2.73655],[35.99784,2.96817],[36.51767,3.2273],[37.03385,3.51194],[37.00919,3.763],[36.98282,4.01388],[36.95475,4.26458],[36.39066,4.43567],[35.82832,4.58106],[35.26836,4.69883],[34.71159,4.78611],[34.15911,4.83792],[34.15911,4.83792],[34.10422,5.21078],[34.04526,5.58303],[33.98224,5.95461],[33.98224,5.95461],[33.98224,5.95461],[34.49168,6.17461],[34.99422,6.42967],[35.49038,6.71471],[35.98028,7.02676],[36.46388,7.36379],[36.41311,7.61089],[36.36066,7.85765],[36.30654,8.10404],[35.72766,8.21523],[35.15319,8.30104],[34.584,8.35964],[34.02115,8.38824],[33.46628,8.38201],[33.46628,8.38201],[33.37272,8.7471],[33.27517,9.11115],[33.17365,9.4741],[33.17365,9.4741],[33.17365,9.4741],[33.65731,9.74615],[34.13044,10.05234],[34.59408,10.38768],[35.04868,10.74923],[35.4944,11.13497],[35.41808,11.37541],[35.34012,11.61532],[35.26054,11.85471],[34.67321,11.90479],[34.09293,11.93008],[33.52072,11.92886],[32.95797,11.89847],[32.40679,11.83427],[32.40679,11.83427],[32.27558,12.18758],[32.14051,12.53944],[32.00161,12.8898],[32.00161,12.8898],[32.00161,12.8898],[32.45418,13.2109],[32.89271,13.56487],[33.31876,13.94685],[33.73308,14.35393],[34.13604,14.78414],[34.035,15.01529],[33.93239,15.24574],[33.82823,15.4755],[33.23888,15.46391],[32.65913,15.4284],[32.09019,15.36738],[31.5337,15.27834],[30.99224,15.15688],[30.99224,15.15688],[30.82482,15.49453],[30.65371,15.83034],[30.47895,16.16426],[30.47895,16.16426],[30.47895,16.16426],[30.89548,16.53092],[31.29461,16.92879],[31.6784,17.3532],[32.04789,17.80136],[32.40367,18.27134],[32.27903,18.49066],[32.15289,18.70913],[32.02528,18.92673],[31.44037,18.85361],[30.86751,18.75769],[30.30807,18.63753],[29.76393,18.49081],[29.23814,18.31342],[29.23814,18.31342],[29.03634,18.63172],[28.83107,18.94781],[28.62236,19.26163],[28.62236,19.26163],[28.62236,19.26163],[28.99828,19.66981],[29.35363,20.10723],[29.69095,20.56943],[30.01158,21.05376],[30.31629,21.55836],[30.1694,21.76344],[30.02112,21.96753],[29.87146,22.1706],[29.2974,22.03674],[28.7377,21.88147],[28.19388,21.70349],[27.66807,21.50069],[27.1637,21.26931],[27.1637,21.26931],[26.92973,21.56478],[26.69254,21.85768],[26.45218,22.14797],[26.45218,22.14797],[26.45218,22.14797],[26.78336,22.59321],[27.09105,23.06537],[27.37821,23.5603],[27.64645,24.07549],[27.89675,24.60917],[27.72923,24.79778],[27.56043,24.98525],[27.39036,25.17157],[26.83344,24.97843],[26.29304,24.76551],[25.7708,24.53166],[25.26906,24.27501],[24.79164,23.99218],[24.79164,23.99218],[24.52807,24.26157],[24.26157,24.52807],[23.99218,24.79164],[23.99218,24.79164],[23.99218,24.79164],[24.27501,25.26906],[24.53166,25.7708],[24.76551,26.29304],[24.97843,26.83344],[25.17157,27.39036],[24.98525,27.56043],[24.79778,27.72923],[24.60917,27.89675],[24.07549,27.64645],[23.5603,27.37821],[23.06537,27.09105],[22.59321,26.78336],[22.14797,26.45218],[22.14797,26.45218],[21.85768,26.69254],[21.56478,26.92973],[21.26931,27.1637],[21.26931,27.1637],[21.26931,27.1637],[21.50069,27.66807],[21.70349,28.19388],[21.88147,28.7377],[22.03674,29.2974],[22.1706,29.87146],[21.96753,30.02112],[21.76344,30.1694],[21.55836,30.31629],[21.05376,30.01158],[20.56943,29.69095],[20.10723,29.35363],[19.66981,28.99828],[19.26163,28.62236],[19.26163,28.62236],[18.94781,28.83107],[18.63172,29.03634],[18.31342,29.23814],[18.31342,29.23814],[18.31342,29.23814],[18.49081,29.76393],[18.63753,30.30807],[18.75769,30.86751],[18.85361,31.44037],[18.92673,32.02528],[18.70913,32.15289],[18.49066,32.27903],[18.27134,32.40367],[17.80136,32.04789],[17.3532,31.6784],[16.92879,31.29461],[16.53092,30.89548],[16.16426,30.47895],[16.16426,30.47895],[15.83034,30.65371],[15.49453,30.82482],[15.15688,30.99224],[15.15688,30.99224],[15.15688,30.99224],[15.27834,31.5337],[15.36738,32.09019],[15.4284,32.65913],[15.46391,33.23888],[15.4755,33.82823],[15.24574,33.93239],[15.01529,34.035],[14.78414,34.13604],[14.35393,33.73308],[13.94685,33.31876],[13.56487,32.89271],[13.2109,32.45418],[12.8898,32.00161],[12.8898,32.00161],[12.53944,32.14051],[12.18758,32.27558],[11.83427,32.40679],[11.83427,32.40679],[11.83427,32.40679],[11.89847,32.95797],[11.92886,33.52072],[11.93008,34.09293],[11.90479,34.67321],[11.85471,35.26054],[11.61532,35.34012],[11.37541,35.41808],[11.13497,35.4944],[10.74923,35.04868],[10.38768,34.59408],[10.05234,34.13044],[9.74615,33.65731],[9.4741,33.17365],[9.4741,33.17365],[9.11115,33.27517],[8.7471,33.37272],[8.38201,33.46628],[8.38201,33.46628],[8.38201,33.46628],[8.38824,34.02115],[8.35964,34.584],[8.30104,35.15319],[8.21523,35.72766],[8.10404,36.30654],[7.85765,36.36066],[7.61089,36.41311],[7.36379,36.46388],[7.02676,35.98028],[6.71471,35.49038],[6.42967,34.99422],[6.17461,34.49168],[5.95461,33.98224],[5.95461,33.98224],[5.58303,34.04526],[5.21078,34.10422],[4.83792,34.15911],[4.83792,34.15911],[4.83792,34.15911],[4.78611,34.71159],[4.69883,35.26836],[4.58106,35.82832],[4.43567,36.39066],[4.26458,36.95475],[4.01388,36.98282],[3.763,37.00919],[3.51194,37.03385],[3.2273,36.51767],[2.96817,35.99784],[2.73655,35.47461],[2.53542,34.94815],[2.36988,34.41851],[2.36988,34.41851],[1.99375,34.44234],[1.61738,34.46207],[1.24081,34.47768],[1.24081,34.47768],[1.24081,34.47768],[1.13154,35.02172],[0.98654,35.56632],[0.81088,36.1109],[0.60751,36.65497],[0.37839,37.19808],[0.12613,37.19979],[-0.12613,37.19979],[-0.37839,37.19808],[-0.60751,36.65497],[-0.81088,36.1109],[-0.98654,35.56632],[-1.13154,35.02172],[-1.24081,34.47768],[-1.24081,34.47768],[-1.61738,34.46207],[-1.99375,34.44234],[-2.36988,34.41851],[-2.36988,34.41851],[-2.36988,34.41851],[-2.53542,34.94815],[-2.73655,35.47461],[-2.96817,35.99784],[-3.2273,36.51767],[-3.51194,37.03385],[-3.763,37.00919],[-4.01388,36.98282],[-4.26458,36.95475],[-4.43567,36.39066],[-4.58106,35.82832],[-4.69883,35.26836],[-4.78611,34.71159],[-4.83792,34.15911],[-4.83792,34.15911],[-5.21078,34.10422],[-5.58303,34.04526],[-5.95461,33.98224],[-5.95461,33.98224],[-5.95461,33.98224],[-6.17461,34.49168],[-6.42967,34.99422],[-6.71471,35.49038],[-7.02676,35.98028],[-7.36379,36.46388],[-7.61089,36.41311],[-7.85765,36.36066],[-8.10404,36.30654],[-8.21523,35.72766],[-8.30104,35.15319],[-8.35964,34.584],[-8.38824,34.02115],[-8.38201,33.46628],[-8.38201,33.46628],[-8.7471,33.37272],[-9.11115,33.27517],[-9.4741,33.17365],[-9.4741,33.17365],[-9.4741,33.17365],[-9.74615,33.65731],[-10.05234,34.13044],[-10.38768,34.59408],[-10.74923,35.04868],[-11.13497,35.4944],[-11.37541,35.41808],[-11.61532,35.34012],[-11.85471,35.26054],[-11.90479,34.67321],[-11.93008,34.09293],[-11.92886,33.52072],[-11.89847,32.95797],[-11.83427,32.40679],[-11.83427,32.40679],[-12.18758,32.27558],[-12.53944,32.14051],[-12.8898,32.00161],[-12.8898,32.00161],[-12.8898,32.00161],[-13.2109,32.45418],[-13.56487,32.89271],[-13.94685,33.31876],[-14.35393,33.73308],[-14.78414,34.13604],[-15.01529,34.035],[-15.24574,33.93239],[-15.4755,33.82823],[-15.46391,33.23888],[-15.4284,32.65913],[-15.36738,32.09019],[-15.27834,31.5337],[-15.15688,30.99224],[-15.15688,30.99224],[-15.49453,30.82482],[-15.83034,30.65371],[-16.16426,30.47895],[-16.16426,30.47895],[-16.16426,30.47895],[-16.53092,30.89548],[-16.92879,31.29461],[-17.3532,31.6784],[-17.80136,32.04789],[-18.27134,32.40367],[-18.49066,32.27903],[-18.70913,32.15289],[-18.92673,32.02528],[-18.85361,31.44037],[-18.75769,30.86751],[-18.63753,30.30807],[-18.49081,29.76393],[-18.31342,29.23814],[-18.31342,29.23814],[-18.63172,29.03634],[-18.94781,28.83107],[-19.26163,28.62236],[-19.26163,28.62236],[-19.26163,28.62236],[-19.66981,28.99828],[-20.10723,29.35363],[-20.56943,29.69095],[-21.05376,30.01158],[-21.55836,30.31629],[-21.76344,30.1694],[-21.96753,30.02112],[-22.1706,29.87146],[-22.03674,29.2974],[-21.88147,28.7377],[-21.70349,28.19388],[-21.50069,27.66807],[-21.26931,27.1637],[-21.26931,27.1637],[-21.56478,26.92973],[-21.85768,26.69254],[-22.14797,26.45218],[-22.14797,26.45218],[-22.14797,26.45218],[-22.59321,26.78336],[-23.06537,27.09105],[-23.5603,27.37821],[-24.07549,27.64645],[-24.60917,27.89675],[-24.79778,27.72923],[-24.98525,27.56043],[-25.17157,27.39036],[-24.97843,26.83344],[-24.76551,26.29304],[-24.53166,25.7708],[-24.27501,25.26906],[-23.99218,24.79164],[-23.99218,24.79164],[-24.26157,24.52807],[-24.52807,24.26157],[-24.79164,23.99218],[-24.79164,23.99218],[-24.79164,23.99218],[-25.26906,24.27501],[-25.7708,24.53166],[-26.29304,24.76551],[-26.83344,24.97843],[-27.39036,25.17157],[-27.56043,24.98525],[-27.72923,24.79778],[-27.89675,24.60917],[-27.64645,24.07549],[-27.37821,23.5603],[-27.09105,23.06537],[-26.78336,22.59321],[-26.45218,22.14797],[-26.45218,22.14797],[-26.69254,21.85768],[-26.92973,21.56478],[-27.1637,21.26931],[-27.1637,21.26931],[-27.1637,21.26931],[-27.66807,21.50069],[-28.19388,21.70349],[-28.7377,21.88147],[-29.2974,22.03674],[-29.87146,22.1706],[-30.02112,21.96753],[-30.1694,21.76344],[-30.31629,21.55836],[-30.01158,21.05376],[-29.69095,20.56943],[-29.35363,20.10723],[-28.99828,19.66981],[-28.62236,19.26163],[-28.62236,19.26163],[-28.83107,18.94781],[-29.03634,18.63172],[-29.23814,18.31342],[-29.23814,18.31342],[-29.23814,18.31342],[-29.76393,18.49081],[-30.30807,18.63753],[-30.86751,18.75769],[-31.44037,18.85361],[-32.02528,18.92673],[-32.15289,18.70913],[-32.27903,18.49066],[-32.40367,18.27134],[-32.04789,17.80136],[-31.6784,17.3532],[-31.29461,16.92879],[-30.89548,16.53092],[-30.47895,16.16426],[-30.47895,16.16426],[-30.65371,15.83034],[-30.82482,15.49453],[-30.99224,15.15688],[-30.99224,15.15688],[-30.99224,15.15688],[-31.5337,15.27834],[-32.09019,15.36738],[-32.65913,15.4284],[-33.23888,15.46391],[-33.82823,15.4755],[-33.93239,15.24574],[-34.035,15.01529],[-34.13604,14.78414],[-33.73308,14.35393],[-33.31876,13.94685],[-32.89271,13.56487],[-32.45418,13.2109],[-32.00161,12.8898],[-32.00161,12.8898],[-32.14051,12.53944],[-32.27558,12.18758],[-32.40679,11.83427],[-32.40679,11.83427],[-32.40679,11.83427],[-32.95797,11.89847],[-33.52072,11.92886],[-34.09293,11.93008],[-34.67321,11.90479],[-35.26054,11.85471],[-35.34012,11.61532],[-35.41808,11.37541],[-35.4944,11.13497],[-35.04868,10.74923],[-34.59408,10.38768],[-34.13044,10.05234],[-33.65731,9.74615],[-33.17365,9.4741],[-33.17365,9.4741],[-33.27517,9.11115],[-33.37272,8.7471],[-33.46628,8.38201],[-33.46628,8.38201],[-33.46628,8.38201],[-34.02115,8.38824],[-34.584,8.35964],[-35.15319,8.30104],[-35.72766,8.21523],[-36.30654,8.10404],[-36.36066,7.85765],[-36.41311,7.61089],[-36.46388,7.36379],[-35.98028,7.02676],[-35.49038,6.71471],[-34.99422,6.42967],[-34.49168,6.17461],[-33.98224,5.95461],[-33.98224,5.95461],[-34.04526,5.58303],[-34.10422,5.21078],[-34.15911,4.83792],[-34.15911,4.83792],[-34.15911,4.83792],[-34.71159,4.78611],[-35.26836,4.69883],[-35.82832,4.58106],[-36.39066,4.43567],[-36.95475,4.26458],[-36.98282,4.01388],[-37.00919,3.763],[-37.03385,3.51194],[-36.51767,3.2273],[-35.99784,2.96817],[-35.47461,2.73655],[-34.94815,2.53542],[-34.41851,2.36988],[-34.41851,2.36988],[-34.44234,1.99375],[-34.46207,1.61738],[-34.47768,1.24081],[-34.47768,1.24081],[-34.47768,1.24081],[-35.02172,1.13154],[-35.56632,0.98654],[-36.1109,0.81088],[-36.65497,0.60751],[-37.19808,0.37839],[-37.19979,0.12613],[-37.19979,-0.12613],[-37.19808,-0.37839],[-36.65497,-0.60751],[-36.1109,-0.81088],[-35.56632,-0.98654],[-35.02172,-1.13154],[-34.47768,-1.24081],[-34.47768,-1.24081],[-34.46207,-1.61738],[-34.44234,-1.99375],[-34.41851,-2.36988],[-34.41851,-2.36988],[-34.41851,-2.36988],[-34.94815,-2.53542],[-35.47461,-2.73655],[-35.99784,-2.96817],[-36.51767,-3.2273],[-37.03385,-3.51194],[-37.00919,-3.763],[-36.98282,-4.01388],[-36.95475,-4.26458],[-36.39066,-4.43567],[-35.82832,-4.58106],[-35.26836,-4.69883],[-34.71159,-4.78611],[-34.15911,-4.83792],[-34.15911,-4.83792],[-34.10422,-5.21078],[-34.04526,-5.58303],[-33.98224,-5.95461],[-33.98224,-5.95461],[-33.98224,-5.95461],[-34.49168,-6.17461],[-34.99422,-6.42967],[-35.49038,-6.71471],[-35.98028,-7.02676],[-36.46388,-7.36379],[-36.41311,-7.61089],[-36.36066,-7.85765],[-36.30654,-8.10404],[-35.72766,-8.21523],[-35.15319,-8.30104],[-34.584,-8.35964],[-34.02115,-8.38824],[-33.46628,-8.38201],[-33.46628,-8.38201],[-33.37272,-8.7471],[-33.27517,-9.11115],[-33.17365,-9.4741],[-33.17365,-9.4741],[-33.17365,-9.4741],[-33.65731,-9.74615],[-34.13044,-10.05234],[-34.59408,-10.38768],[-35.04868,-10.74923],[-35.4944,-11.13497],[-35.41808,-11.37541],[-35.34012,-11.61532],[-35.26054,-11.85471],[-34.67321,-11.90479],[-34.09293,-11.93008],[-33.52072,-11.92886],[-32.95797,-11.89847],[-32.40679,-11.83427],[-32.40679,-11.83427],[-32.27558,-12.18758],[-32.14051,-12.53944],[-32.00161,-12.8898],[-32.00161,-12.8898],[-32.00161,-12.8898],[-32.45418,-13.2109],[-32.89271,-13.56487],[-33.31876,-13.94685],[-33.73308,-14.35393],[-34.13604,-14.78414],[-34.035,-15.01529],[-33.93239,-15.24574],[-33.82823,-15.4755],[-33.23888,-15.46391],[-32.65913,-15.4284],[-32.09019,-15.36738],[-31.5337,-15.27834],[-30.99224,-15.15688],[-30.99224,-15.15688],[-30.82482,-15.49453],[-30.65371,-15.83034],[-30.47895,-16.16426],[-30.47895,-16.16426],[-30.47895,-16.16426],[-30.89548,-16.53092],[-31.29461,-16.92879],[-31.6784,-17.3532],[-32.04789,-17.80136],[-32.40367,-18.27134],[-32.27903,-18.49066],[-32.15289,-18.70913],[-32.02528,-18.92673],[-31.44037,-18.85361],[-30.86751,-18.75769],[-30.30807,-18.63753],[-29.76393,-18.49081],[-29.23814,-18.31342],[-29.23814,-18.31342],[-29.03634,-18.63172],[-28.83107,-18.94781],[-28.62236,-19.26163],[-28.62236,-19.26163],[-28.62236,-19.26163],[-28.99828,-19.66981],[-29.35363,-20.10723],[-29.69095,-20.56943],[-30.01158,-21.05376],[-30.31629,-21.55836],[-30.1694,-21.76344],[-30.02112,-21.96753],[-29.87146,-22.1706],[-29.2974,-22.03674],[-28.7377,-21.88147],[-28.19388,-21.70349],[-27.66807,-21.50069],[-27.1637,-21.26931],[-27.1637,-21.26931],[-26.92973,-21.56478],[-26.69254,-21.85768],[-26.45218,-22.14797],[-26.45218,-22.14797],[-26.45218,-22.14797],[-26.78336,-22.59321],[-27.09105,-23.06537],[-27.37821,-23.5603],[-27.64645,-24.07549],[-27.89675,-24.60917],[-27.72923,-24.79778],[-27.56043,-24.98525],[-27.39036,-25.17157],[-26.83344,-24.97843],[-26.29304,-24.76551],[-25.7708,-24.53166],[-25.26906,-24.27501],[-24.79164,-23.99218],[-24.79164,-23.99218],[-24.52807,-24.26157],[-24.26157,-24.52807],[-23.99218,-24.79164],[-23.99218,-24.79164],[-23.99218,-24.79164],[-24.27501,-25.26906],[-24.53166,-25.7708],[-24.76551,-26.29304],[-24.97843,-26.83344],[-25.17157,-27.39036],[-24.98525,-27.56043],[-24.79778,-27.72923],[-24.60917,-27.89675],[-24.07549,-27.64645],[-23.5603,-27.37821],[-23.06537,-27.09105],[-22.59321,-26.78336],[-22.14797,-26.45218],[-22.14797,-26.45218],[-21.85768,-26.69254],[-21.56478,-26.92973],[-21.26931,-27.1637],[-21.26931,-27.1637],[-21.26931,-27.1637],[-21.50069,-27.66807],[-21.70349,-28.19388],[-21.88147,-28.7377],[-22.03674,-29.2974],[-22.1706,-29.87146],[-21.96753,-30.02112],[-21.76344,-30.1694],[-21.55836,-30.31629],[-21.05376,-30.01158],[-20.56943,-29.69095],[-20.10723,-29.35363],[-19.66981,-28.99828],[-19.26163,-28.62236],[-19.26163,-28.62236],[-18.94781,-28.83107],[-18.63172,-29.03634],[-18.31342,-29.23814],[-18.31342,-29.23814],[-18.31342,-29.23814],[-18.49081,-29.76393],[-18.63753,-30.30807],[-18.75769,-30.86751],[-18.85361,-31.44037],[-18.92673,-32.02528],[-18.70913,-32.15289],[-18.49066,-32.27903],[-18.27134,-32.40367],[-17.80136,-32.04789],[-17.3532,-31.6784],[-16.92879,-31.29461],[-16.53092,-30.89548],[-16.16426,-30.47895],[-16.16426,-30.47895],[-15.83034,-30.65371],[-15.49453,-30.82482],[-15.15688,-30.99224],[-15.15688,-30.99224],[-15.15688,-30.99224],[-15.27834,-31.5337],[-15.36738,-32.09019],[-15.4284,-32.65913],[-15.46391,-33.23888],[-15.4755,-33.82823],[-15.24574,-33.93239],[-15.01529,-34.035],[-14.78414,-34.13604],[-14.35393,-33.73308],[-13.94685,-33.31876],[-13.56487,-32.89271],[-13.2109,-32.45418],[-12.8898,-32.00161],[-12.8898,-32.00161],[-12.53944,-32.14051],[-12.18758,-32.27558],[-11.83427,-32.40679],[-11.83427,-32.40679],[-11.83427,-32.40679],[-11.89847,-32.95797],[-11.92886,-33.52072],[-11.93008,-34.09293],[-11.90479,-34.67321],[-11.85471,-35.26054],[-11.61532,-35.34012],[-11.37541,-35.41808],[-11.13497,-35.4944],[-10.74923,-35.04868],[-10.38768,-34.59408],[-10.05234,-34.13044],[-9.74615,-33.65731],[-9.4741,-33.17365],[-9.4741,-33.17365],[-9.11115,-33.27517],[-8.7471,-33.37272],[-8.38201,-33.46628],[-8.38201,-33.46628],[-8.38201,-33.46628],[-8.38824,-34.02115],[-8.35964,-34.584],[-8.30104,-35.15319],[-8.21523,-35.72766],[-8.10404,-36.30654],[-7.85765,-36.36066],[-7.61089,-36.41311],[-7.36379,-36.46388],[-7.02676,-35.98028],[-6.71471,-35.49038],[-6.42967,-34.99422],[-6.17461,-34.49168],[-5.95461,-33.98224],[-5.95461,-33.98224],[-5.58303,-34.04526],[-5.21078,-34.10422],[-4.83792,-34.15911],[-4.83792,-34.15911],[-4.83792,-34.15911],[-4.78611,-34.71159],[-4.69883,-35.26836],[-4.58106,-35.82832],[-4.43567,-36.39066],[-4.26458,-36.95475],[-4.01388,-36.98282],[-3.763,-37.00919],[-3.51194,-37.03385],[-3.2273,-36.51767],[-2.96817,-35.99784],[-2.73655,-35.47461],[-2.53542,-34.94815],[-2.36988,-34.41851],[-2.36988,-34.41851],[-1.99375,-34.44234],[-1.61738,-34.46207],[-1.24081,-34.47768],[-1.24081,-34.47768],[-1.24081,-34.47768],[-1.13154,-35.02172],[-0.98654,-35.56632],[-0.81088,-36.1109],[-0.60751,-36.65497],[-0.37839,-37.19808],[-0.12613,-37.19979],[0.12613,-37.19979],[0.37839,-37.19808],[0.60751,-36.65497],[0.81088,-36.1109],[0.98654,-35.56632],[1.13154,-35.02172],[1.24081,-34.47768],[1.24081,-34.47768],[1.61738,-34.46207],[1.99375,-34.44234],[2.36988,-34.41851],[2.36988,-34.41851],[2.36988,-34.41851],[2.53542,-34.94815],[2.73655,-35.47461],[2.96817,-35.99784],[3.2273,-36.51767],[3.51194,-37.03385],[3.763,-37.00919],[4.01388,-36.98282],[4.26458,-36.95475],[4.43567,-36.39066],[4.58106,-35.82832],[4.69883,-35.26836],[4.78611,-34.71159],[4.83792,-34.15911],[4.83792,-34.15911],[5.21078,-34.10422],[5.58303,-34.04526],[5.95461,-33.98224],[5.95461,-33.98224],[5.95461,-33.98224],[6.17461,-34.49168],[6.42967,-34.99422],[6.71471,-35.49038],[7.02676,-35.98028],[7.36379,-36.46388],[7.61089,-36.41311],[7.85765,-36.36066],[8.10404,-36.30654],[8.21523,-35.72766],[8.30104,-35.15319],[8.35964,-34.584],[8.38824,-34.02115],[8.38201,-33.46628],[8.38201,-33.46628],[8.7471,-33.37272],[9.11115,-33.27517],[9.4741,-33.17365],[9.4741,-33.17365],[9.4741,-33.17365],[9.74615,-33.65731],[10.05234,-34.13044],[10.38768,-34.59408],[10.74923,-35.04868],[11.13497,-35.4944],[11.37541,-35.41808],[11.61532,-35.34012],[11.85471,-35.26054],[11.90479,-34.67321],[11.93008,-34.09293],[11.92886,-33.52072],[11.89847,-32.95797],[11.83427,-32.40679],[11.83427,-32.40679],[12.18758,-32.27558],[12.53944,-32.14051],[12.8898,-32.00161],[12.8898,-32.00161],[12.8898,-32.00161],[13.2109,-32.45418],[13.56487,-32.89271],[13.94685,-33.31876],[14.35393,-33.73308],[14.78414,-34.13604],[15.01529,-34.035],[15.24574,-33.93239],[15.4755,-33.82823],[15.46391,-33.23888],[15.4284,-32.65913],[15.36738,-32.09019],[15.27834,-31.5337],[15.15688,-30.99224],[15.15688,-30.99224],[15.49453,-30.82482],[15.83034,-30.65371],[16.16426,-30.47895],[16.16426,-30.47895],[16.16426,-30.47895],[16.53092,-30.89548],[16.92879,-31.29461],[17.3532,-31.6784],[17.80136,-32.04789],[18.27134,-32.40367],[18.49066,-32.27903],[18.70913,-32.15289],[18.92673,-32.02528],[18.85361,-31.44037],[18.75769,-30.86751],[18.63753,-30.30807],[18.49081,-29.76393],[18.31342,-29.23814],[18.31342,-29.23814],[18.63172,-29.03634],[18.94781,-28.83107],[19.26163,-28.62236],[19.26163,-28.62236],[19.26163,-28.62236],[19.66981,-28.99828],[20.10723,-29.35363],[20.56943,-29.69095],[21.05376,-30.01158],[21.55836,-30.31629],[21.76344,-30.1694],[21.96753,-30.02112],[22.1706,-29.87146],[22.03674,-29.2974],[21.88147,-28.7377],[21.70349,-28.19388],[21.50069,-27.66807],[21.26931,-27.1637],[21.26931,-27.1637],[21.56478,-26.92973],[21.85768,-26.69254],[22.14797,-26.45218],[22.14797,-26.45218],[22.14797,-26.45218],[22.59321,-26.78336],[23.06537,-27.09105],[23.5603,-27.37821],[24.07549,-27.64645],[24.60917,-27.89675],[24.79778,-27.72923],[24.98525,-27.56043],[25.17157,-27.39036],[24.97843,-26.83344],[24.76551,-26.29304],[24.53166,-25.7708],[24.27501,-25.26906],[23.99218,-24.79164],[23.99218,-24.79164],[24.26157,-24.52807],[24.52807,-24.26157],[24.79164,-23.99218],[24.79164,-23.99218],[24.79164,-23.99218],[25.26906,-24.27501],[25.7708,-24.53166],[26.29304,-24.76551],[26.83344,-24.97843],[27.39036,-25.17157],[27.56043,-24.98525],[27.72923,-24.79778],[27.89675,-24.60917],[27.64645,-24.07549],[27.37821,-23.5603],[27.09105,-23.06537],[26.78336,-22.59321],[26.45218,-22.14797],[26.45218,-22.14797],[26.69254,-21.85768],[26.92973,-21.56478],[27.1637,-21.26931],[27.1637,-21.26931],[27.1637,-21.26931],[27.66807,-21.50069],[28.19388,-21.70349],[28.7377,-21.88147],[29.2974,-22.03674],[29.87146,-22.1706],[30.02112,-21.96753],[30.1694,-21.76344],[30.31629,-21.55836],[30.01158,-21.05376],[29.69095,-20.56943],[29.35363,-20.10723],[28.99828,-19.66981],[28.62236,-19.26163],[28.62236,-19.26163],[28.83107,-18.94781],[29.03634,-18.63172],[29.23814,-18.31342],[29.23814,-18.31342],[29.23814,-18.31342],[29.76393,-18.49081],[30.30807,-18.63753],[30.86751,-18.75769],[31.44037,-18.85361],[32.02528,-18.92673],[32.15289,-18.70913],[32.27903,-18.49066],[32.40367,-18.27134],[32.04789,-17.80136],[31.6784,-17.3532],[31.29461,-16.92879],[30.89548,-16.53092],[30.47895,-16.16426],[30.47895,-16.16426],[30.65371,-15.83034],[30.82482,-15.49453],[30.99224,-15.15688],[30.99224,-15.15688],[30.99224,-15.15688],[31.5337,-15.27834],[32.09019,-15.36738],[32.65913,-15.4284],[33.23888,-15.46391],[33.82823,-15.4755],[33.93239,-15.24574],[34.035,-15.01529],[34.13604,-14.78414],[33.73308,-14.35393],[33.31876,-13.94685],[32.89271,-13.56487],[32.45418,-13.2109],[32.00161,-12.8898],[32.00161,-12.8898],[32.14051,-12.53944],[32.27558,-12.18758],[32.40679,-11.83427],[32.40679,-11.83427],[32.40679,-11.83427],[32.95797,-11.89847],[33.52072,-11.92886],[34.09293,-11.93008],[34.67321,-11.90479],[35.26054,-11.85471],[35.34012,-11.61532],[35.41808,-11.37541],[35.4944,-11.13497],[35.04868,-10.74923],[34.59408,-10.38768],[34.13044,-10.05234],[33.65731,-9.74615],[33.17365,-9.4741],[33.17365,-9.4741],[33.27517,-9.11115],[33.37272,-8.7471],[33.46628,-8.38201],[33.46628,-8.38201],[33.46628,-8.38201],[34.02115,-8.38824],[34.584,-8.35964],[35.15319,-8.30104],[35.72766,-8.21523],[36.30654,-8.10404],[36.36066,-7.85765],[36.41311,-7.61089],[36.46388,-7.36379],[35.98028,-7.02676],[35.49038,-6.71471],[34.99422,-6.42967],[34.49168,-6.17461],[33.98224,-5.95461],[33.98224,-5.95461],[34.04526,-5.58303],[34.10422,-5.21078],[34.15911,-4.83792],[34.15911,-4.83792],[34.15911,-4.83792],[34.71159,-4.78611],[35.26836,-4.69883],[35.82832,-4.58106],[36.39066,-4.43567],[36.95475,-4.26458],[36.98282,-4.01388],[37.00919,-3.763],[37.03385,-3.51194],[36.51767,-3.2273],[35.99784,-2.96817],[35.47461,-2.73655],[34.94815,-2.53542],[34.41851,-2.36988],[34.41851,-2.36988],[34.44234,-1.99375],[34.46207,-1.61738],[34.47768,-1.24081]]);}translate([0,0,13]){cylinder(h=29,d1=24.8,d2=24.8,$fn=64);}}translate([0,0,31]){cylinder(h=3,d1=31,d2=24.8,$fn=64);}}union(){union(){union(){union(){union(){union(){union(){union(){difference(){translate([0,0,42]){cylinder(h=3.4,d1=124,d2=124,$fn=64);}translate([0,0,41]){cylinder(h=5,d1=112,d2=112,$fn=64);}}difference(){translate([61,-14,0]){translate([0,0,42]){linear_extrude(height=3.4)polygon([[19,52],[18.88471,53.17054],[18.54328,54.2961],[17.98882,55.33342],[17.24264,56.24264],[16.33342,56.98882],[15.2961,57.54328],[14.17054,57.88471],[13,58],[-13,58],[-14.17054,57.88471],[-15.2961,57.54328],[-16.33342,56.98882],[-17.24264,56.24264],[-17.98882,55.33342],[-18.54328,54.2961],[-18.88471,53.17054],[-19,52],[-19,-52],[-18.88471,-53.17054],[-18.54328,-54.2961],[-17.98882,-55.33342],[-17.24264,-56.24264],[-16.33342,-56.98882],[-15.2961,-57.54328],[-14.17054,-57.88471],[-13,-58],[13,-58],[14.17054,-57.88471],[15.2961,-57.54328],[16.33342,-56.98882],[17.24264,-56.24264],[17.98882,-55.33342],[18.54328,-54.2961],[18.88471,-53.17054],[19,-52]]);}}translate([61,-14,0]){translate([0,0,41]){linear_extrude(height=5)polygon([[14,50],[13.94236,50.58527],[13.77164,51.14805],[13.49441,51.66671],[13.12132,52.12132],[12.66671,52.49441],[12.14805,52.77164],[11.58527,52.94236],[11,53],[-11,53],[-11.58527,52.94236],[-12.14805,52.77164],[-12.66671,52.49441],[-13.12132,52.12132],[-13.49441,51.66671],[-13.77164,51.14805],[-13.94236,50.58527],[-14,50],[-14,-50],[-13.94236,-50.58527],[-13.77164,-51.14805],[-13.49441,-51.66671],[-13.12132,-52.12132],[-12.66671,-52.49441],[-12.14805,-52.77164],[-11.58527,-52.94236],[-11,-53],[11,-53],[11.58527,-52.94236],[12.14805,-52.77164],[12.66671,-52.49441],[13.12132,-52.12132],[13.49441,-51.66671],[13.77164,-51.14805],[13.94236,-50.58527],[14,-50]]);}}}}translate([-59,-30,42]){cube([110,8,3.4]);}}translate([-59,22,42]){cube([110,8,3.4]);}}translate([-49,-52.5,42]){cube([8,105,3.4]);}}translate([27,-52.5,42]){cube([8,105,3.4]);}}translate([42,-64,42]){cube([38,8,3.4]);}}translate([42,-39,42]){cube([38,8,3.4]);}}translate([42,31,42]){cube([38,8,3.4]);}}}translate([0,0,10]){cylinder(h=40,d1=22.5,d2=22.5,$fn=64);}}translate([61,-69.2,54.2]){rotate([-90,0,0]){translate([0,0,0]){cylinder(h=17,d1=24.8,d2=24.8,$fn=64);}}}}translate([0,0,35]){linear_extrude(height=9)polygon([[29.54423,5.20945],[29.26987,6.57836],[28.93211,7.93302],[28.5317,9.27051],[28.06949,10.58792],[27.54648,11.88239],[26.96382,13.15113],[26.32276,14.39139],[25.62469,15.60048],[24.87113,16.77579],[24.0637,17.91476],[23.20415,19.01493],[22.29434,20.07392],[21.33626,21.08943],[20.33196,22.05927],[19.28363,22.98133],[11.57018,13.7888],[12.19918,13.23556],[12.80175,12.65366],[13.37661,12.04435],[13.92249,11.40896],[14.43822,10.74885],[14.92268,10.06547],[15.37482,9.36029],[15.79366,8.63484],[16.17829,7.89068],[16.52789,7.12944],[16.84169,6.35275],[17.11902,5.56231],[17.35927,4.75981],[17.56192,3.94702],[17.72654,3.12567]]);}}translate([0,0,35]){linear_extrude(height=9)polygon([[10.2606,28.19078],[8.93791,28.63763],[7.59586,29.02246],[6.23735,29.34443],[4.86534,29.60285],[3.48279,29.79715],[2.09269,29.92692],[0.69807,29.99188],[-0.69807,29.99188],[-2.09269,29.92692],[-3.48279,29.79715],[-4.86534,29.60285],[-6.23735,29.34443],[-7.59586,29.02246],[-8.93791,28.63763],[-10.2606,28.19078],[-6.15636,16.91447],[-5.36275,17.18258],[-4.55751,17.41347],[-3.74241,17.60666],[-2.9192,17.76171],[-2.08967,17.87829],[-1.25562,17.95615],[-0.41884,17.99513],[0.41884,17.99513],[1.25562,17.95615],[2.08967,17.87829],[2.9192,17.76171],[3.74241,17.60666],[4.55751,17.41347],[5.36275,17.18258],[6.15636,16.91447]]);}}translate([0,0,35]){linear_extrude(height=9)polygon([[-19.28363,22.98133],[-20.33196,22.05927],[-21.33626,21.08943],[-22.29434,20.07392],[-23.20415,19.01493],[-24.0637,17.91476],[-24.87113,16.77579],[-25.62469,15.60048],[-26.32276,14.39139],[-26.96382,13.15113],[-27.54648,11.88239],[-28.06949,10.58792],[-28.5317,9.27051],[-28.93211,7.93302],[-29.26987,6.57836],[-29.54423,5.20945],[-17.72654,3.12567],[-17.56192,3.94702],[-17.35927,4.75981],[-17.11902,5.56231],[-16.84169,6.35275],[-16.52789,7.12944],[-16.17829,7.89068],[-15.79366,8.63484],[-15.37482,9.36029],[-14.92268,10.06547],[-14.43822,10.74885],[-13.92249,11.40896],[-13.37661,12.04435],[-12.80175,12.65366],[-12.19918,13.23556],[-11.57018,13.7888]]);}}translate([0,0,35]){linear_extrude(height=9)polygon([[-29.54423,-5.20945],[-29.26987,-6.57836],[-28.93211,-7.93302],[-28.5317,-9.27051],[-28.06949,-10.58792],[-27.54648,-11.88239],[-26.96382,-13.15113],[-26.32276,-14.39139],[-25.62469,-15.60048],[-24.87113,-16.77579],[-24.0637,-17.91476],[-23.20415,-19.01493],[-22.29434,-20.07392],[-21.33626,-21.08943],[-20.33196,-22.05927],[-19.28363,-22.98133],[-11.57018,-13.7888],[-12.19918,-13.23556],[-12.80175,-12.65366],[-13.37661,-12.04435],[-13.92249,-11.40896],[-14.43822,-10.74885],[-14.92268,-10.06547],[-15.37482,-9.36029],[-15.79366,-8.63484],[-16.17829,-7.89068],[-16.52789,-7.12944],[-16.84169,-6.35275],[-17.11902,-5.56231],[-17.35927,-4.75981],[-17.56192,-3.94702],[-17.72654,-3.12567]]);}}translate([0,0,35]){linear_extrude(height=9)polygon([[-10.2606,-28.19078],[-8.93791,-28.63763],[-7.59586,-29.02246],[-6.23735,-29.34443],[-4.86534,-29.60285],[-3.48279,-29.79715],[-2.09269,-29.92692],[-0.69807,-29.99188],[0.69807,-29.99188],[2.09269,-29.92692],[3.48279,-29.79715],[4.86534,-29.60285],[6.23735,-29.34443],[7.59586,-29.02246],[8.93791,-28.63763],[10.2606,-28.19078],[6.15636,-16.91447],[5.36275,-17.18258],[4.55751,-17.41347],[3.74241,-17.60666],[2.9192,-17.76171],[2.08967,-17.87829],[1.25562,-17.95615],[0.41884,-17.99513],[-0.41884,-17.99513],[-1.25562,-17.95615],[-2.08967,-17.87829],[-2.9192,-17.76171],[-3.74241,-17.60666],[-4.55751,-17.41347],[-5.36275,-17.18258],[-6.15636,-16.91447]]);}}translate([0,0,35]){linear_extrude(height=9)polygon([[19.28363,-22.98133],[20.33196,-22.05927],[21.33626,-21.08943],[22.29434,-20.07392],[23.20415,-19.01493],[24.0637,-17.91476],[24.87113,-16.77579],[25.62469,-15.60048],[26.32276,-14.39139],[26.96382,-13.15113],[27.54648,-11.88239],[28.06949,-10.58792],[28.5317,-9.27051],[28.93211,-7.93302],[29.26987,-6.57836],[29.54423,-5.20945],[17.72654,-3.12567],[17.56192,-3.94702],[17.35927,-4.75981],[17.11902,-5.56231],[16.84169,-6.35275],[16.52789,-7.12944],[16.17829,-7.89068],[15.79366,-8.63484],[15.37482,-9.36029],[14.92268,-10.06547],[14.43822,-10.74885],[13.92249,-11.40896],[13.37661,-12.04435],[12.80175,-12.65366],[12.19918,-13.23556],[11.57018,-13.7888]]);}}translate([-45,-26,40]){cylinder(h=8,d1=3.4,d2=3.4,$fn=64);}}translate([-45,-26,41]){cylinder(h=2.6,d1=6.55,d2=6.55,$fn=6);}}translate([-45,26,40]){cylinder(h=8,d1=3.4,d2=3.4,$fn=64);}}translate([-45,26,41]){cylinder(h=2.6,d1=6.55,d2=6.55,$fn=6);}}translate([-45,-44,40]){cylinder(h=8,d1=3.4,d2=3.4,$fn=64);}}translate([-45,-44,41]){cylinder(h=2.7,d1=6.55,d2=6.55,$fn=6);}}translate([-45,44,40]){cylinder(h=8,d1=3.4,d2=3.4,$fn=64);}}translate([-45,44,41]){cylinder(h=2.7,d1=6.55,d2=6.55,$fn=6);}}translate([31,-26,40]){cylinder(h=8,d1=3.4,d2=3.4,$fn=64);}}translate([31,-26,41]){cylinder(h=2.6,d1=6.55,d2=6.55,$fn=6);}}translate([31,26,40]){cylinder(h=8,d1=3.4,d2=3.4,$fn=64);}}translate([31,26,41]){cylinder(h=2.6,d1=6.55,d2=6.55,$fn=6);}}translate([31,-44,40]){cylinder(h=8,d1=3.4,d2=3.4,$fn=64);}}translate([31,-44,41]){cylinder(h=2.7,d1=6.55,d2=6.55,$fn=6);}}translate([31,44,40]){cylinder(h=8,d1=3.4,d2=3.4,$fn=64);}}translate([31,44,41]){cylinder(h=2.7,d1=6.55,d2=6.55,$fn=6);}}translate([-33,-19,41]){cylinder(h=6,d1=3.4,d2=3.4,$fn=64);}}translate([-33,-19,41]){cylinder(h=2.7,d1=6.55,d2=6.55,$fn=6);}}translate([-12,-19,41]){cylinder(h=6,d1=3.4,d2=3.4,$fn=64);}}translate([-12,-19,41]){cylinder(h=2.7,d1=6.55,d2=6.55,$fn=6);}}translate([49,-60,41]){cylinder(h=6,d1=3.4,d2=3.4,$fn=64);}}translate([49,-60,41]){cylinder(h=2.7,d1=6.55,d2=6.55,$fn=6);}}translate([72,-60,41]){cylinder(h=6,d1=3.4,d2=3.4,$fn=64);}}translate([72,-60,41]){cylinder(h=2.7,d1=6.55,d2=6.55,$fn=6);}}translate([55,-35,41]){cylinder(h=6,d1=3.4,d2=3.4,$fn=64);}}translate([55,-35,41]){cylinder(h=2.7,d1=6.55,d2=6.55,$fn=6);}}translate([67,-35,41]){cylinder(h=6,d1=3.4,d2=3.4,$fn=64);}}translate([67,-35,41]){cylinder(h=2.7,d1=6.55,d2=6.55,$fn=6);}}translate([55,35,41]){cylinder(h=6,d1=3.4,d2=3.4,$fn=64);}}translate([55,35,41]){cylinder(h=2.7,d1=6.55,d2=6.55,$fn=6);}}translate([67,35,41]){cylinder(h=6,d1=3.4,d2=3.4,$fn=64);}}translate([67,35,41]){cylinder(h=2.7,d1=6.55,d2=6.55,$fn=6);}}translate([-58,10,42]){cylinder(h=3.4,d1=9,d2=9,$fn=64);}}translate([-58,10,40]){cylinder(h=12,d1=3.4,d2=3.4,$fn=64);}}translate([-14.5,0,15.5]){rotate([0,90,0]){translate([0,0,0]){cylinder(h=5,d1=3.4,d2=3.4,$fn=64);}}}}translate([66,39,42]){cube([12,12,3.4]);}}translate([-59,0,42]){cylinder(h=3.4,d1=10,d2=10,$fn=64);}}translate([-59,0,40]){cylinder(h=9,d1=3.4,d2=3.4,$fn=64);}}translate([-59,0,41.9]){cylinder(h=1.5,d1=6.4,d2=3.4,$fn=64);}}translate([0,57,42]){cylinder(h=3.4,d1=10,d2=10,$fn=64);}}translate([0,57,40]){cylinder(h=9,d1=3.4,d2=3.4,$fn=64);}}translate([0,57,41.9]){cylinder(h=1.5,d1=6.4,d2=3.4,$fn=64);}}translate([72,49,42]){cylinder(h=3.4,d1=10,d2=10,$fn=64);}}translate([72,49,40]){cylinder(h=9,d1=3.4,d2=3.4,$fn=64);}}translate([72,49,41.9]){cylinder(h=1.5,d1=6.4,d2=3.4,$fn=64);}}translate([-110,-110,42]){cube([220,220,5]);}}translate([-15,-26,42]){cylinder(h=3.4,d1=10,d2=10,$fn=64);}}translate([-15,-26,41.8]){cylinder(h=4,d1=3.4,d2=3.4,$fn=64);}}translate([-15,-26,45.5]){rotate([180,0,0]){translate([0,0,0]){cylinder(h=1.7,d1=6.4,d2=3.4,$fn=64);}}}}translate([-15,26,42]){cylinder(h=3.4,d1=10,d2=10,$fn=64);}}translate([-15,26,41.8]){cylinder(h=4,d1=3.4,d2=3.4,$fn=64);}}translate([-15,26,45.5]){rotate([180,0,0]){translate([0,0,0]){cylinder(h=1.7,d1=6.4,d2=3.4,$fn=64);}}}}translate([15,-26,42]){cylinder(h=3.4,d1=10,d2=10,$fn=64);}}translate([15,-26,41.8]){cylinder(h=4,d1=3.4,d2=3.4,$fn=64);}}translate([15,-26,45.5]){rotate([180,0,0]){translate([0,0,0]){cylinder(h=1.7,d1=6.4,d2=3.4,$fn=64);}}}}translate([15,26,42]){cylinder(h=3.4,d1=10,d2=10,$fn=64);}}translate([15,26,41.8]){cylinder(h=4,d1=3.4,d2=3.4,$fn=64);}}translate([15,26,45.5]){rotate([180,0,0]){translate([0,0,0]){cylinder(h=1.7,d1=6.4,d2=3.4,$fn=64);}}}}translate([28,-4,40.8]){cube([6,8,1.2]);}}multmatrix([[0,1,0,-45],[1,0,0,-36],[0,0,-1,42],[0,0,0,1]]){union(){union(){union(){union(){union(){union(){union(){union(){union(){union(){union(){union(){union(){union(){union(){union(){union(){union(){union(){union(){union(){union(){union(){union(){union(){union(){union(){union(){union(){union(){union(){union(){union(){union(){union(){union(){union(){union(){translate([-4.515,0.885,-0.3]){cube([0.63,0.63,0.42]);}translate([-3.915,0.885,-0.3]){cube([0.63,0.63,0.42]);}}translate([-4.515,0.285,-0.3]){cube([0.63,0.63,0.42]);}}translate([-3.315,0.285,-0.3]){cube([0.63,0.63,0.42]);}}translate([-4.515,-0.315,-0.3]){cube([0.63,0.63,0.42]);}}translate([-3.915,-0.315,-0.3]){cube([0.63,0.63,0.42]);}}translate([-4.515,-0.915,-0.3]){cube([0.63,0.63,0.42]);}}translate([-4.515,-1.515,-0.3]){cube([0.63,0.63,0.42]);}}translate([-2.115,0.885,-0.3]){cube([0.63,0.63,0.42]);}}translate([-1.515,0.885,-0.3]){cube([0.63,0.63,0.42]);}}translate([-0.915,0.885,-0.3]){cube([0.63,0.63,0.42]);}}translate([-2.115,0.285,-0.3]){cube([0.63,0.63,0.42]);}}translate([-0.915,0.285,-0.3]){cube([0.63,0.63,0.42]);}}translate([-2.115,-0.315,-0.3]){cube([0.63,0.63,0.42]);}}translate([-0.915,-0.315,-0.3]){cube([0.63,0.63,0.42]);}}translate([-2.115,-0.915,-0.3]){cube([0.63,0.63,0.42]);}}translate([-0.915,-0.915,-0.3]){cube([0.63,0.63,0.42]);}}translate([-2.115,-1.515,-0.3]){cube([0.63,0.63,0.42]);}}translate([-1.515,-1.515,-0.3]){cube([0.63,0.63,0.42]);}}translate([-0.915,-1.515,-0.3]){cube([0.63,0.63,0.42]);}}translate([0.285,0.885,-0.3]){cube([0.63,0.63,0.42]);}}translate([1.485,0.885,-0.3]){cube([0.63,0.63,0.42]);}}translate([0.285,0.285,-0.3]){cube([0.63,0.63,0.42]);}}translate([1.485,0.285,-0.3]){cube([0.63,0.63,0.42]);}}translate([0.285,-0.315,-0.3]){cube([0.63,0.63,0.42]);}}translate([0.885,-0.315,-0.3]){cube([0.63,0.63,0.42]);}}translate([1.485,-0.315,-0.3]){cube([0.63,0.63,0.42]);}}translate([1.485,-0.915,-0.3]){cube([0.63,0.63,0.42]);}}translate([1.485,-1.515,-0.3]){cube([0.63,0.63,0.42]);}}translate([3.285,0.885,-0.3]){cube([0.63,0.63,0.42]);}}translate([2.685,0.285,-0.3]){cube([0.63,0.63,0.42]);}}translate([3.885,0.285,-0.3]){cube([0.63,0.63,0.42]);}}translate([2.685,-0.315,-0.3]){cube([0.63,0.63,0.42]);}}translate([3.285,-0.315,-0.3]){cube([0.63,0.63,0.42]);}}translate([3.885,-0.315,-0.3]){cube([0.63,0.63,0.42]);}}translate([2.685,-0.915,-0.3]){cube([0.63,0.63,0.42]);}}translate([3.885,-0.915,-0.3]){cube([0.63,0.63,0.42]);}}translate([2.685,-1.515,-0.3]){cube([0.63,0.63,0.42]);}}translate([3.885,-1.515,-0.3]){cube([0.63,0.63,0.42]);}}}}}}
