shihkefa/esp32c3-card-dealer/V1.0.0/3d/OpenSCAD/P05A.scad

// 平口內腔30齒輪與止退裙邊
$fn=64;
translate([-34.87208,19.19965,40]){rotate([180,0,0]){difference(){difference(){difference(){difference(){difference(){difference(){difference(){union(){translate([54,0,0]){rotate([0,0,6]){translate([0,0,34]){linear_extrude(height=6)polygon([[16.46803,-1.0267],[16.88169,-1.05249],[17.34224,-1.00917],[17.80578,-0.90344],[18.27023,-0.75412],[18.7343,-0.56735],[19.19687,-0.34642],[19.19965,-0.11548],[19.19965,0.11548],[19.19687,0.34642],[18.7343,0.56735],[18.27023,0.75412],[17.80578,0.90344],[17.34224,1.00917],[16.88169,1.05249],[16.46803,1.0267],[16.43238,1.49233],[16.38356,1.95677],[16.32162,2.41963],[16.32162,2.41963],[16.73161,2.48041],[17.17308,2.61854],[17.60451,2.81833],[18.02777,3.06095],[18.44287,3.34013],[18.8494,3.6524],[18.8041,3.87888],[18.75608,4.10479],[18.70535,4.33011],[18.20696,4.45003],[17.71419,4.53624],[17.22884,4.58573],[16.75345,4.59277],[16.29396,4.53939],[15.8947,4.42816],[15.76302,4.8762],[15.61871,5.32034],[15.46189,5.76022],[15.46189,5.76022],[15.85028,5.90491],[16.25339,6.1318],[16.63385,6.41693],[16.99741,6.74225],[17.3454,7.10163],[17.67812,7.4916],[17.58673,7.70371],[17.49279,7.9147],[17.39632,8.12454],[16.88388,8.13822],[16.38396,8.1201],[15.89892,8.0676],[15.43246,7.97564],[14.99411,7.8279],[14.6267,7.63608],[14.40474,8.04696],[14.17124,8.45139],[13.92639,8.84905],[13.92639,8.84905],[14.27621,9.07133],[14.62334,9.37708],[14.9362,9.73507],[15.22419,10.12888],[15.48985,10.55276],[15.73422,11.00338],[15.60072,11.19185],[15.46497,11.3787],[15.32698,11.5639],[14.82289,11.47074],[14.33767,11.34907],[13.87415,11.19687],[13.43699,11.00994],[13.03894,10.77429],[12.71944,10.51028],[12.4169,10.86603],[12.10442,11.21307],[11.78224,11.55113],[11.78224,11.55113],[12.07821,11.84129],[12.35418,12.21253],[12.58578,12.62775],[12.78559,13.07282],[12.95732,13.54267],[13.10266,14.03426],[12.93289,14.19085],[12.76126,14.34539],[12.58778,14.49786],[12.11408,14.30193],[11.66475,14.08203],[11.243,13.83679],[10.85426,13.56306],[10.51391,13.24979],[10.25628,12.92512],[9.88639,13.2102],[9.50858,13.48469],[9.12316,13.74838],[9.12316,13.74838],[9.35233,14.09373],[9.54508,14.51423],[9.68529,14.96853],[9.7882,15.44542],[9.85849,15.94071],[9.89845,16.45177],[9.69983,16.56965],[9.49982,16.68513],[9.29843,16.79819],[8.87582,16.50806],[8.48203,16.19954],[8.12048,15.87197],[7.79715,15.5234],[7.52937,15.14622],[7.34487,14.77508],[6.92379,14.97702],[6.49717,15.16696],[6.06535,15.34476],[6.06535,15.34476],[6.2177,15.73021],[6.31882,16.1816],[6.36151,16.65512],[6.36302,17.14299],[6.3288,17.64206],[6.26163,18.15026],[6.04285,18.22427],[5.82319,18.29564],[5.60269,18.36436],[5.24964,17.9927],[4.9286,17.60906],[4.64306,17.21348],[4.39927,16.8053],[4.21576,16.38068],[4.11245,15.97929],[3.65859,16.08927],[3.2018,16.18637],[2.74245,16.27049],[2.74245,16.27049],[2.81134,16.6792],[2.8164,17.14175],[2.7597,17.6138],[2.65975,18.09132],[2.52251,18.57237],[2.35114,19.0555],[2.12176,19.0824],[1.89206,19.10655],[1.6621,19.12792],[1.39403,18.69098],[1.15977,18.24897],[0.96272,17.80267],[0.80912,17.35272],[0.7179,16.89923],[0.70031,16.48513],[0.2335,16.49835],[-0.2335,16.49835],[-0.70031,16.48513],[-0.70031,16.48513],[-0.7179,16.89923],[-0.80912,17.35272],[-0.96272,17.80267],[-1.15977,18.24897],[-1.39403,18.69098],[-1.6621,19.12792],[-1.89206,19.10655],[-2.12176,19.0824],[-2.35114,19.0555],[-2.52251,18.57237],[-2.65975,18.09132],[-2.7597,17.6138],[-2.8164,17.14175],[-2.81134,16.6792],[-2.74245,16.27049],[-3.2018,16.18637],[-3.65859,16.08927],[-4.11245,15.97929],[-4.11245,15.97929],[-4.21576,16.38068],[-4.39927,16.8053],[-4.64306,17.21348],[-4.9286,17.60906],[-5.24964,17.9927],[-5.60269,18.36436],[-5.82319,18.29564],[-6.04285,18.22427],[-6.26163,18.15026],[-6.3288,17.64206],[-6.36302,17.14299],[-6.36151,16.65512],[-6.31882,16.1816],[-6.2177,15.73021],[-6.06535,15.34476],[-6.49717,15.16696],[-6.92379,14.97702],[-7.34487,14.77508],[-7.34487,14.77508],[-7.52937,15.14622],[-7.79715,15.5234],[-8.12048,15.87197],[-8.48203,16.19954],[-8.87582,16.50806],[-9.29843,16.79819],[-9.49982,16.68513],[-9.69983,16.56965],[-9.89845,16.45177],[-9.85849,15.94071],[-9.7882,15.44542],[-9.68529,14.96853],[-9.54508,14.51423],[-9.35233,14.09373],[-9.12316,13.74838],[-9.50858,13.48469],[-9.88639,13.2102],[-10.25628,12.92512],[-10.25628,12.92512],[-10.51391,13.24979],[-10.85426,13.56306],[-11.243,13.83679],[-11.66475,14.08203],[-12.11408,14.30193],[-12.58778,14.49786],[-12.76126,14.34539],[-12.93289,14.19085],[-13.10266,14.03426],[-12.95732,13.54267],[-12.78559,13.07282],[-12.58578,12.62775],[-12.35418,12.21253],[-12.07821,11.84129],[-11.78224,11.55113],[-12.10442,11.21307],[-12.4169,10.86603],[-12.71944,10.51028],[-12.71944,10.51028],[-13.03894,10.77429],[-13.43699,11.00994],[-13.87415,11.19687],[-14.33767,11.34907],[-14.82289,11.47074],[-15.32698,11.5639],[-15.46497,11.3787],[-15.60072,11.19185],[-15.73422,11.00338],[-15.48985,10.55276],[-15.22419,10.12888],[-14.9362,9.73507],[-14.62334,9.37708],[-14.27621,9.07133],[-13.92639,8.84905],[-14.17124,8.45139],[-14.40474,8.04696],[-14.6267,7.63608],[-14.6267,7.63608],[-14.99411,7.8279],[-15.43246,7.97564],[-15.89892,8.0676],[-16.38396,8.1201],[-16.88388,8.13822],[-17.39632,8.12454],[-17.49279,7.9147],[-17.58673,7.70371],[-17.67812,7.4916],[-17.3454,7.10163],[-16.99741,6.74225],[-16.63385,6.41693],[-16.25339,6.1318],[-15.85028,5.90491],[-15.46189,5.76022],[-15.61871,5.32034],[-15.76302,4.8762],[-15.8947,4.42816],[-15.8947,4.42816],[-16.29396,4.53939],[-16.75345,4.59277],[-17.22884,4.58573],[-17.71419,4.53624],[-18.20696,4.45003],[-18.70535,4.33011],[-18.75608,4.10479],[-18.8041,3.87888],[-18.8494,3.6524],[-18.44287,3.34013],[-18.02777,3.06095],[-17.60451,2.81833],[-17.17308,2.61854],[-16.73161,2.48041],[-16.32162,2.41963],[-16.38356,1.95677],[-16.43238,1.49233],[-16.46803,1.0267],[-16.46803,1.0267],[-16.88169,1.05249],[-17.34224,1.00917],[-17.80578,0.90344],[-18.27023,0.75412],[-18.7343,0.56735],[-19.19687,0.34642],[-19.19965,0.11548],[-19.19965,-0.11548],[-19.19687,-0.34642],[-18.7343,-0.56735],[-18.27023,-0.75412],[-17.80578,-0.90344],[-17.34224,-1.00917],[-16.88169,-1.05249],[-16.46803,-1.0267],[-16.43238,-1.49233],[-16.38356,-1.95677],[-16.32162,-2.41963],[-16.32162,-2.41963],[-16.73161,-2.48041],[-17.17308,-2.61854],[-17.60451,-2.81833],[-18.02777,-3.06095],[-18.44287,-3.34013],[-18.8494,-3.6524],[-18.8041,-3.87888],[-18.75608,-4.10479],[-18.70535,-4.33011],[-18.20696,-4.45003],[-17.71419,-4.53624],[-17.22884,-4.58573],[-16.75345,-4.59277],[-16.29396,-4.53939],[-15.8947,-4.42816],[-15.76302,-4.8762],[-15.61871,-5.32034],[-15.46189,-5.76022],[-15.46189,-5.76022],[-15.85028,-5.90491],[-16.25339,-6.1318],[-16.63385,-6.41693],[-16.99741,-6.74225],[-17.3454,-7.10163],[-17.67812,-7.4916],[-17.58673,-7.70371],[-17.49279,-7.9147],[-17.39632,-8.12454],[-16.88388,-8.13822],[-16.38396,-8.1201],[-15.89892,-8.0676],[-15.43246,-7.97564],[-14.99411,-7.8279],[-14.6267,-7.63608],[-14.40474,-8.04696],[-14.17124,-8.45139],[-13.92639,-8.84905],[-13.92639,-8.84905],[-14.27621,-9.07133],[-14.62334,-9.37708],[-14.9362,-9.73507],[-15.22419,-10.12888],[-15.48985,-10.55276],[-15.73422,-11.00338],[-15.60072,-11.19185],[-15.46497,-11.3787],[-15.32698,-11.5639],[-14.82289,-11.47074],[-14.33767,-11.34907],[-13.87415,-11.19687],[-13.43699,-11.00994],[-13.03894,-10.77429],[-12.71944,-10.51028],[-12.4169,-10.86603],[-12.10442,-11.21307],[-11.78224,-11.55113],[-11.78224,-11.55113],[-12.07821,-11.84129],[-12.35418,-12.21253],[-12.58578,-12.62775],[-12.78559,-13.07282],[-12.95732,-13.54267],[-13.10266,-14.03426],[-12.93289,-14.19085],[-12.76126,-14.34539],[-12.58778,-14.49786],[-12.11408,-14.30193],[-11.66475,-14.08203],[-11.243,-13.83679],[-10.85426,-13.56306],[-10.51391,-13.24979],[-10.25628,-12.92512],[-9.88639,-13.2102],[-9.50858,-13.48469],[-9.12316,-13.74838],[-9.12316,-13.74838],[-9.35233,-14.09373],[-9.54508,-14.51423],[-9.68529,-14.96853],[-9.7882,-15.44542],[-9.85849,-15.94071],[-9.89845,-16.45177],[-9.69983,-16.56965],[-9.49982,-16.68513],[-9.29843,-16.79819],[-8.87582,-16.50806],[-8.48203,-16.19954],[-8.12048,-15.87197],[-7.79715,-15.5234],[-7.52937,-15.14622],[-7.34487,-14.77508],[-6.92379,-14.97702],[-6.49717,-15.16696],[-6.06535,-15.34476],[-6.06535,-15.34476],[-6.2177,-15.73021],[-6.31882,-16.1816],[-6.36151,-16.65512],[-6.36302,-17.14299],[-6.3288,-17.64206],[-6.26163,-18.15026],[-6.04285,-18.22427],[-5.82319,-18.29564],[-5.60269,-18.36436],[-5.24964,-17.9927],[-4.9286,-17.60906],[-4.64306,-17.21348],[-4.39927,-16.8053],[-4.21576,-16.38068],[-4.11245,-15.97929],[-3.65859,-16.08927],[-3.2018,-16.18637],[-2.74245,-16.27049],[-2.74245,-16.27049],[-2.81134,-16.6792],[-2.8164,-17.14175],[-2.7597,-17.6138],[-2.65975,-18.09132],[-2.52251,-18.57237],[-2.35114,-19.0555],[-2.12176,-19.0824],[-1.89206,-19.10655],[-1.6621,-19.12792],[-1.39403,-18.69098],[-1.15977,-18.24897],[-0.96272,-17.80267],[-0.80912,-17.35272],[-0.7179,-16.89923],[-0.70031,-16.48513],[-0.2335,-16.49835],[0.2335,-16.49835],[0.70031,-16.48513],[0.70031,-16.48513],[0.7179,-16.89923],[0.80912,-17.35272],[0.96272,-17.80267],[1.15977,-18.24897],[1.39403,-18.69098],[1.6621,-19.12792],[1.89206,-19.10655],[2.12176,-19.0824],[2.35114,-19.0555],[2.52251,-18.57237],[2.65975,-18.09132],[2.7597,-17.6138],[2.8164,-17.14175],[2.81134,-16.6792],[2.74245,-16.27049],[3.2018,-16.18637],[3.65859,-16.08927],[4.11245,-15.97929],[4.11245,-15.97929],[4.21576,-16.38068],[4.39927,-16.8053],[4.64306,-17.21348],[4.9286,-17.60906],[5.24964,-17.9927],[5.60269,-18.36436],[5.82319,-18.29564],[6.04285,-18.22427],[6.26163,-18.15026],[6.3288,-17.64206],[6.36302,-17.14299],[6.36151,-16.65512],[6.31882,-16.1816],[6.2177,-15.73021],[6.06535,-15.34476],[6.49717,-15.16696],[6.92379,-14.97702],[7.34487,-14.77508],[7.34487,-14.77508],[7.52937,-15.14622],[7.79715,-15.5234],[8.12048,-15.87197],[8.48203,-16.19954],[8.87582,-16.50806],[9.29843,-16.79819],[9.49982,-16.68513],[9.69983,-16.56965],[9.89845,-16.45177],[9.85849,-15.94071],[9.7882,-15.44542],[9.68529,-14.96853],[9.54508,-14.51423],[9.35233,-14.09373],[9.12316,-13.74838],[9.50858,-13.48469],[9.88639,-13.2102],[10.25628,-12.92512],[10.25628,-12.92512],[10.51391,-13.24979],[10.85426,-13.56306],[11.243,-13.83679],[11.66475,-14.08203],[12.11408,-14.30193],[12.58778,-14.49786],[12.76126,-14.34539],[12.93289,-14.19085],[13.10266,-14.03426],[12.95732,-13.54267],[12.78559,-13.07282],[12.58578,-12.62775],[12.35418,-12.21253],[12.07821,-11.84129],[11.78224,-11.55113],[12.10442,-11.21307],[12.4169,-10.86603],[12.71944,-10.51028],[12.71944,-10.51028],[13.03894,-10.77429],[13.43699,-11.00994],[13.87415,-11.19687],[14.33767,-11.34907],[14.82289,-11.47074],[15.32698,-11.5639],[15.46497,-11.3787],[15.60072,-11.19185],[15.73422,-11.00338],[15.48985,-10.55276],[15.22419,-10.12888],[14.9362,-9.73507],[14.62334,-9.37708],[14.27621,-9.07133],[13.92639,-8.84905],[14.17124,-8.45139],[14.40474,-8.04696],[14.6267,-7.63608],[14.6267,-7.63608],[14.99411,-7.8279],[15.43246,-7.97564],[15.89892,-8.0676],[16.38396,-8.1201],[16.88388,-8.13822],[17.39632,-8.12454],[17.49279,-7.9147],[17.58673,-7.70371],[17.67812,-7.4916],[17.3454,-7.10163],[16.99741,-6.74225],[16.63385,-6.41693],[16.25339,-6.1318],[15.85028,-5.90491],[15.46189,-5.76022],[15.61871,-5.32034],[15.76302,-4.8762],[15.8947,-4.42816],[15.8947,-4.42816],[16.29396,-4.53939],[16.75345,-4.59277],[17.22884,-4.58573],[17.71419,-4.53624],[18.20696,-4.45003],[18.70535,-4.33011],[18.75608,-4.10479],[18.8041,-3.87888],[18.8494,-3.6524],[18.44287,-3.34013],[18.02777,-3.06095],[17.60451,-2.81833],[17.17308,-2.61854],[16.73161,-2.48041],[16.32162,-2.41963],[16.38356,-1.95677],[16.43238,-1.49233],[16.46803,-1.0267]]);}}}translate([54,0,33.3]){cylinder(h=4.5,d1=32.8,d2=32.8,$fn=64);}}intersection(){translate([54,0,32.2]){cylinder(h=5.6,d1=30.8,d2=30.8,$fn=64);}translate([14,-10.7,31]){cube([80,80,12]);}}}union(){translate([54,0,32]){cylinder(h=12,d1=12.4,d2=12.4,$fn=64);}translate([48.3,2.3,32]){cube([11.4,10.4,12]);}}}translate([44,-1,33]){cylinder(h=9,d1=3.4,d2=3.4,$fn=64);}}translate([44,-1,40.2]){rotate([180,0,0]){translate([0,0,0]){cylinder(h=1.5,d1=6.4,d2=3.4,$fn=64);}}}}translate([64,-1,33]){cylinder(h=9,d1=3.4,d2=3.4,$fn=64);}}translate([64,-1,40.2]){rotate([180,0,0]){translate([0,0,0]){cylinder(h=1.5,d1=6.4,d2=3.4,$fn=64);}}}}multmatrix([[1,0,0,54],[0,1,0,-10.5],[0,0,1,40],[0,0,0,1]]){union(){union(){union(){union(){union(){union(){union(){union(){union(){union(){union(){union(){union(){union(){union(){union(){union(){union(){union(){union(){union(){union(){union(){union(){union(){union(){union(){union(){union(){union(){union(){union(){union(){union(){union(){union(){union(){union(){union(){union(){translate([-3.765,0.735,-0.3]){cube([0.53,0.53,0.42]);}translate([-3.265,0.735,-0.3]){cube([0.53,0.53,0.42]);}}translate([-3.765,0.235,-0.3]){cube([0.53,0.53,0.42]);}}translate([-2.765,0.235,-0.3]){cube([0.53,0.53,0.42]);}}translate([-3.765,-0.265,-0.3]){cube([0.53,0.53,0.42]);}}translate([-3.265,-0.265,-0.3]){cube([0.53,0.53,0.42]);}}translate([-3.765,-0.765,-0.3]){cube([0.53,0.53,0.42]);}}translate([-3.765,-1.265,-0.3]){cube([0.53,0.53,0.42]);}}translate([-1.765,0.735,-0.3]){cube([0.53,0.53,0.42]);}}translate([-1.265,0.735,-0.3]){cube([0.53,0.53,0.42]);}}translate([-0.765,0.735,-0.3]){cube([0.53,0.53,0.42]);}}translate([-1.765,0.235,-0.3]){cube([0.53,0.53,0.42]);}}translate([-0.765,0.235,-0.3]){cube([0.53,0.53,0.42]);}}translate([-1.765,-0.265,-0.3]){cube([0.53,0.53,0.42]);}}translate([-0.765,-0.265,-0.3]){cube([0.53,0.53,0.42]);}}translate([-1.765,-0.765,-0.3]){cube([0.53,0.53,0.42]);}}translate([-0.765,-0.765,-0.3]){cube([0.53,0.53,0.42]);}}translate([-1.765,-1.265,-0.3]){cube([0.53,0.53,0.42]);}}translate([-1.265,-1.265,-0.3]){cube([0.53,0.53,0.42]);}}translate([-0.765,-1.265,-0.3]){cube([0.53,0.53,0.42]);}}translate([0.235,0.735,-0.3]){cube([0.53,0.53,0.42]);}}translate([0.735,0.735,-0.3]){cube([0.53,0.53,0.42]);}}translate([1.235,0.735,-0.3]){cube([0.53,0.53,0.42]);}}translate([0.235,0.235,-0.3]){cube([0.53,0.53,0.42]);}}translate([0.235,-0.265,-0.3]){cube([0.53,0.53,0.42]);}}translate([0.735,-0.265,-0.3]){cube([0.53,0.53,0.42]);}}translate([1.235,-0.265,-0.3]){cube([0.53,0.53,0.42]);}}translate([1.235,-0.765,-0.3]){cube([0.53,0.53,0.42]);}}translate([0.235,-1.265,-0.3]){cube([0.53,0.53,0.42]);}}translate([0.735,-1.265,-0.3]){cube([0.53,0.53,0.42]);}}translate([1.235,-1.265,-0.3]){cube([0.53,0.53,0.42]);}}translate([2.735,0.735,-0.3]){cube([0.53,0.53,0.42]);}}translate([2.235,0.235,-0.3]){cube([0.53,0.53,0.42]);}}translate([3.235,0.235,-0.3]){cube([0.53,0.53,0.42]);}}translate([2.235,-0.265,-0.3]){cube([0.53,0.53,0.42]);}}translate([2.735,-0.265,-0.3]){cube([0.53,0.53,0.42]);}}translate([3.235,-0.265,-0.3]){cube([0.53,0.53,0.42]);}}translate([2.235,-0.765,-0.3]){cube([0.53,0.53,0.42]);}}translate([3.235,-0.765,-0.3]){cube([0.53,0.53,0.42]);}}translate([2.235,-1.265,-0.3]){cube([0.53,0.53,0.42]);}}translate([3.235,-1.265,-0.3]){cube([0.53,0.53,0.42]);}}}}}}
