shihkefa/esp32c3-card-dealer/V1.0.0/3d/OpenSCAD/P05B.scad

// 平面貼床式閉合D軸夾座
$fn=64;
translate([-38.8,40,10.5]){rotate([90,0,0]){difference(){difference(){difference(){difference(){difference(){difference(){difference(){difference(){difference(){difference(){difference(){difference(){difference(){difference(){difference(){difference(){difference(){union(){union(){translate([54,0,30.5]){cylinder(h=9.5,d1=12,d2=12,$fn=64);}translate([48.5,2.5,30.5]){cube([11,10,9.5]);}}translate([54,0,33.2]){cylinder(h=4.6,d1=30.4,d2=30.4,$fn=64);}}difference(){translate([29,-25,30.2]){cube([50,50,3]);}translate([54,0,30.1]){cylinder(h=3.2,d1=23.6,d2=23.6,$fn=64);}}}difference(){difference(){translate([54,0,29]){cylinder(h=15,d1=5.2,d2=5.2,$fn=64);}translate([50,1.65,28]){cube([8,5,17]);}}translate([50,-6.65,28]){cube([8,5,17]);}}}translate([53.7,0.5,30.4]){cube([0.6,18,11]);}}translate([47,7.5,35.4]){rotate([0,90,0]){translate([0,0,0]){cylinder(h=35,d1=3.4,d2=3.4,$fn=64);}}}}translate([57.8,7.5,35.4]){rotate([0,-90,0]){translate([0,0,0]){cylinder(h=1.5,d1=6.4,d2=3.4,$fn=64);}}}}translate([57.8,7.5,35.4]){rotate([0,90,0]){translate([0,0,0]){cylinder(h=23,d1=7.2,d2=7.2,$fn=64);}}}}intersection(){union(){translate([49.55,7.5,35.4]){rotate([0,90,0]){rotate([0,0,30]){translate([0,0,0]){cylinder(h=2.9,d1=6.7,d2=6.7,$fn=6);}}}}translate([49.55,7.5,32.5]){cube([2.9,18,5.8]);}}translate([49,-3,32.5]){cube([4,30,7]);}}}translate([44,-1,33.1]){cylinder(h=6,d1=3.6,d2=3.6,$fn=64);}}translate([44,-1,34]){cylinder(h=2.6,d1=6.7,d2=6.7,$fn=6);}}translate([32,-4,34]){cube([12,6,2.6]);}}translate([64,-1,33.1]){cylinder(h=6,d1=3.6,d2=3.6,$fn=64);}}translate([64,-1,34]){cylinder(h=2.6,d1=6.7,d2=6.7,$fn=6);}}translate([64,-4,34]){cube([12,6,2.6]);}}translate([14,-50.5,20]){cube([80,40,30]);}}multmatrix([[0,0,1,34],[1,0,0,0],[0,1,0,0],[0,0,0,1]]){translate([0,0,0]){linear_extrude(height=40)polygon([[-20,30.4],[-3.2,30.4],[-5.98,33.18],[-20,33.18]]);}}}multmatrix([[0,0,1,34],[1,0,0,0],[0,1,0,0],[0,0,0,1]]){translate([0,0,0]){linear_extrude(height=40)polygon([[-20,37.82],[-5.98,37.82],[-3.7,40.1],[-20,40.1]]);}}}multmatrix([[1,0,0,54],[0,0,-1,-10.5],[0,1,0,35.5],[0,0,0,1]]){union(){union(){union(){union(){union(){union(){union(){union(){union(){union(){union(){union(){union(){union(){union(){union(){union(){union(){union(){union(){union(){union(){union(){union(){union(){union(){union(){union(){union(){union(){union(){union(){union(){union(){union(){union(){union(){union(){union(){union(){translate([-3.615,0.705,-0.25]){cube([0.51,0.51,0.37]);}translate([-3.135,0.705,-0.25]){cube([0.51,0.51,0.37]);}}translate([-3.615,0.225,-0.25]){cube([0.51,0.51,0.37]);}}translate([-2.655,0.225,-0.25]){cube([0.51,0.51,0.37]);}}translate([-3.615,-0.255,-0.25]){cube([0.51,0.51,0.37]);}}translate([-3.135,-0.255,-0.25]){cube([0.51,0.51,0.37]);}}translate([-3.615,-0.735,-0.25]){cube([0.51,0.51,0.37]);}}translate([-3.615,-1.215,-0.25]){cube([0.51,0.51,0.37]);}}translate([-1.695,0.705,-0.25]){cube([0.51,0.51,0.37]);}}translate([-1.215,0.705,-0.25]){cube([0.51,0.51,0.37]);}}translate([-0.735,0.705,-0.25]){cube([0.51,0.51,0.37]);}}translate([-1.695,0.225,-0.25]){cube([0.51,0.51,0.37]);}}translate([-0.735,0.225,-0.25]){cube([0.51,0.51,0.37]);}}translate([-1.695,-0.255,-0.25]){cube([0.51,0.51,0.37]);}}translate([-0.735,-0.255,-0.25]){cube([0.51,0.51,0.37]);}}translate([-1.695,-0.735,-0.25]){cube([0.51,0.51,0.37]);}}translate([-0.735,-0.735,-0.25]){cube([0.51,0.51,0.37]);}}translate([-1.695,-1.215,-0.25]){cube([0.51,0.51,0.37]);}}translate([-1.215,-1.215,-0.25]){cube([0.51,0.51,0.37]);}}translate([-0.735,-1.215,-0.25]){cube([0.51,0.51,0.37]);}}translate([0.225,0.705,-0.25]){cube([0.51,0.51,0.37]);}}translate([0.705,0.705,-0.25]){cube([0.51,0.51,0.37]);}}translate([1.185,0.705,-0.25]){cube([0.51,0.51,0.37]);}}translate([0.225,0.225,-0.25]){cube([0.51,0.51,0.37]);}}translate([0.225,-0.255,-0.25]){cube([0.51,0.51,0.37]);}}translate([0.705,-0.255,-0.25]){cube([0.51,0.51,0.37]);}}translate([1.185,-0.255,-0.25]){cube([0.51,0.51,0.37]);}}translate([1.185,-0.735,-0.25]){cube([0.51,0.51,0.37]);}}translate([0.225,-1.215,-0.25]){cube([0.51,0.51,0.37]);}}translate([0.705,-1.215,-0.25]){cube([0.51,0.51,0.37]);}}translate([1.185,-1.215,-0.25]){cube([0.51,0.51,0.37]);}}translate([2.145,0.705,-0.25]){cube([0.51,0.51,0.37]);}}translate([2.625,0.705,-0.25]){cube([0.51,0.51,0.37]);}}translate([2.145,0.225,-0.25]){cube([0.51,0.51,0.37]);}}translate([3.105,0.225,-0.25]){cube([0.51,0.51,0.37]);}}translate([2.145,-0.255,-0.25]){cube([0.51,0.51,0.37]);}}translate([2.625,-0.255,-0.25]){cube([0.51,0.51,0.37]);}}translate([2.145,-0.735,-0.25]){cube([0.51,0.51,0.37]);}}translate([3.105,-0.735,-0.25]){cube([0.51,0.51,0.37]);}}translate([2.145,-1.215,-0.25]){cube([0.51,0.51,0.37]);}}translate([2.625,-1.215,-0.25]){cube([0.51,0.51,0.37]);}}}}}}
