shihkefa/esp32c3-card-dealer/V1.0.0/3d/OpenSCAD/P10.scad

// 選配重力壓牌滑板
$fn=64;
translate([47.5,27.5,-97]){rotate([0,0,0]){difference(){difference(){difference(){translate([-22,0,0]){translate([0,0,97]){linear_extrude(height=3)polygon([[25.5,23.5],[25.42314,24.28036],[25.19552,25.03073],[24.82588,25.72228],[24.32843,26.32843],[23.72228,26.82588],[23.03073,27.19552],[22.28036,27.42314],[21.5,27.5],[-21.5,27.5],[-22.28036,27.42314],[-23.03073,27.19552],[-23.72228,26.82588],[-24.32843,26.32843],[-24.82588,25.72228],[-25.19552,25.03073],[-25.42314,24.28036],[-25.5,23.5],[-25.5,-23.5],[-25.42314,-24.28036],[-25.19552,-25.03073],[-24.82588,-25.72228],[-24.32843,-26.32843],[-23.72228,-26.82588],[-23.03073,-27.19552],[-22.28036,-27.42314],[-21.5,-27.5],[21.5,-27.5],[22.28036,-27.42314],[23.03073,-27.19552],[23.72228,-26.82588],[24.32843,-26.32843],[24.82588,-25.72228],[25.19552,-25.03073],[25.42314,-24.28036],[25.5,-23.5]]);}}translate([-22,0,0]){translate([0,0,98.6]){linear_extrude(height=1.5)polygon([[17.75,17.25],[17.70196,17.73773],[17.5597,18.20671],[17.32867,18.63893],[17.01777,19.01777],[16.63893,19.32867],[16.20671,19.5597],[15.73773,19.70196],[15.25,19.75],[-15.25,19.75],[-15.73773,19.70196],[-16.20671,19.5597],[-16.63893,19.32867],[-17.01777,19.01777],[-17.32867,18.63893],[-17.5597,18.20671],[-17.70196,17.73773],[-17.75,17.25],[-17.75,-17.25],[-17.70196,-17.73773],[-17.5597,-18.20671],[-17.32867,-18.63893],[-17.01777,-19.01777],[-16.63893,-19.32867],[-16.20671,-19.5597],[-15.73773,-19.70196],[-15.25,-19.75],[15.25,-19.75],[15.73773,-19.70196],[16.20671,-19.5597],[16.63893,-19.32867],[17.01777,-19.01777],[17.32867,-18.63893],[17.5597,-18.20671],[17.70196,-17.73773],[17.75,-17.25]]);}}}translate([-25,2,96.95]){cube([6,12,0.3]);}}multmatrix([[0,0,-1,-47.5],[-1,0,0,0],[0,1,0,98.5],[0,0,0,1]]){union(){union(){union(){union(){union(){union(){union(){union(){union(){union(){union(){union(){union(){union(){union(){union(){union(){union(){union(){union(){union(){union(){union(){union(){union(){union(){union(){translate([-2.215,0.585,-0.25]){cube([0.43,0.43,0.37]);}translate([-1.815,0.585,-0.25]){cube([0.43,0.43,0.37]);}}translate([-2.215,0.185,-0.25]){cube([0.43,0.43,0.37]);}}translate([-1.415,0.185,-0.25]){cube([0.43,0.43,0.37]);}}translate([-2.215,-0.215,-0.25]){cube([0.43,0.43,0.37]);}}translate([-1.815,-0.215,-0.25]){cube([0.43,0.43,0.37]);}}translate([-2.215,-0.615,-0.25]){cube([0.43,0.43,0.37]);}}translate([-2.215,-1.015,-0.25]){cube([0.43,0.43,0.37]);}}translate([-0.215,0.585,-0.25]){cube([0.43,0.43,0.37]);}}translate([-0.615,0.185,-0.25]){cube([0.43,0.43,0.37]);}}translate([-0.215,0.185,-0.25]){cube([0.43,0.43,0.37]);}}translate([-0.215,-0.215,-0.25]){cube([0.43,0.43,0.37]);}}translate([-0.215,-0.615,-0.25]){cube([0.43,0.43,0.37]);}}translate([-0.615,-1.015,-0.25]){cube([0.43,0.43,0.37]);}}translate([-0.215,-1.015,-0.25]){cube([0.43,0.43,0.37]);}}translate([0.185,-1.015,-0.25]){cube([0.43,0.43,0.37]);}}translate([0.985,0.585,-0.25]){cube([0.43,0.43,0.37]);}}translate([1.385,0.585,-0.25]){cube([0.43,0.43,0.37]);}}translate([1.785,0.585,-0.25]){cube([0.43,0.43,0.37]);}}translate([0.985,0.185,-0.25]){cube([0.43,0.43,0.37]);}}translate([1.785,0.185,-0.25]){cube([0.43,0.43,0.37]);}}translate([0.985,-0.215,-0.25]){cube([0.43,0.43,0.37]);}}translate([1.785,-0.215,-0.25]){cube([0.43,0.43,0.37]);}}translate([0.985,-0.615,-0.25]){cube([0.43,0.43,0.37]);}}translate([1.785,-0.615,-0.25]){cube([0.43,0.43,0.37]);}}translate([0.985,-1.015,-0.25]){cube([0.43,0.43,0.37]);}}translate([1.385,-1.015,-0.25]){cube([0.43,0.43,0.37]);}}translate([1.785,-1.015,-0.25]){cube([0.43,0.43,0.37]);}}}}}}
