shihkefa/esp32c3-card-dealer/V1.0.0/3d/OpenSCAD/P13.scad

// 左出牌滾輪座
$fn=64;
translate([-48.5,41,-45.4]){rotate([0,0,0]){difference(){difference(){difference(){difference(){union(){difference(){difference(){difference(){union(){difference(){difference(){difference(){difference(){difference(){union(){union(){union(){union(){translate([61,-35,0]){translate([0,0,45.4]){linear_extrude(height=4)polygon([[12.5,3],[12.44236,3.58527],[12.27164,4.14805],[11.99441,4.66671],[11.62132,5.12132],[11.16671,5.49441],[10.64805,5.77164],[10.08527,5.94236],[9.5,6],[-9.5,6],[-10.08527,5.94236],[-10.64805,5.77164],[-11.16671,5.49441],[-11.62132,5.12132],[-11.99441,4.66671],[-12.27164,4.14805],[-12.44236,3.58527],[-12.5,3],[-12.5,-3],[-12.44236,-3.58527],[-12.27164,-4.14805],[-11.99441,-4.66671],[-11.62132,-5.12132],[-11.16671,-5.49441],[-10.64805,-5.77164],[-10.08527,-5.94236],[-9.5,-6],[9.5,-6],[10.08527,-5.94236],[10.64805,-5.77164],[11.16671,-5.49441],[11.62132,-5.12132],[11.99441,-4.66671],[12.27164,-4.14805],[12.44236,-3.58527],[12.5,-3]]);}}translate([51,-38.5,49.3]){cube([20,7,19]);}}translate([51,-38.5,67]){cube([3,7,19]);}}translate([68,-38.5,67]){cube([3,7,19]);}}translate([51,-38.5,83]){cube([20,7,4]);}}translate([61,-42.5,54.2]){rotate([-90,0,0]){translate([0,0,0]){cylinder(h=15,d1=3.5,d2=3.5,$fn=64);}}}}translate([61,-35.8,54.2]){rotate([-90,0,0]){translate([0,0,0]){cylinder(h=7.5,d1=10.3,d2=10.3,$fn=64);}}}}translate([61,-35,81]){cylinder(h=9,d1=2.7,d2=2.7,$fn=64);}}translate([61,-35,87.1]){rotate([180,0,0]){translate([0,0,0]){cylinder(h=0.6,d1=3.8,d2=2.7,$fn=64);}}}}translate([63,-35,60]){rotate([0,90,0]){translate([0,0,0]){cylinder(h=9,d1=2.7,d2=2.7,$fn=64);}}}}translate([52.5,-35,49.3]){cylinder(h=2.1,d1=8,d2=8,$fn=64);}}translate([52.5,-35,44]){cylinder(h=10,d1=3.4,d2=3.4,$fn=64);}}translate([52.5,-35,45.3]){cylinder(h=0.9,d1=6.55,d2=6.55,$fn=6);}}translate([52.5,-35,51.5]){rotate([180,0,0]){translate([0,0,0]){cylinder(h=1.7,d1=6.4,d2=3.4,$fn=64);}}}}translate([69.5,-35,49.3]){cylinder(h=2.1,d1=8,d2=8,$fn=64);}}translate([69.5,-35,44]){cylinder(h=10,d1=3.4,d2=3.4,$fn=64);}}translate([69.5,-35,45.3]){cylinder(h=0.9,d1=6.55,d2=6.55,$fn=6);}}translate([69.5,-35,51.5]){rotate([180,0,0]){translate([0,0,0]){cylinder(h=1.7,d1=6.4,d2=3.4,$fn=64);}}}}multmatrix([[0,0,-1,51],[-1,0,0,-35],[0,1,0,64],[0,0,0,1]]){union(){union(){union(){union(){union(){union(){union(){union(){union(){union(){union(){union(){union(){union(){union(){union(){union(){union(){union(){union(){union(){union(){union(){union(){union(){union(){translate([-2.765,0.735,-0.3]){cube([0.53,0.53,0.42]);}translate([-2.265,0.735,-0.3]){cube([0.53,0.53,0.42]);}}translate([-2.765,0.235,-0.3]){cube([0.53,0.53,0.42]);}}translate([-1.765,0.235,-0.3]){cube([0.53,0.53,0.42]);}}translate([-2.765,-0.265,-0.3]){cube([0.53,0.53,0.42]);}}translate([-2.265,-0.265,-0.3]){cube([0.53,0.53,0.42]);}}translate([-2.765,-0.765,-0.3]){cube([0.53,0.53,0.42]);}}translate([-2.765,-1.265,-0.3]){cube([0.53,0.53,0.42]);}}translate([-0.265,0.735,-0.3]){cube([0.53,0.53,0.42]);}}translate([-0.765,0.235,-0.3]){cube([0.53,0.53,0.42]);}}translate([-0.265,0.235,-0.3]){cube([0.53,0.53,0.42]);}}translate([-0.265,-0.265,-0.3]){cube([0.53,0.53,0.42]);}}translate([-0.265,-0.765,-0.3]){cube([0.53,0.53,0.42]);}}translate([-0.765,-1.265,-0.3]){cube([0.53,0.53,0.42]);}}translate([-0.265,-1.265,-0.3]){cube([0.53,0.53,0.42]);}}translate([0.235,-1.265,-0.3]){cube([0.53,0.53,0.42]);}}translate([1.235,0.735,-0.3]){cube([0.53,0.53,0.42]);}}translate([1.735,0.735,-0.3]){cube([0.53,0.53,0.42]);}}translate([2.235,0.735,-0.3]){cube([0.53,0.53,0.42]);}}translate([2.235,0.235,-0.3]){cube([0.53,0.53,0.42]);}}translate([1.235,-0.265,-0.3]){cube([0.53,0.53,0.42]);}}translate([1.735,-0.265,-0.3]){cube([0.53,0.53,0.42]);}}translate([2.235,-0.265,-0.3]){cube([0.53,0.53,0.42]);}}translate([2.235,-0.765,-0.3]){cube([0.53,0.53,0.42]);}}translate([1.235,-1.265,-0.3]){cube([0.53,0.53,0.42]);}}translate([1.735,-1.265,-0.3]){cube([0.53,0.53,0.42]);}}translate([2.235,-1.265,-0.3]){cube([0.53,0.53,0.42]);}}}}}}
