shihkefa/esp32c3-card-dealer/V1.0.0/3d/OpenSCAD/P17.scad

// 取牌輪輪芯
$fn=64;
translate([31.5,63.5,-3]){rotate([90,0,0]){difference(){difference(){difference(){difference(){difference(){difference(){difference(){union(){translate([-22,3,54]){rotate([-90,0,0]){difference(){difference(){difference(){translate([0,0,0]){cylinder(h=10,d1=18.4,d2=18.4,$fn=64);}difference(){translate([0,0,0.85]){cylinder(h=2.3,d1=22,d2=22,$fn=64);}translate([0,0,0.7]){cylinder(h=2.6,d1=16.8,d2=16.8,$fn=64);}}}difference(){translate([0,0,6.85]){cylinder(h=2.3,d1=22,d2=22,$fn=64);}translate([0,0,6.7]){cylinder(h=2.6,d1=16.8,d2=16.8,$fn=64);}}}translate([0,0,-1]){cylinder(h=12,d1=3.15,d2=3.15,$fn=64);}}}}translate([-22,6.2,54]){rotate([-90,0,0]){translate([0,0,0]){cylinder(h=3.6,d1=19,d2=19,$fn=64);}}}}translate([-22,2.8,54]){rotate([-90,0,0]){translate([0,0,0]){cylinder(h=10.4,d1=3.15,d2=3.15,$fn=64);}}}}translate([-20.8,2.9,53.7]){cube([13,10.2,0.6]);}}translate([-17,8,44]){cylinder(h=21,d1=3.4,d2=3.4,$fn=64);}}translate([-17,8,57.3]){rotate([180,0,0]){translate([0,0,0]){cylinder(h=1.7,d1=6.4,d2=3.4,$fn=64);}}}}translate([-17,8,57.2]){cylinder(h=8,d1=6.4,d2=6.4,$fn=64);}}translate([-17,8,44]){cylinder(h=8,d1=6.55,d2=6.55,$fn=6);}}multmatrix([[1,0,0,-22],[0,0,-1,3],[0,1,0,59.5],[0,0,0,1]]){union(){union(){union(){union(){union(){union(){union(){union(){union(){union(){union(){union(){union(){union(){union(){union(){union(){union(){union(){union(){union(){union(){translate([-2.765,0.735,-0.25]){cube([0.53,0.53,0.37]);}translate([-2.265,0.735,-0.25]){cube([0.53,0.53,0.37]);}}translate([-2.765,0.235,-0.25]){cube([0.53,0.53,0.37]);}}translate([-1.765,0.235,-0.25]){cube([0.53,0.53,0.37]);}}translate([-2.765,-0.265,-0.25]){cube([0.53,0.53,0.37]);}}translate([-2.265,-0.265,-0.25]){cube([0.53,0.53,0.37]);}}translate([-2.765,-0.765,-0.25]){cube([0.53,0.53,0.37]);}}translate([-2.765,-1.265,-0.25]){cube([0.53,0.53,0.37]);}}translate([-0.265,0.735,-0.25]){cube([0.53,0.53,0.37]);}}translate([-0.765,0.235,-0.25]){cube([0.53,0.53,0.37]);}}translate([-0.265,0.235,-0.25]){cube([0.53,0.53,0.37]);}}translate([-0.265,-0.265,-0.25]){cube([0.53,0.53,0.37]);}}translate([-0.265,-0.765,-0.25]){cube([0.53,0.53,0.37]);}}translate([-0.765,-1.265,-0.25]){cube([0.53,0.53,0.37]);}}translate([-0.265,-1.265,-0.25]){cube([0.53,0.53,0.37]);}}translate([0.235,-1.265,-0.25]){cube([0.53,0.53,0.37]);}}translate([1.235,0.735,-0.25]){cube([0.53,0.53,0.37]);}}translate([1.735,0.735,-0.25]){cube([0.53,0.53,0.37]);}}translate([2.235,0.735,-0.25]){cube([0.53,0.53,0.37]);}}translate([2.235,0.235,-0.25]){cube([0.53,0.53,0.37]);}}translate([1.735,-0.265,-0.25]){cube([0.53,0.53,0.37]);}}translate([1.735,-0.765,-0.25]){cube([0.53,0.53,0.37]);}}translate([1.735,-1.265,-0.25]){cube([0.53,0.53,0.37]);}}}}}}
