shihkefa/esp32c3-card-dealer/V1.0.0/3d/OpenSCAD/P20.scad

// RF300出牌馬達底座
$fn=64;
translate([-43,86.8,-45.4]){rotate([0,0,0]){difference(){translate([0,-14.3,0]){difference(){difference(){difference(){difference(){difference(){union(){union(){translate([61,-59,0]){translate([0,0,45.4]){linear_extrude(height=3)polygon([[18,9.5],[17.92314,10.28036],[17.69552,11.03073],[17.32588,11.72228],[16.82843,12.32843],[16.22228,12.82588],[15.53073,13.19552],[14.78036,13.42314],[14,13.5],[-14,13.5],[-14.78036,13.42314],[-15.53073,13.19552],[-16.22228,12.82588],[-16.82843,12.32843],[-17.32588,11.72228],[-17.69552,11.03073],[-17.92314,10.28036],[-18,9.5],[-18,-9.5],[-17.92314,-10.28036],[-17.69552,-11.03073],[-17.32588,-11.72228],[-16.82843,-12.32843],[-16.22228,-12.82588],[-15.53073,-13.19552],[-14.78036,-13.42314],[-14,-13.5],[14,-13.5],[14.78036,-13.42314],[15.53073,-13.19552],[16.22228,-12.82588],[16.82843,-12.32843],[17.32588,-11.72228],[17.69552,-11.03073],[17.92314,-10.28036],[18,-9.5]]);}}translate([43.5,-72,48.3]){cube([6,24,16.9]);}}translate([72.5,-72,48.3]){cube([6,24,16.9]);}}translate([61,-72,54.2]){rotate([-90,0,0]){translate([0,0,0]){cylinder(h=24,d1=24.8,d2=24.8,$fn=64);}}}}translate([46.5,-60,43]){cylinder(h=27,d1=3.4,d2=3.4,$fn=64);}}translate([46.5,-60,43.4]){cylinder(h=2.6,d1=6.55,d2=6.55,$fn=6);}}translate([75.5,-60,43]){cylinder(h=27,d1=3.4,d2=3.4,$fn=64);}}translate([75.5,-60,43.4]){cylinder(h=2.6,d1=6.55,d2=6.55,$fn=6);}}}multmatrix([[1,0,0,46.5],[0,-1,0,-68],[0,0,-1,45.4],[0,0,0,1]]){union(){union(){union(){union(){union(){union(){union(){union(){union(){union(){union(){union(){union(){union(){union(){union(){union(){union(){union(){union(){union(){union(){union(){union(){union(){union(){union(){union(){union(){union(){translate([-2.765,0.735,-0.25]){cube([0.53,0.53,0.37]);}translate([-2.265,0.735,-0.25]){cube([0.53,0.53,0.37]);}}translate([-2.765,0.235,-0.25]){cube([0.53,0.53,0.37]);}}translate([-1.765,0.235,-0.25]){cube([0.53,0.53,0.37]);}}translate([-2.765,-0.265,-0.25]){cube([0.53,0.53,0.37]);}}translate([-2.265,-0.265,-0.25]){cube([0.53,0.53,0.37]);}}translate([-2.765,-0.765,-0.25]){cube([0.53,0.53,0.37]);}}translate([-2.765,-1.265,-0.25]){cube([0.53,0.53,0.37]);}}translate([-0.765,0.735,-0.25]){cube([0.53,0.53,0.37]);}}translate([-0.265,0.735,-0.25]){cube([0.53,0.53,0.37]);}}translate([0.235,0.735,-0.25]){cube([0.53,0.53,0.37]);}}translate([0.235,0.235,-0.25]){cube([0.53,0.53,0.37]);}}translate([-0.765,-0.265,-0.25]){cube([0.53,0.53,0.37]);}}translate([-0.265,-0.265,-0.25]){cube([0.53,0.53,0.37]);}}translate([0.235,-0.265,-0.25]){cube([0.53,0.53,0.37]);}}translate([-0.765,-0.765,-0.25]){cube([0.53,0.53,0.37]);}}translate([-0.765,-1.265,-0.25]){cube([0.53,0.53,0.37]);}}translate([-0.265,-1.265,-0.25]){cube([0.53,0.53,0.37]);}}translate([0.235,-1.265,-0.25]){cube([0.53,0.53,0.37]);}}translate([1.235,0.735,-0.25]){cube([0.53,0.53,0.37]);}}translate([1.735,0.735,-0.25]){cube([0.53,0.53,0.37]);}}translate([2.235,0.735,-0.25]){cube([0.53,0.53,0.37]);}}translate([1.235,0.235,-0.25]){cube([0.53,0.53,0.37]);}}translate([2.235,0.235,-0.25]){cube([0.53,0.53,0.37]);}}translate([1.235,-0.265,-0.25]){cube([0.53,0.53,0.37]);}}translate([2.235,-0.265,-0.25]){cube([0.53,0.53,0.37]);}}translate([1.235,-0.765,-0.25]){cube([0.53,0.53,0.37]);}}translate([2.235,-0.765,-0.25]){cube([0.53,0.53,0.37]);}}translate([1.235,-1.265,-0.25]){cube([0.53,0.53,0.37]);}}translate([1.735,-1.265,-0.25]){cube([0.53,0.53,0.37]);}}translate([2.235,-1.265,-0.25]){cube([0.53,0.53,0.37]);}}}}}}
