shihkefa/esp32c3-card-dealer/V1.0.0/3d/OpenSCAD/P24.scad

// 出口光電感測器可調座
$fn=64;
translate([-76.5,-19.5,-55.1]){rotate([0,0,0]){difference(){difference(){difference(){difference(){difference(){difference(){difference(){difference(){union(){union(){union(){difference(){translate([9,0,0]){difference(){difference(){union(){union(){translate([77,27,0]){translate([0,0,57.5]){linear_extrude(height=3)polygon([[9.5,3.5],[9.46157,3.89018],[9.34776,4.26537],[9.16294,4.61114],[8.91421,4.91421],[8.61114,5.16294],[8.26537,5.34776],[7.89018,5.46157],[7.5,5.5],[-7.5,5.5],[-7.89018,5.46157],[-8.26537,5.34776],[-8.61114,5.16294],[-8.91421,4.91421],[-9.16294,4.61114],[-9.34776,4.26537],[-9.46157,3.89018],[-9.5,3.5],[-9.5,-3.5],[-9.46157,-3.89018],[-9.34776,-4.26537],[-9.16294,-4.61114],[-8.91421,-4.91421],[-8.61114,-5.16294],[-8.26537,-5.34776],[-7.89018,-5.46157],[-7.5,-5.5],[7.5,-5.5],[7.89018,-5.46157],[8.26537,-5.34776],[8.61114,-5.16294],[8.91421,-4.91421],[9.16294,-4.61114],[9.34776,-4.26537],[9.46157,-3.89018],[9.5,-3.5]]);}}translate([71.5,19.5,60]){cube([15,3,3.7]);}}translate([68,22.5,59.2]){cube([8,9,1.5]);}}translate([72,27,0]){translate([0,0,56]){linear_extrude(height=6)polygon([[1.75,2.26],[1.71657,2.59946],[1.61755,2.92587],[1.45676,3.22669],[1.24037,3.49037],[0.97669,3.70676],[0.67587,3.86755],[0.34946,3.96657],[0.01,4],[-0.01,4],[-0.34946,3.96657],[-0.67587,3.86755],[-0.97669,3.70676],[-1.24037,3.49037],[-1.45676,3.22669],[-1.61755,2.92587],[-1.71657,2.59946],[-1.75,2.26],[-1.75,-2.26],[-1.71657,-2.59946],[-1.61755,-2.92587],[-1.45676,-3.22669],[-1.24037,-3.49037],[-0.97669,-3.70676],[-0.67587,-3.86755],[-0.34946,-3.96657],[-0.01,-4],[0.01,-4],[0.34946,-3.96657],[0.67587,-3.86755],[0.97669,-3.70676],[1.24037,-3.49037],[1.45676,-3.22669],[1.61755,-2.92587],[1.71657,-2.59946],[1.75,-2.26]]);}}}translate([81,27,0]){translate([0,0,56]){linear_extrude(height=6)polygon([[1.75,2.26],[1.71657,2.59946],[1.61755,2.92587],[1.45676,3.22669],[1.24037,3.49037],[0.97669,3.70676],[0.67587,3.86755],[0.34946,3.96657],[0.01,4],[-0.01,4],[-0.34946,3.96657],[-0.67587,3.86755],[-0.97669,3.70676],[-1.24037,3.49037],[-1.45676,3.22669],[-1.61755,2.92587],[-1.71657,2.59946],[-1.75,2.26],[-1.75,-2.26],[-1.71657,-2.59946],[-1.61755,-2.92587],[-1.45676,-3.22669],[-1.24037,-3.49037],[-0.97669,-3.70676],[-0.67587,-3.86755],[-0.34946,-3.96657],[-0.01,-4],[0.01,-4],[0.34946,-3.96657],[0.67587,-3.86755],[0.97669,-3.70676],[1.24037,-3.49037],[1.45676,-3.22669],[1.61755,-2.92587],[1.71657,-2.59946],[1.75,-2.26]]);}}}}translate([87,26.5,57.5]){cube([8,8,15]);}}translate([85,33,55.1]){cube([12,3,18.4]);}}translate([83.5,28,55.1]){cube([3,6,5.4]);}}translate([83,31,55.1]){cube([15,5,2.2]);}}translate([89.73,30,59.3]){rotate([-90,0,0]){translate([0,0,0]){cylinder(h=10,d1=1.2,d2=1.2,$fn=64);}}}}translate([89.73,30,69.3]){rotate([-90,0,0]){translate([0,0,0]){cylinder(h=10,d1=1.2,d2=1.2,$fn=64);}}}}translate([92.27,30,59.3]){rotate([-90,0,0]){translate([0,0,0]){cylinder(h=10,d1=1.2,d2=1.2,$fn=64);}}}}translate([92.27,30,69.3]){rotate([-90,0,0]){translate([0,0,0]){cylinder(h=10,d1=1.2,d2=1.2,$fn=64);}}}}translate([86.8,29.5,62.55]){cube([1.4,10,3.5]);}}translate([93.8,29.5,62.55]){cube([1.4,10,3.5]);}}translate([77.5,21,54.4]){cube([7,12,4]);}}multmatrix([[-1,0,0,91],[0,0,1,36],[0,1,0,64.3],[0,0,0,1]]){union(){union(){union(){union(){union(){union(){union(){union(){union(){union(){union(){union(){union(){union(){union(){union(){union(){union(){union(){union(){union(){union(){union(){union(){union(){union(){union(){translate([-2.435,0.645,-0.25]){cube([0.47,0.47,0.37]);}translate([-1.995,0.645,-0.25]){cube([0.47,0.47,0.37]);}}translate([-2.435,0.205,-0.25]){cube([0.47,0.47,0.37]);}}translate([-1.555,0.205,-0.25]){cube([0.47,0.47,0.37]);}}translate([-2.435,-0.235,-0.25]){cube([0.47,0.47,0.37]);}}translate([-1.995,-0.235,-0.25]){cube([0.47,0.47,0.37]);}}translate([-2.435,-0.675,-0.25]){cube([0.47,0.47,0.37]);}}translate([-2.435,-1.115,-0.25]){cube([0.47,0.47,0.37]);}}translate([-0.675,0.645,-0.25]){cube([0.47,0.47,0.37]);}}translate([-0.235,0.645,-0.25]){cube([0.47,0.47,0.37]);}}translate([0.205,0.645,-0.25]){cube([0.47,0.47,0.37]);}}translate([0.205,0.205,-0.25]){cube([0.47,0.47,0.37]);}}translate([-0.675,-0.235,-0.25]){cube([0.47,0.47,0.37]);}}translate([-0.235,-0.235,-0.25]){cube([0.47,0.47,0.37]);}}translate([0.205,-0.235,-0.25]){cube([0.47,0.47,0.37]);}}translate([-0.675,-0.675,-0.25]){cube([0.47,0.47,0.37]);}}translate([-0.675,-1.115,-0.25]){cube([0.47,0.47,0.37]);}}translate([-0.235,-1.115,-0.25]){cube([0.47,0.47,0.37]);}}translate([0.205,-1.115,-0.25]){cube([0.47,0.47,0.37]);}}translate([1.085,0.645,-0.25]){cube([0.47,0.47,0.37]);}}translate([1.965,0.645,-0.25]){cube([0.47,0.47,0.37]);}}translate([1.085,0.205,-0.25]){cube([0.47,0.47,0.37]);}}translate([1.965,0.205,-0.25]){cube([0.47,0.47,0.37]);}}translate([1.085,-0.235,-0.25]){cube([0.47,0.47,0.37]);}}translate([1.525,-0.235,-0.25]){cube([0.47,0.47,0.37]);}}translate([1.965,-0.235,-0.25]){cube([0.47,0.47,0.37]);}}translate([1.965,-0.675,-0.25]){cube([0.47,0.47,0.37]);}}translate([1.965,-1.115,-0.25]){cube([0.47,0.47,0.37]);}}}}}}
