shihkefa/esp32c3-card-dealer/V1.0.0/3d/OpenSCAD/P27.scad

// 頂按式按鍵帽
$fn=64;
translate([-70.5,8.5,131.3]){rotate([180,0,0]){difference(){difference(){union(){translate([75,4,129.3]){cylinder(h=2,d1=9,d2=9,$fn=64);}translate([75,4,124.95]){cylinder(h=4.85,d1=5.6,d2=5.6,$fn=64);}}translate([75,4,124.75]){cylinder(h=2.8,d1=3.2,d2=3.2,$fn=64);}}union(){union(){union(){union(){un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
