shihkefa/esp32c3-card-dealer/V1.0.0/3d/OpenSCAD/P33.scad

// 上罩側維修蓋
$fn=64;
translate([37,126.5,98.2]){rotate([90,0,0]){difference(){difference(){difference(){difference(){difference(){difference(){difference(){difference(){difference(){difference(){translate([0,-96,0]){rotate([90,0,0]){translate([20,80.5,0]){translate([0,0,0]){linear_extrude(height=2.2)polygon([[57,40],[56.88471,41.17054],[56.54328,42.2961],[55.98882,43.33342],[55.24264,44.24264],[54.33342,44.98882],[53.2961,45.54328],[52.17054,45.88471],[51,46],[-51,46],[-52.17054,45.88471],[-53.2961,45.54328],[-54.33342,44.98882],[-55.24264,44.24264],[-55.98882,43.33342],[-56.54328,42.2961],[-56.88471,41.17054],[-57,40],[-57,-40],[-56.88471,-41.17054],[-56.54328,-42.2961],[-55.98882,-43.33342],[-55.24264,-44.24264],[-54.33342,-44.98882],[-53.2961,-45.54328],[-52.17054,-45.88471],[-51,-46],[51,-46],[52.17054,-45.88471],[53.2961,-45.54328],[54.33342,-44.98882],[55.24264,-44.24264],[55.98882,-43.33342],[56.54328,-42.2961],[56.88471,-41.17054],[57,-40]]);}}}}translate([-32,-100,46.5]){rotate([-90,0,0]){translate([0,0,0]){cylinder(h=6,d1=3.4,d2=3.4,$fn=64);}}}}translate([-32,-98.3,46.5]){rotate([-90,0,0]){translate([0,0,0]){cylinder(h=1.4,d1=6.2,d2=3.4,$fn=64);}}}}translate([72,-100,46.5]){rotate([-90,0,0]){translate([0,0,0]){cylinder(h=6,d1=3.4,d2=3.4,$fn=64);}}}}translate([72,-98.3,46.5]){rotate([-90,0,0]){translate([0,0,0]){cylinder(h=1.4,d1=6.2,d2=3.4,$fn=64);}}}}translate([-32,-100,120]){rotate([-90,0,0]){translate([0,0,0]){cylinder(h=6,d1=3.4,d2=3.4,$fn=64);}}}}translate([-32,-98.3,120]){rotate([-90,0,0]){translate([0,0,0]){cylinder(h=1.4,d1=6.2,d2=3.4,$fn=64);}}}}translate([72,-100,120]){rotate([-90,0,0]){translate([0,0,0]){cylinder(h=6,d1=3.4,d2=3.4,$fn=64);}}}}translate([72,-98.3,120]){rotate([-90,0,0]){translate([0,0,0]){cylinder(h=1.4,d1=6.2,d2=3.4,$fn=64);}}}}translate([-250,-250,-100]){cube([500,500,143]);}}multmatrix([[-1,0,0,20],[0,0,1,-96],[0,1,0,80.5],[0,0,0,1]]){union(){union(){union(){union(){union(){union(){union(){union(){union(){union(){union(){union(){union(){union(){union(){union(){union(){union(){union(){union(){union(){union(){union(){union(){union(){union(){union(){union(){union(){translate([-4.415,1.185,-0.35]){cube([0.83,0.83,0.47]);}translate([-3.615,1.185,-0.35]){cube([0.83,0.83,0.47]);}}translate([-4.415,0.385,-0.35]){cube([0.83,0.83,0.47]);}}translate([-2.815,0.385,-0.35]){cube([0.83,0.83,0.47]);}}translate([-4.415,-0.415,-0.35]){cube([0.83,0.83,0.47]);}}translate([-3.615,-0.415,-0.35]){cube([0.83,0.83,0.47]);}}translate([-4.415,-1.215,-0.35]){cube([0.83,0.83,0.47]);}}translate([-4.415,-2.015,-0.35]){cube([0.83,0.83,0.47]);}}translate([-1.215,1.185,-0.35]){cube([0.83,0.83,0.47]);}}translate([-0.415,1.185,-0.35]){cube([0.83,0.83,0.47]);}}translate([0.385,1.185,-0.35]){cube([0.83,0.83,0.47]);}}translate([0.385,0.385,-0.35]){cube([0.83,0.83,0.47]);}}translate([-1.215,-0.415,-0.35]){cube([0.83,0.83,0.47]);}}translate([-0.415,-0.415,-0.35]){cube([0.83,0.83,0.47]);}}translate([0.385,-0.415,-0.35]){cube([0.83,0.83,0.47]);}}translate([0.385,-1.215,-0.35]){cube([0.83,0.83,0.47]);}}translate([-1.215,-2.015,-0.35]){cube([0.83,0.83,0.47]);}}translate([-0.415,-2.015,-0.35]){cube([0.83,0.83,0.47]);}}translate([0.385,-2.015,-0.35]){cube([0.83,0.83,0.47]);}}translate([1.985,1.185,-0.35]){cube([0.83,0.83,0.47]);}}translate([2.785,1.185,-0.35]){cube([0.83,0.83,0.47]);}}translate([3.585,1.185,-0.35]){cube([0.83,0.83,0.47]);}}translate([3.585,0.385,-0.35]){cube([0.83,0.83,0.47]);}}translate([1.985,-0.415,-0.35]){cube([0.83,0.83,0.47]);}}translate([2.785,-0.415,-0.35]){cube([0.83,0.83,0.47]);}}translate([3.585,-0.415,-0.35]){cube([0.83,0.83,0.47]);}}translate([3.585,-1.215,-0.35]){cube([0.83,0.83,0.47]);}}translate([1.985,-2.015,-0.35]){cube([0.83,0.83,0.47]);}}translate([2.785,-2.015,-0.35]){cube([0.83,0.83,0.47]);}}translate([3.585,-2.015,-0.35]){cube([0.83,0.83,0.47]);}}}}}}
