shihkefa/esp32c3-card-dealer/(list of files, cad)

Other CAD files:
V1.0.0/3d/STL/P13.stl
V1.0.0/3d/card_dealer.scad
V1.0.0/3d/OpenSCAD/P04B.scad
V1.0.0/3d/OpenSCAD/P06.scad
V1.0.0/3d/OpenSCAD/P08.scad
V1.0.0/3d/OpenSCAD/P11.scad
V1.0.0/3d/OpenSCAD/P12.scad
V1.0.0/3d/OpenSCAD/P14.scad
V1.0.0/3d/OpenSCAD/P15.scad
V1.0.0/3d/OpenSCAD/P16.scad
V1.0.0/3d/OpenSCAD/P18.scad
V1.0.0/3d/OpenSCAD/P19.scad
V1.0.0/3d/OpenSCAD/P21.scad
V1.0.0/3d/OpenSCAD/P22.scad
V1.0.0/3d/OpenSCAD/P23.scad
V1.0.0/3d/OpenSCAD/P25.scad
V1.0.0/3d/OpenSCAD/P26.scad
V1.0.0/3d/OpenSCAD/P28.scad
V1.0.0/3d/OpenSCAD/P29.scad
V1.0.0/3d/OpenSCAD/P30.scad
V1.0.0/3d/OpenSCAD/P32B.scad
V1.0.0/3d/OpenSCAD/P34.scad
V1.0.0/3d/OpenSCAD/P35.scad
V1.0.0/3d/OpenSCAD/P36.scad
