shihkefa/esp32c3-card-dealer/V1.0.0/source/manual/template.html

撲克牌發牌機V1.0.0

ASSEMBLY GUIDE / 組裝步驟說明書

YOUR BUILD PROGRESS

組裝進度0 / 22

進度僅儲存在目前瀏覽器。
清除完成記錄 關閉目錄

☰ 步驟目錄已完成 0 / 22

V1.0.0 組裝說明書

STEP 01

01 / 22

可互動 3D 組裝模型⛶ 放大 3D

3D 模型重點示意圖拖曳旋轉 · 滾輪縮放

此瀏覽器無法開啟 3D，已顯示重點示意圖；可繼續閱讀步驟。

本步重點配合件或外購件已裝結構

準備此步零件

此步新增或預放的五金

## 組裝操作

## 完成前確認

← 上一步

○ 標記本步完成下一步 →

本頁示意使用最新模型，爆炸間距僅供看清安裝位置；實際列印公差、夾持力與電氣性能需試配確認。

PARTS REFERENCE

# 零件索引

依零件上的凹刻編號找圖。基本組裝為 __COUNT_standardTypes__ 種、__COUNT_standardPrintQty__ 件；選配與試配片另外列出。每個條目可直接跳到相關組裝步驟。

__COUNT_printTypes__全部列印件種類

__COUNT_standardPrintQty__基本成品列印件

__COUNT_extraPrintQty__選配與試配片件數

HARDWARE AND TOOLS

# 五金與工具

全機只用兩種螺絲長度，以及一種標準 M3 螺母。下表來自目前模型的五金清單，按實際裝配位置分組。

__COUNT_shortScrews__M3 × 8 mm

__COUNT_longScrews__M3 × 25 mm

__COUNT_nuts__標準 M3 螺母

## 先分好五金

螺絲採 DIN7991 內六角沉頭，90° 頭型、頭徑不超過 6 mm、頭高不超過 1.7 mm；標示長度包含頭部。螺母對邊 5.5 mm、厚度 2.4 mm。建議備 M3×8 共 __COUNT_reserveShort__ 支、M3×25 共 __COUNT_reserveLong__ 支、螺母 __COUNT_reserveNuts__ 顆。

部分螺絲直接鎖入列印預孔，因此並非每一顆都有螺母。只在圖示的捕捉槽預放螺母，勿自行加厚螺母或硬鎖到塑膠變形。

安裝位置 | M3×8 | M3×25 | M3 螺母 | 步驟
全機合計 | __COUNT_shortScrews__ | __COUNT_longScrews__ | __COUNT_nuts__

## 建議工具

- 2 mm 內六角扳手 P05B 需 L 型工具，短臂尖端至長臂中心距以 14 或 16 mm 參考；商品外側總長不能直接當中心距。
- 尖嘴鉗與鑷子 用來預放捕捉螺母及整理短導線。
- 游標卡尺與去毛刺工具 先確認馬達軸、軸承、板件尺寸，清掉螺母槽與孔內支撐。
- 電表與焊接工具 核對極性、滑環通斷、5.0 V 升壓輸出與焊點。

齒輪先乾式試裝。若後續加潤滑脂，先確認與列印材料相容，只薄塗嚙合齒面；牌道、橡膠圈、分牌墊及軸夾持面保持乾燥。

WIRING AND FIRST RUN

# 接線與首次測試

內嵌完整逐腳接線圖，可選線、縮放與拖曳。圖面以指定參考板型為準；模組焊孔排列不同時，先依接腳名稱核對實物。

開啟互動逐腳接線圖 ↗

18650、接線與焊接作業時先斷電。先量升壓輸出 5.0 V，再接 ESP 與馬達。

## 接線時先確認

1. 單節 18650 接 1S 保護板 B 端；充電板與負載接保護板 P 端，負載經開關再進升壓板。
2. OLED 與 PCF8574 使用 3.3 V；SDA 接 GPIO21，SCL 接 GPIO20。所有模組共地。
3. 滑環先逐路量通斷再接，不能只看線色。本版 12 路使用 10 路，餘 2 路備用。
4. 機殼 Type-C 接 TP4056，使用時關機充電。ESP 板上的 USB 是燒錄與診斷口。
5. 接電腦 USB 前先拔開 JP-ESP5V 分支，GND 保持共地；只關電池總開關不足以隔離 USB 供電。

PCF8574 長條板與 ULN2003 X113647／ZC-A0591 板的固定座仍需依實物試配調整。未確認尺寸前，先不要把導線焊死成無法拆卸。

## 空機測試與校正

先不放牌，確認四鍵與 OLED。用紙片擋兩顆光電，核對訊號變化；短暫點動取牌與出牌馬達，輪子應把牌推向出口。韌體序列診斷為 115200，可用 status 檢查感測器與 wifi_off、ble_off。

長按 SET 約 1 秒進入進階設定，選「圈數校正」，按 RUN 開始。空機校正約 1 至 2 分鐘，取得 4 個完整參考週期。若失敗，先查光電、齒輪打滑與供電。

分牌閘先以 0.45 mm 名義間隙起步，再按實際牌厚調到「一張通過、兩張受阻」。單一出口光電無法可靠辨識完全重疊的雙張，不能用計數正確代替分牌閘調整。

最後用少量牌測試，再試 10、54、108 張。測試通過才裝側維修蓋、前飾蓋並鎖閉底盒。28BYJ-48 搭配目前外部減速的逐張轉向速度較慢，尚未達成每秒 2 至 4 張的實測目標。

前往接線步驟 →前往最終調整 →

## 組裝示意圖

−原尺寸＋關閉 ✕

## 3D 組裝模型

關閉 ✕

## 完整逐腳接線圖

關閉 ✕

## 清除完成記錄

將清除這份手冊的 22 步完成勾選。零件與說明內容不會改變。

取消清除記錄
