shihkefa/esp32c3-card-dealer/V1.0.0/wiring/逐線接腳清單.csv

編號 | 起點焊孔 | 終點焊孔 | 網路 | 分組 | 說明
1 | 電池盒.+ | 1S保護板.B+ | BAT_RAW+ | power | 依圖上觀看方向接實體焊孔
2 | 電池盒.- | 1S保護板.B- | BAT_RAW- | power | 依圖上觀看方向接實體焊孔
3 | 1S保護板.P+ | TP4056.BAT+/B+ | PACK+ | power | 依圖上觀看方向接實體焊孔
4 | 1S保護板.P+ | SW1.1 | PACK+ | power | 依圖上觀看方向接實體焊孔
5 | SW1.2 | TPS61088.IN+ | PACK_SW+ | power | 依圖上觀看方向接實體焊孔
6 | 1S保護板.P- | TP4056.BAT-/B- | GND_FIXED | power | 依圖上觀看方向接實體焊孔
7 | 1S保護板.P- | TPS61088.IN- | GND_FIXED | power | 依圖上觀看方向接實體焊孔
8 | 1S保護板.P- | TPS61088.OUT- | GND_FIXED | power | 依圖上觀看方向接實體焊孔
9 | 1S保護板.P- | ESP.GND | GND_FIXED | power | 依圖上觀看方向接實體焊孔
10 | 1S保護板.P- | ULN2003.GND | GND_FIXED | power | 依圖上觀看方向接實體焊孔
11 | 1S保護板.P- | Q1.2=K | GND_FIXED | power | 依圖上觀看方向接實體焊孔
12 | 1S保護板.P- | Q1.4=E | GND_FIXED | power | 依圖上觀看方向接實體焊孔
13 | 1S保護板.P- | C1.- | GND_FIXED | power | 依圖上觀看方向接實體焊孔
14 | 1S保護板.P- | SR02.F | GND_FIXED | power | 依圖上觀看方向接實體焊孔
15 | TPS61088.OUT+ | JP-ESP5V.1 | +5V_M_FIXED | power | 依圖上觀看方向接實體焊孔
16 | TPS61088.OUT+ | ULN2003.+/VCC | +5V_M_FIXED | power | 依圖上觀看方向接實體焊孔
17 | TPS61088.OUT+ | R1.1 | +5V_M_FIXED | power | 依圖上觀看方向接實體焊孔
18 | TPS61088.OUT+ | C1.+ | +5V_M_FIXED | power | 依圖上觀看方向接實體焊孔
19 | TPS61088.OUT+ | SR01.F | +5V_M_FIXED | power | 依圖上觀看方向接實體焊孔
20 | JP-ESP5V.2 | ESP.5V | +5V_ESP | power | 依圖上觀看方向接實體焊孔
21 | ESP.3V3 | R3.1 | +3V3_FIXED | power | 依圖上觀看方向接實體焊孔
22 | ESP.3V3 | SR03.F | +3V3_FIXED | power | 依圖上觀看方向接實體焊孔
23 | ESP.GPIO0 | ULN2003.IN1 | ULN_IN1 | stepper | 依圖上觀看方向接實體焊孔
24 | ESP.GPIO1 | ULN2003.IN2 | ULN_IN2 | stepper | 依圖上觀看方向接實體焊孔
25 | ESP.GPIO3 | ULN2003.IN3 | ULN_IN3 | stepper | 依圖上觀看方向接實體焊孔
26 | ESP.GPIO4 | ULN2003.IN4 | ULN_IN4 | stepper | 依圖上觀看方向接實體焊孔
27 | ESP.GPIO21 | SR04.F | SDA_FIXED | ui | 依圖上觀看方向接實體焊孔
28 | ESP.GPIO20 | SR05.F | SCL_FIXED | ui | 依圖上觀看方向接實體焊孔
29 | ESP.GPIO5 | SR06.F | AIN1_FIXED | motor | 依圖上觀看方向接實體焊孔
30 | ESP.GPIO6 | SR07.F | AIN2_FIXED | motor | 依圖上觀看方向接實體焊孔
31 | ESP.GPIO7 | SR08.F | BIN1_FIXED | motor | 依圖上觀看方向接實體焊孔
32 | ESP.GPIO10 | R3.2 | EXIT_FIXED | sensor | 依圖上觀看方向接實體焊孔
33 | ESP.GPIO10 | SR09.F | EXIT_FIXED | sensor | 依圖上觀看方向接實體焊孔
34 | Q1.3=C | SR10.F | HOME_FIXED | sensor | 依圖上觀看方向接實體焊孔
35 | R1.2 | Q1.1=A | Q1_LED | sensor | 依圖上觀看方向接實體焊孔
36 | SR01.R | DRV8833.VCC | +5V_M_ROT | power | 依圖上觀看方向接實體焊孔
37 | SR01.R | R2.1 | +5V_M_ROT | power | 依圖上觀看方向接實體焊孔
38 | SR01.R | C2.+ | +5V_M_ROT | power | 依圖上觀看方向接實體焊孔
39 | SR01.R | DRV8833.EEP | +5V_M_ROT | power | 依圖上觀看方向接實體焊孔
40 | SR02.R | DRV8833.GND | GND_ROT | power | 依圖上觀看方向接實體焊孔
41 | SR02.R | DRV8833.IN4 | GND_ROT | power | 依圖上觀看方向接實體焊孔
42 | SR02.R | R5.2 | GND_ROT | power | 依圖上觀看方向接實體焊孔
43 | SR02.R | R6.2 | GND_ROT | power | 依圖上觀看方向接實體焊孔
44 | SR02.R | R7.2 | GND_ROT | power | 依圖上觀看方向接實體焊孔
45 | SR02.R | C2.- | GND_ROT | power | 依圖上觀看方向接實體焊孔
46 | SR02.R | OLED.GND | GND_ROT | power | 依圖上觀看方向接實體焊孔
47 | SR02.R | PCF.GND | GND_ROT | power | 依圖上觀看方向接實體焊孔
48 | SR02.R | SW2.2 | GND_ROT | power | 依圖上觀看方向接實體焊孔
49 | SR02.R | SW3.2 | GND_ROT | power | 依圖上觀看方向接實體焊孔
50 | SR02.R | SW4.2 | GND_ROT | power | 依圖上觀看方向接實體焊孔
51 | SR02.R | SW5.2 | GND_ROT | power | 依圖上觀看方向接實體焊孔
52 | SR02.R | Q2.2=K | GND_ROT | power | 依圖上觀看方向接實體焊孔
53 | SR02.R | Q2.4=E | GND_ROT | power | 依圖上觀看方向接實體焊孔
54 | SR03.R | OLED.VCC | +3V3_ROT | power | 依圖上觀看方向接實體焊孔
55 | SR03.R | PCF.VCC | +3V3_ROT | power | 依圖上觀看方向接實體焊孔
56 | SR03.R | R4.1 | +3V3_ROT | power | 依圖上觀看方向接實體焊孔
57 | SR04.R | OLED.SDA | SDA_ROT | ui | 依圖上觀看方向接實體焊孔
58 | SR04.R | PCF.SDA | SDA_ROT | ui | 依圖上觀看方向接實體焊孔
59 | SR05.R | OLED.SCL | SCL_ROT | ui | 依圖上觀看方向接實體焊孔
60 | SR05.R | PCF.SCL | SCL_ROT | ui | 依圖上觀看方向接實體焊孔
61 | SR06.R | DRV8833.IN1 | AIN1_ROT | motor | 依圖上觀看方向接實體焊孔
62 | SR06.R | R5.1 | AIN1_ROT | motor | 依圖上觀看方向接實體焊孔
63 | SR07.R | DRV8833.IN2 | AIN2_ROT | motor | 依圖上觀看方向接實體焊孔
64 | SR07.R | R6.1 | AIN2_ROT | motor | 依圖上觀看方向接實體焊孔
65 | SR08.R | DRV8833.IN3 | BIN1_ROT | motor | 依圖上觀看方向接實體焊孔
66 | SR08.R | R7.1 | BIN1_ROT | motor | 依圖上觀看方向接實體焊孔
67 | SR09.R | Q2.3=C | EXIT_ROT | sensor | 依圖上觀看方向接實體焊孔
68 | SR10.R | PCF.P4 | HOME_ROT | sensor | 依圖上觀看方向接實體焊孔
69 | SR10.R | R4.2 | HOME_ROT | sensor | 依圖上觀看方向接實體焊孔
70 | R2.2 | Q2.1=A | Q2_LED | sensor | 依圖上觀看方向接實體焊孔
71 | PCF.P0 | SW2.1 | KEY_SET | ui | 依圖上觀看方向接實體焊孔
72 | PCF.P1 | SW3.1 | KEY_MINUS | ui | 依圖上觀看方向接實體焊孔
73 | PCF.P2 | SW4.1 | KEY_PLUS | ui | 依圖上觀看方向接實體焊孔
74 | PCF.P3 | SW5.1 | KEY_RUN | ui | 依圖上觀看方向接實體焊孔
75 | DRV8833.OUT1 | N20.端子1 | M2_A | motor | 依圖上觀看方向接實體焊孔
76 | DRV8833.OUT1 | C3.1 | M2_A | motor | 依圖上觀看方向接實體焊孔
77 | DRV8833.OUT2 | N20.端子2 | M2_B | motor | 依圖上觀看方向接實體焊孔
78 | DRV8833.OUT2 | C3.2 | M2_B | motor | 依圖上觀看方向接實體焊孔
79 | DRV8833.OUT3 | RF300.端子1 | M3_A | motor | 依圖上觀看方向接實體焊孔
80 | DRV8833.OUT3 | C4.1 | M3_A | motor | 依圖上觀看方向接實體焊孔
81 | DRV8833.OUT4 | RF300.端子2 | M3_B | motor | 依圖上觀看方向接實體焊孔
82 | DRV8833.OUT4 | C4.2 | M3_B | motor | 依圖上觀看方向接實體焊孔
83 | ULN2003.M1 | 28BYJ.M1 | M1_HARNESS_1 | stepper | 依圖上觀看方向接實體焊孔
84 | ULN2003.M2 | 28BYJ.M2 | M1_HARNESS_2 | stepper | 依圖上觀看方向接實體焊孔
85 | ULN2003.M3 | 28BYJ.M3 | M1_HARNESS_3 | stepper | 依圖上觀看方向接實體焊孔
86 | ULN2003.M4 | 28BYJ.M4 | M1_HARNESS_4 | stepper | 依圖上觀看方向接實體焊孔
87 | ULN2003.M5 | 28BYJ.M5 | M1_HARNESS_5 | stepper | 依圖上觀看方向接實體焊孔
88 | SR01.F | SR01.R | SLIP_1 | power | 滑環內部已導通，非外加線
89 | SR02.F | SR02.R | SLIP_2 | power | 滑環內部已導通，非外加線
90 | SR03.F | SR03.R | SLIP_3 | power | 滑環內部已導通，非外加線
91 | SR04.F | SR04.R | SLIP_4 | ui | 滑環內部已導通，非外加線
92 | SR05.F | SR05.R | SLIP_5 | ui | 滑環內部已導通，非外加線
93 | SR06.F | SR06.R | SLIP_6 | motor | 滑環內部已導通，非外加線
94 | SR07.F | SR07.R | SLIP_7 | motor | 滑環內部已導通，非外加線
95 | SR08.F | SR08.R | SLIP_8 | motor | 滑環內部已導通，非外加線
96 | SR09.F | SR09.R | SLIP_9 | sensor | 滑環內部已導通，非外加線
97 | SR10.F | SR10.R | SLIP_10 | sensor | 滑環內部已導通，非外加線
