shihkefa/esp32c3-card-dealer/V1.0.0/3d/assembly_cutaway.png

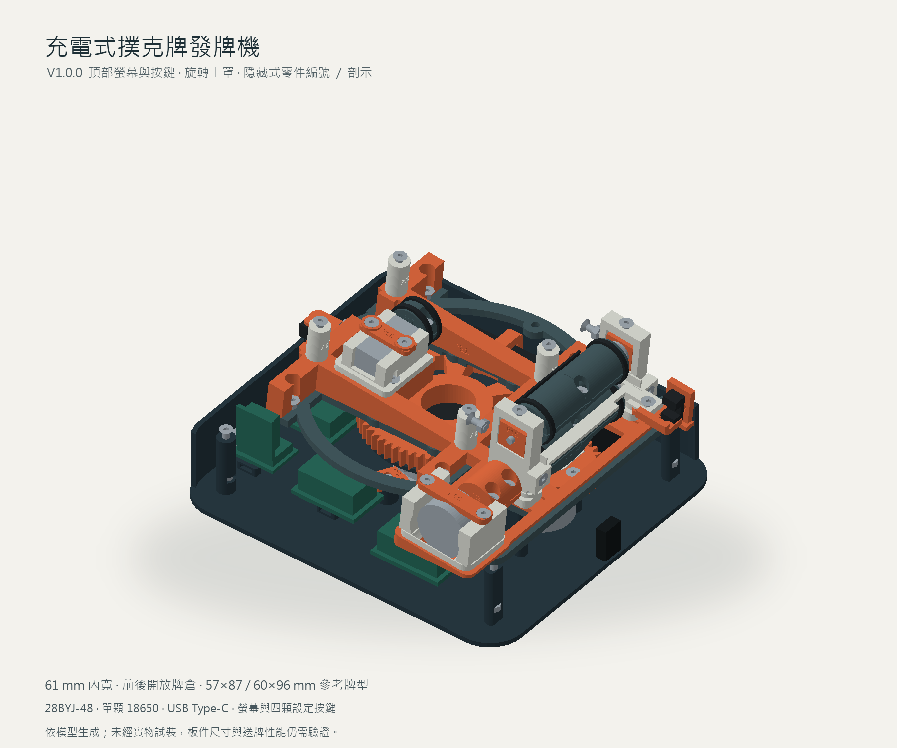
V1.0.0/3d/assembly_cutaway.png
