shihkefa/esp32c3-card-dealer/V1.0.0/manual/assets/figure15.jpg

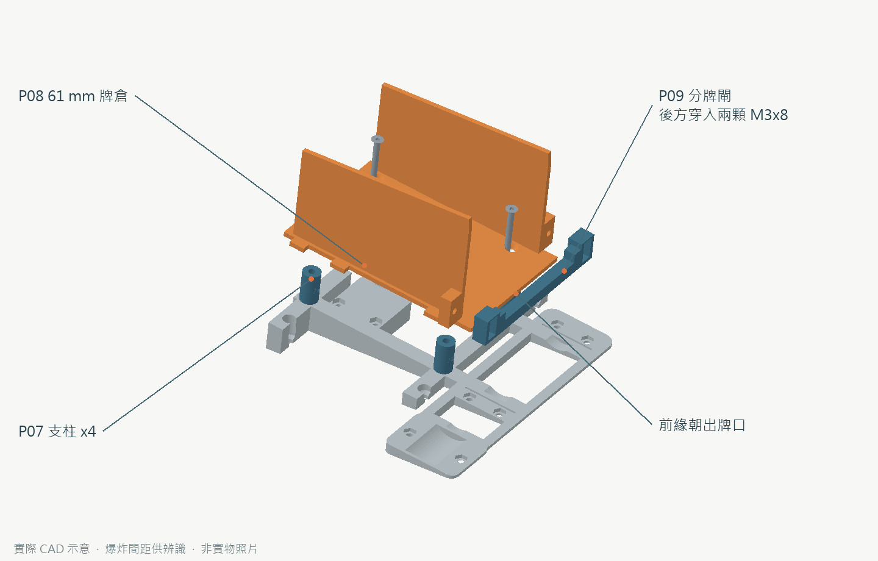
V1.0.0/manual/assets/figure15.jpg
