shihkefa/esp32c3-card-dealer/V1.0.0/source/references/wiring/itr9608-f-p2.png

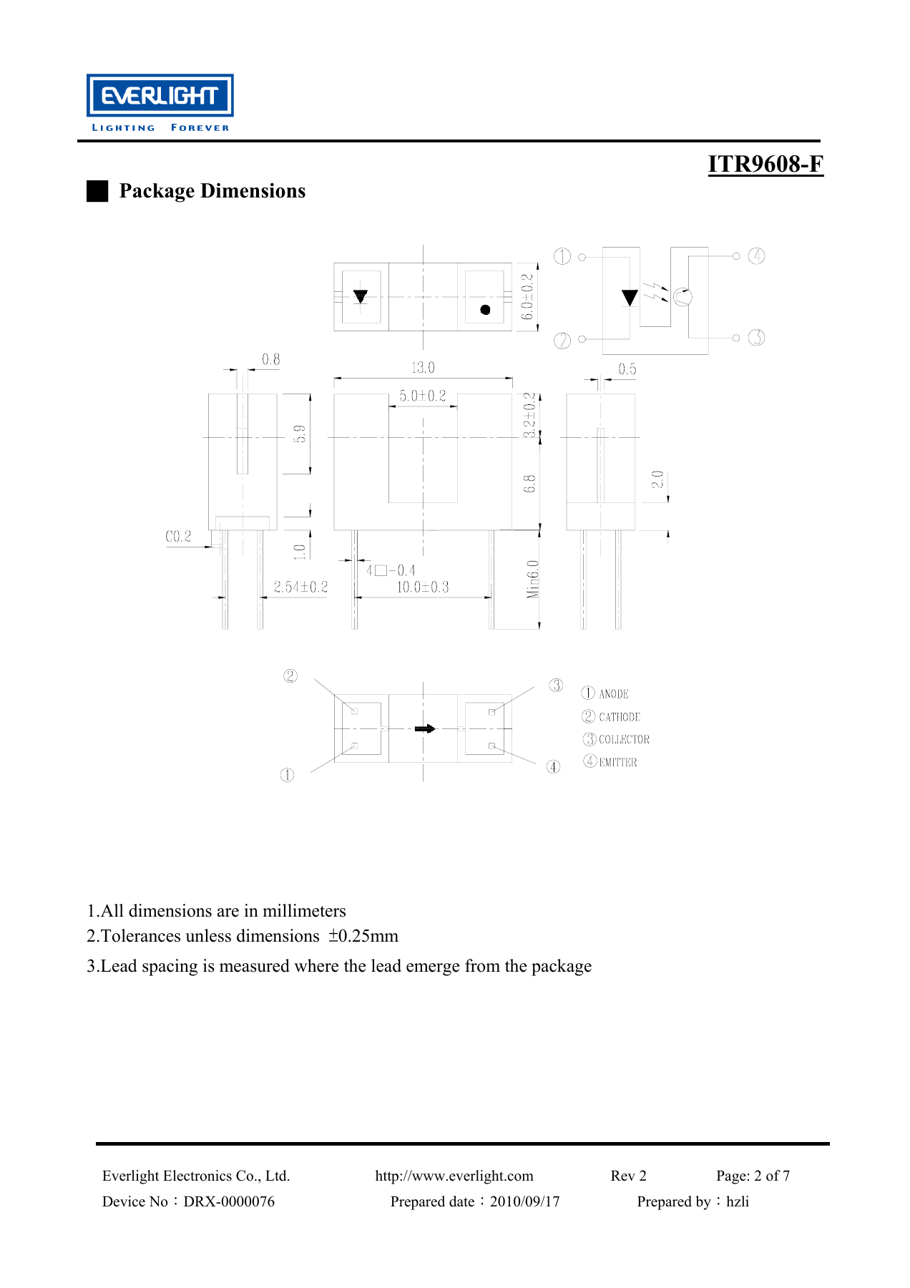
V1.0.0/source/references/wiring/itr9608-f-p2.png
