shihkefa/esp32c3-card-dealer/V1.0.0/verification/hopper-P08-printing-preview.png

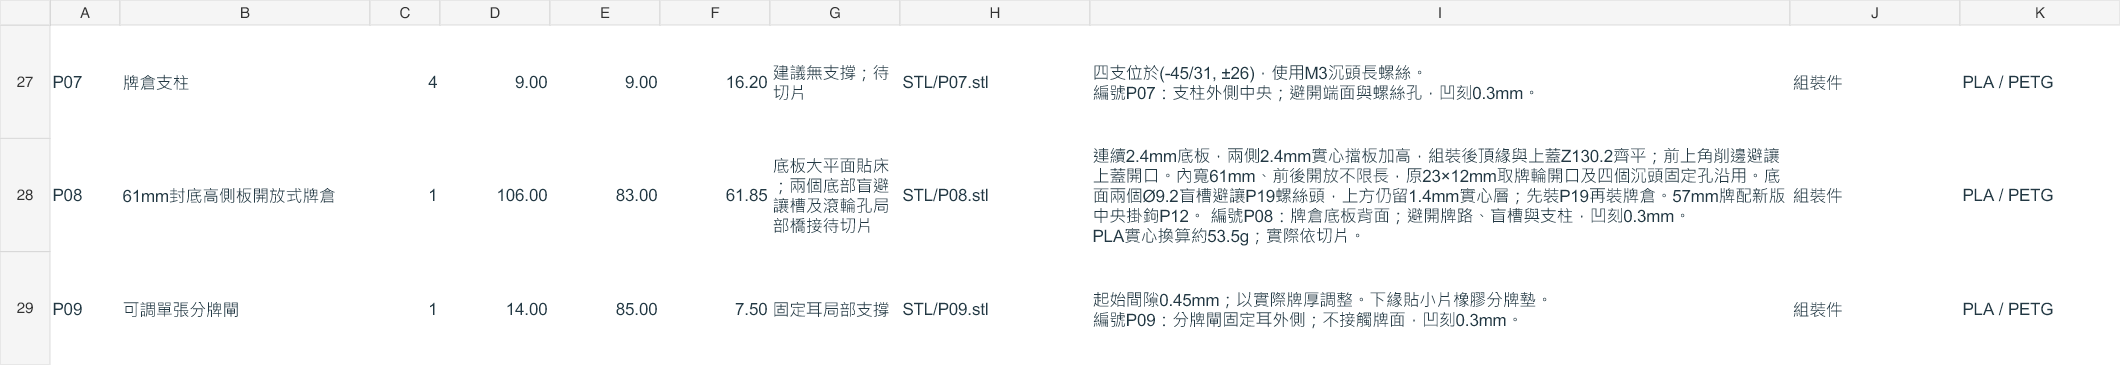
V1.0.0/verification/hopper-P08-printing-preview.png
