shihkefa/esp32c3-card-dealer/V1.0.0/verification/p05-printing-preview.png

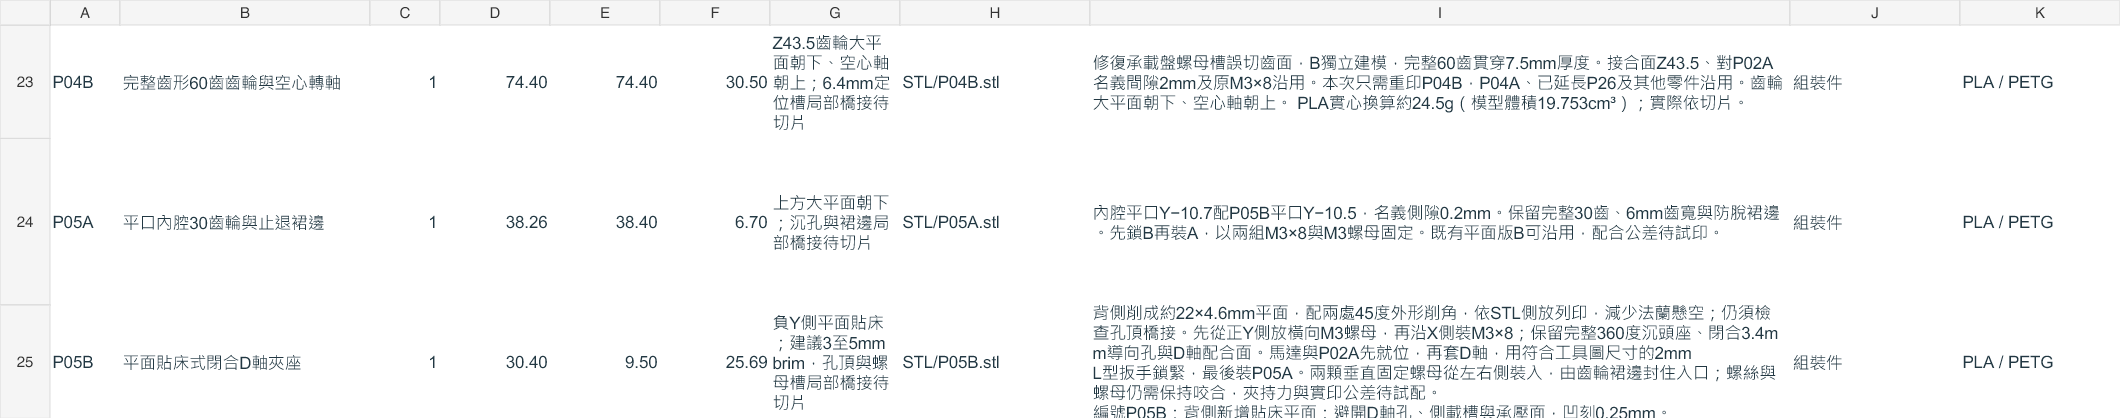
V1.0.0/verification/p05-printing-preview.png
