shihkefa/esp32c3-card-dealer/V1.0.0/verification/turntable-P04B-printing-preview.png

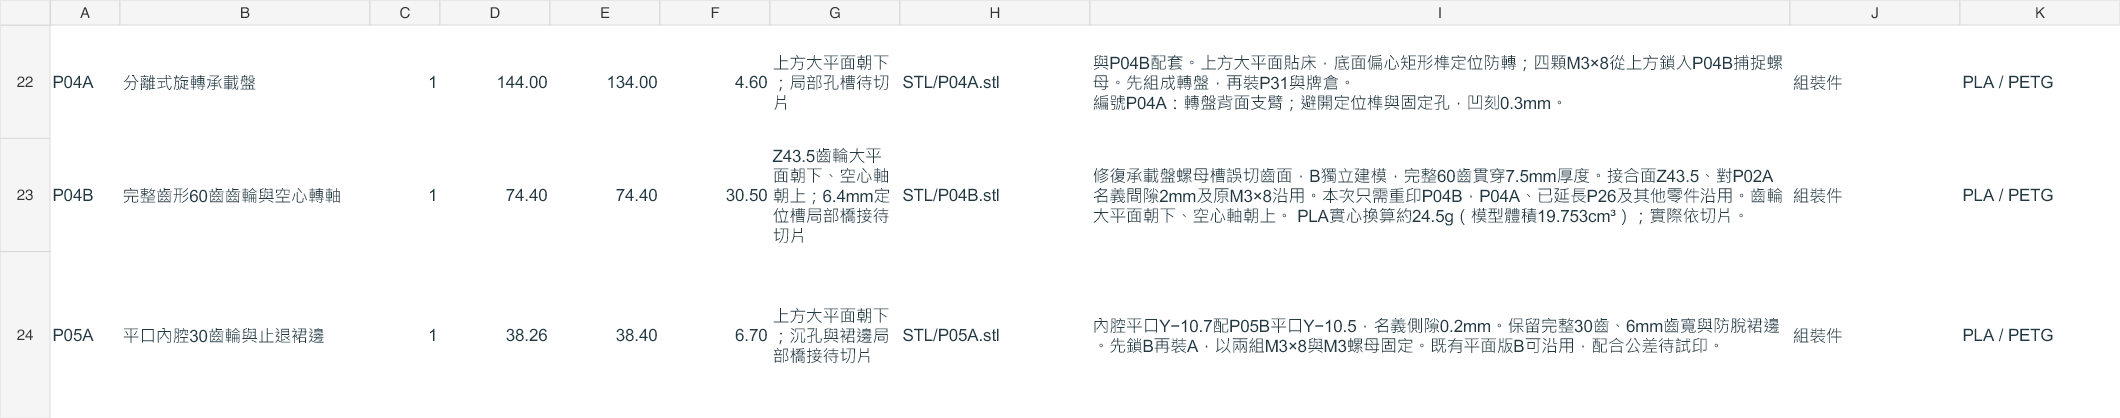
V1.0.0/verification/turntable-P04B-printing-preview.png
