shihkefa/esp32c3-card-dealer/V1.0.0/wiring/指定板型與觀看方向_A4.pdf

# 板型與觀看方向 1 / 4

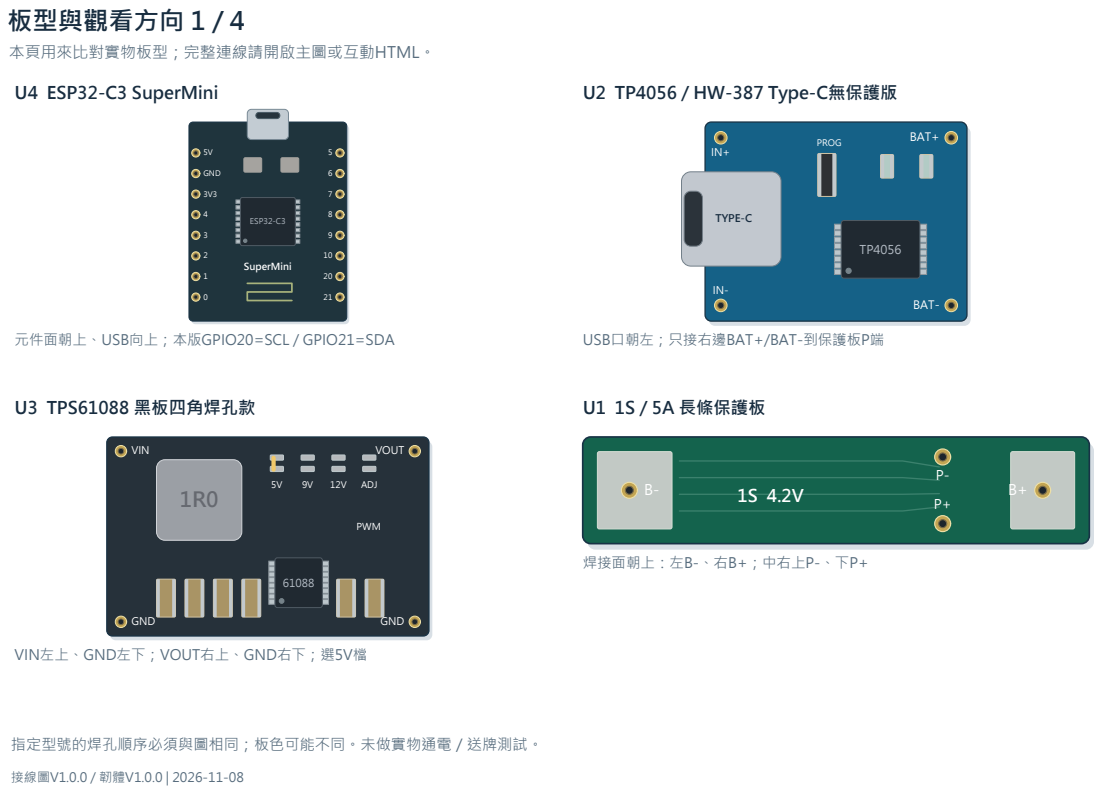
[picture p117: page 1]
本頁用來比對實物板型；完整連線請開啟主圖或互動HTML。; U4 ESP32-C3 SuperMini; ESP32-C3; SuperMini; GND; TYPE-C; PROG; BAT+; BAT-; U3 TPS61088 黑板四角焊孔款; ADJ; PWM; VIN; VOUT; U1 1S / 5A 長條保護板; 接線圖V1.0.0 / 韌體V1.0.0 | 2026-11-08

U2 TP4056 / HW-387 Type-C無保護版

元件面朝上、USB向上；本版GPIO20=SCL / GPIO21=SDA

USB口朝左；只接右邊BAT+/BAT-到保護板P端

焊接面朝上：左B-、右B+；中右上P-、下P+

VIN左上、GND左下；VOUT右上、GND右下；選5V檔

指定型號的焊孔順序必須與圖相同；板色可能不同。未做實物通電／送牌測試。

# 板型與觀看方向 2 / 4

1

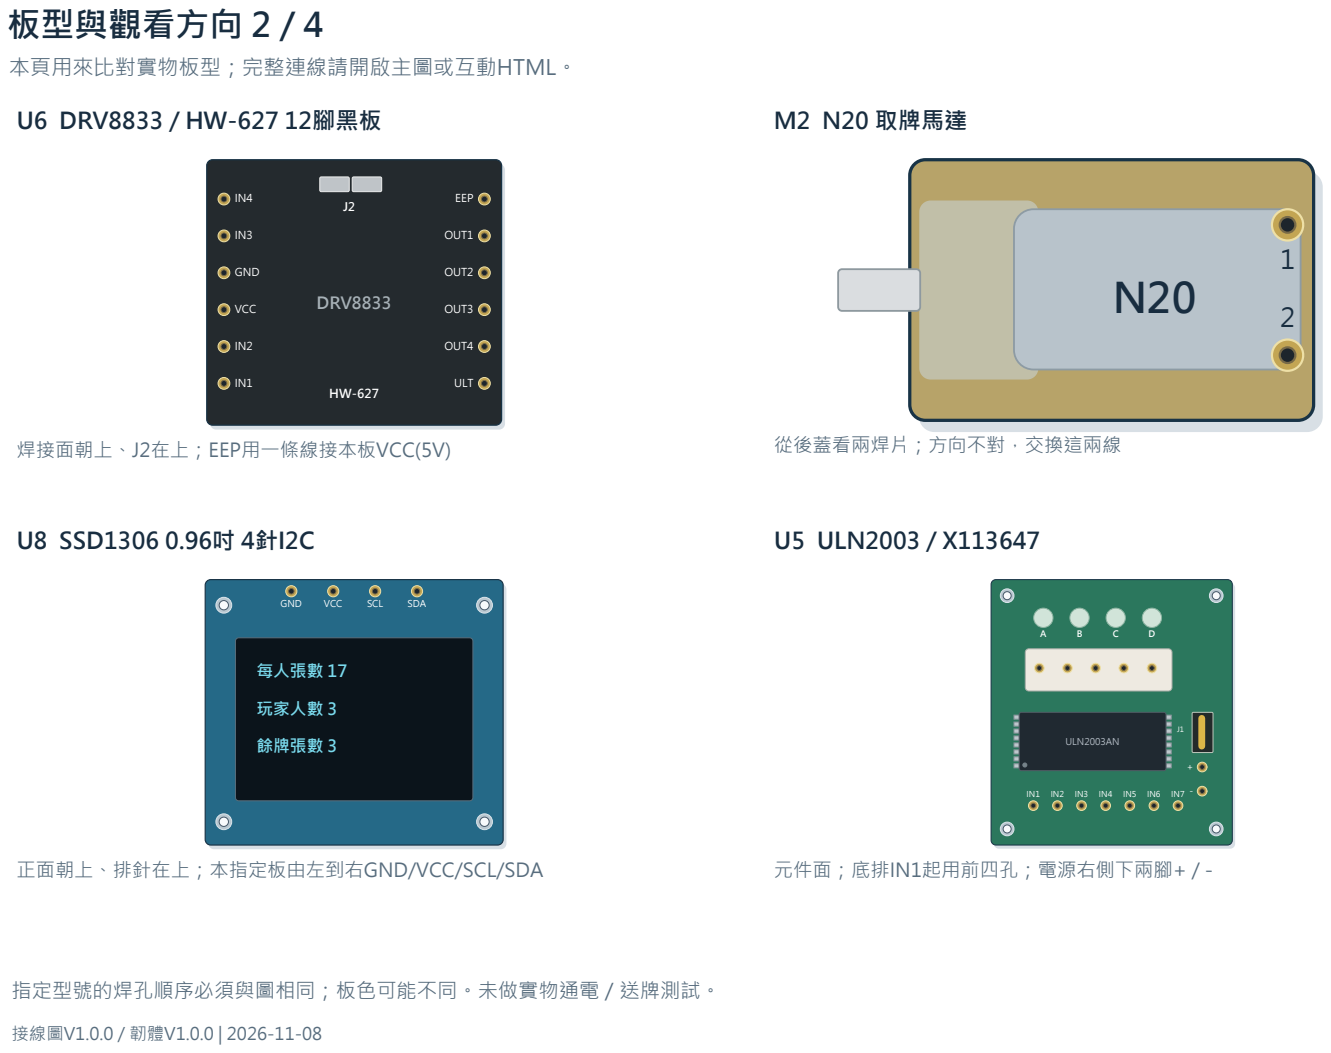
[picture p118: page 2]
U6 DRV8833 / HW-627 12腳黑板; DRV8833; GND; VCC; EEP; OUT1; OUT2; OUT3; OUT4; ULT; 焊接面朝上、J2在上；EEP用一條線接本板VCC(5V); M2 N20 取牌馬達; U8 SSD1306 0.96吋 4針I2C; SCL; SDA; 每人張數 17; 玩家人數 3; 餘牌張數 3; U5 ULN2003 / X113647; ULN2003AN; 元件面；底排IN1起用前四孔；電源右側下兩腳+ / -

從後蓋看兩焊片；方向不對，交換這兩線

正面朝上、排針在上；本指定板由左到右GND/VCC/SCL/SDA

# PCF8574T：背面排針與正面地址帽 3 / 4

## 背面 / 焊接面

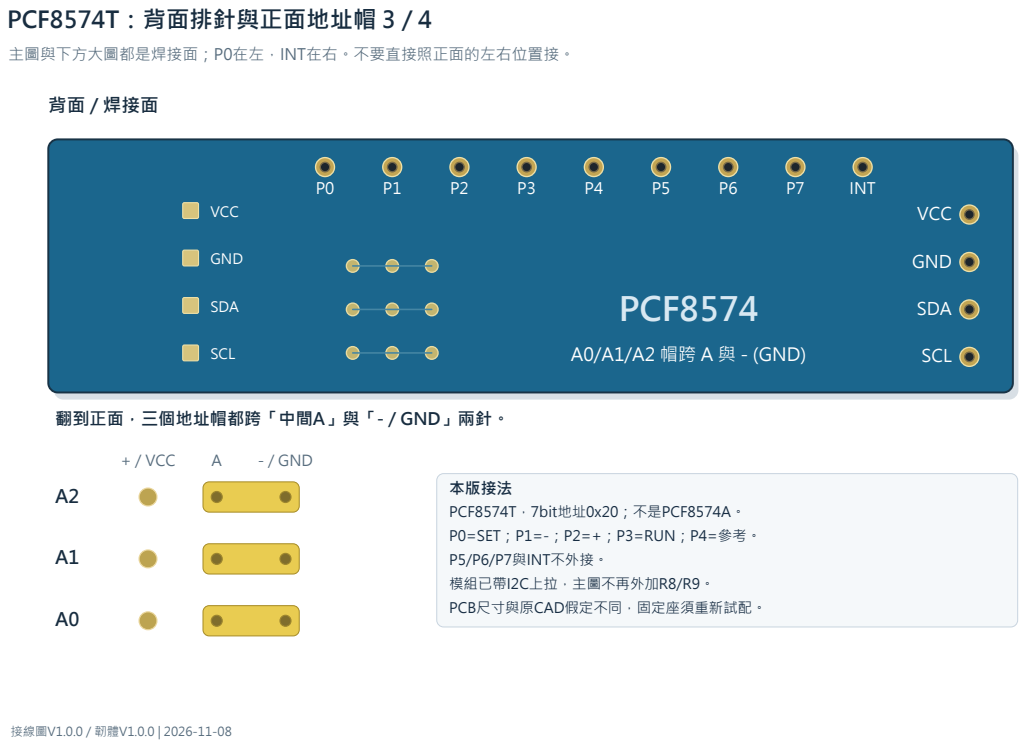
[picture p119: page 3]

翻到正面，三個地址帽都跨「中間A」與「- / GND」兩針。

# 光電、按鍵與供電操作 4 / 4

2=K

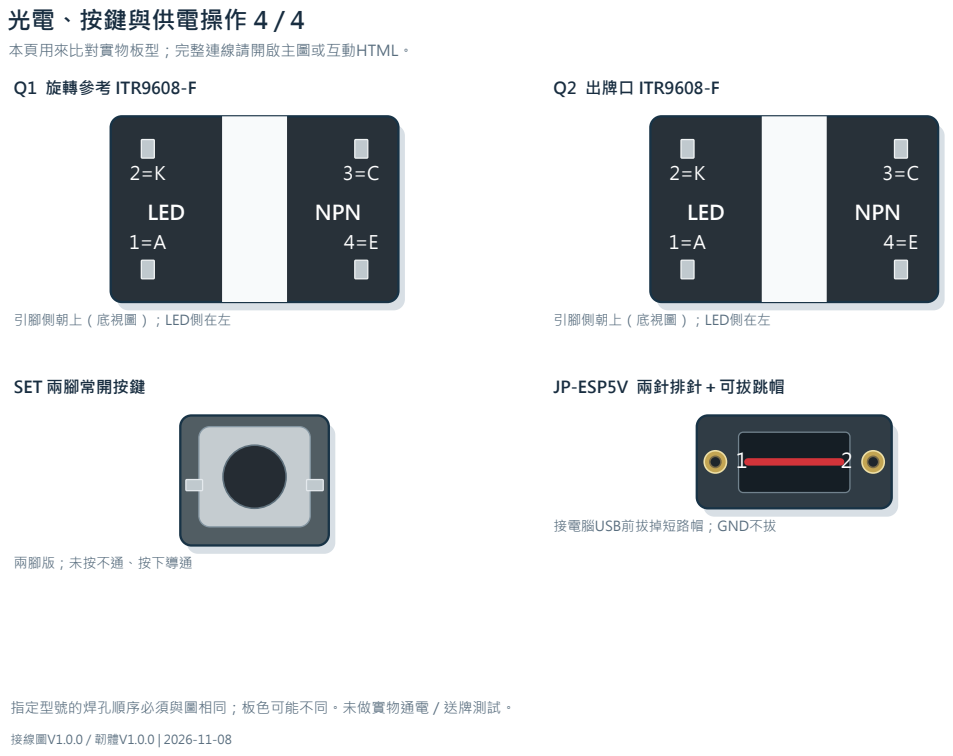
[picture p120: page 4]
Q1 旋轉參考 ITR9608-F; LED; NPN; Q2 出牌口 ITR9608-F; SET 兩腳常開按鍵; 接電腦USB前拔掉短路帽；GND不拔

引腳側朝上（底視圖）；LED側在左

JP-ESP5V 兩針排針＋可拔跳帽

兩腳版；未按不通、按下導通
