shihkefa/esp32c3-card-dealer/V1.0.0/wiring/發牌機_實物逐腳接線圖_A1.pdf

# 撲克牌發牌機 - 實物風格逐腳接線圖

## V1.0.0 | 沿著每一條彩色線即可找到兩端焊孔 | ESP32-C3 SuperMini / V1.0.0

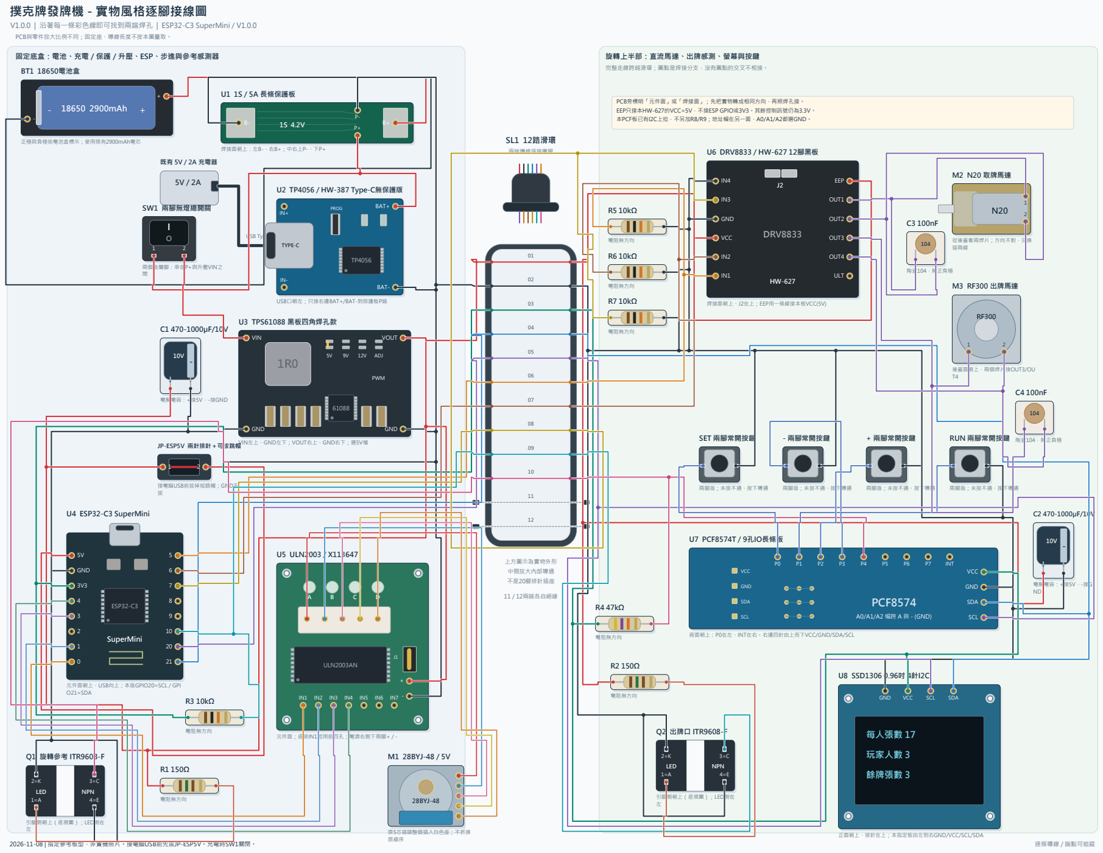
[picture p121: page 1]

PCB旁標明「元件面」或「焊接面」；先把實物轉成相同方向，再照焊孔接。
EEP只接本HW-627的VCC=5V，不接ESP GPIO或3V3。其餘控制訊號仍為3.3V。
本PCF板已有I2C上拉，不另加R8/R9；地址帽在另一面，A0/A1/A2都選GND。

焊接面朝上：左B-、右B+；中右上P-、下P+

USB口朝左；只接右邊BAT+/BAT-到保護板P端

VIN左上、GND左下；VOUT右上、GND右下；選5V檔

背面朝上：P0在左、INT在右。右邊四針由上而下VCC/GND/SDA/SCL

元件面朝上、USB向上；本版GPIO20=SCL / GPI
O21=SDA

正面朝上、排針在上；本指定板由左到右GND/VCC/SCL/SDA
