shihkefa/esp32c3-card-dealer/(commit log)

2026-11-11 Add complete V1.0.0 card dealer project with 2 mm turntable clearance
    [GPIO接線表.csv, P01.scad, P01.stl, P02A.scad, P02A.stl, P02B.scad, P02B.stl, P03.scad]
2026-11-11 Publish V1.0.0 3D assembly guide on GitHub Pages
2026-11-11 Fix P04B tooth cut and regenerate verified project assets
    [P04B.scad, P04B.stl, card_dealer.scad, 發牌機_BOM_V1.0.0.xlsx, 發牌機_整機組裝_V1.0.0.stl]
2026-11-11 Close P08 hopper floor and raise sidewalls flush with roof
    [P08.scad, P08.stl, P12.scad, P12.stl, card_dealer.scad, 發牌機_BOM_V1.0.0.xlsx, 發牌機_整機組裝_V1.0.0.stl]
